RobertCNelson/pandaboard-docs/PandaboardA1/PandaA1.md

Adding docs for PandaboardA1 that I have.
