RobertCNelson/pandaboard-docs/PandaboardA1/panda-a-bom.xls

 | Manufacturer BOM Report
Item Number: | 750-2152-010-EBOM
Description: | EBOM, OMAP4430 PANDA BOARD, OMAP ES2.1, 8-LYR
Item Revision: | D ECN-13192
Level | Number | Rev | Description | Qty | Ref Des
 | Mfr. Name | Mfr. Part Number
0 | 750-2152-010-EBOM | D ECN-13192 | EBOM, OMAP4430 PANDA BOARD, OMAP ES2.1, 8-LYR
. 1 | 111-1000329 | C ECN-12735 | RES,4.02-KOHM,1%,0.063W,0402 | 1 | R169
 | NIC COMPONENTS | NRC04F4021TRF
 | PANASONIC | ERJ2RKF4021X
 | ROHM | MCR01MZPF4021
 | VISHAY | CRCW04024K02FKED
 | YAGEO | 9T04021A4021FBHF3
. 1 | 111-1000415 | B ECN-12078 | CONN,6 IN 1 SD/MMC CARD CAGE | 1 | J14
 | KINGCONN | SDMM-B0-0011
 | KINGCONN | SDMM-B0-0016
. 1 | 111-1000424 | B ECN-12024 | RES,2.7K-OHM,1%,0.063W,0402 | 1 | R138
 | PANASONIC | ERJ2RKF2701X
 | SUSUMU | RR0510P-272-D
. 1 | 111-1000836 | A ECN-10973 | CAP,CER,X5R,0603,6.3V,20%,10UF | 7 | C131,C148,C152,C154,C187,C204,C211
 | MURATA | GRM188R60J106ME47D
 | PANASONIC | ECJ-1VB0J106M
 | TAIYO YUDEN | JMK107BJ106MA-T
. 1 | 111-1001043 | A ECN-11225 | CAP,CER,COG,0402,50V,5%,1NF | 4 | C12,C13,C170,C182
 | MURATA | GRM1555C1H102JA01D
. 1 | 111-1001162 | A ECN-11362 | LED,635NM,DIFFUSED,0603,RED | 1 | D3
 | LUMEX | SML-LX0603IW-TR
. 1 | 111-1001197 | A ECN-11400 | CAP, CER, C0G, 0402, 50V, 5%, 12PF | 2 | C120,C121
 | MURATA | GRM1555C1H120JZ01D
. 1 | 111-1001336 | A ECN-11770 | IC,TFP410,DVI1.0 COMPLIANT 24 BIT RGB TO DIGITAL SERIAL TRANSMITTER | 1 | U2
 | TI | TFP410PAP
. 1 | 111-1001422 | A ECN-11612 | CAP, CER, X5R, 0402, 10V, 10%, 220NF | 2 | C72,C143
 | MURATA | GRM155R61A224KE19D
. 1 | 111-1001870 | A ECN-12093 | ESD PROTECTION ARRAY, 3-CHANNEL, +/-15KV, LOW CAPACITANCE | 1 | U25
 | TI | TPD3E001DRYR
. 1 | 111-1001969 | A ECN-11991 | IC,TWO BIT BI-DIRECTIONAL TRANSLATOR,TXS0102DCUR,VSSOP-DCU-8 | 1 | U3
 | TI | TXS0102DCUR
. 1 | 111-1002211 | A ECN-12174 | IC,REGULATOR,LDO,FIXED 3.3V,400MA,SOT23 | 1 | U11
 | TI | TPS73633DBVR
. 1 | 111-1002268 | A ECN-12268 | CAP,CER,X5R,0201,6.3V,10%,0.1UF | 58 | C20,C22,C27,C28,C29,C36,C38,C40,C41,C42,C44,C46,C47,C48,C49,C54,C57,C58,C59,C61,C62,C63,C69,C70,C74,C77,C78,C79,C80,C83,C84,C85,C89,C93,C94,C95,C101,C102,C108,C112,C113,C116,C119,C123,C127,C128,C134,C135,C138,C139,C140,C142,C144,C183,C189,C191,C195,C217
 | MURATA | GRM033R60J104KE19D
. 1 | 111-1002513 | B ECN-12929 | IC, 8-CHANNEL HDMI PORT EMI FILTER W/ ESD PROTECTION, 28WCSP | 1 | U6
 | TI | TPD12S015YFFR
. 1 | 111-1002519 | A ECN-12578 | IC,TPD6E001, 6 CHANNEL LOW CAPACITANCE 15KV ESD PROTECTION ARRAY, RSE | 2 | U16,U18
 | TI | TPD6E001RSER
. 1 | 111-1002526 | B ECN-12671 | CRYSTAL, SM, 32.768KHZ, 12.5PF-LOAD, ±20PPM @ -40 TO+85 C, MINIATURE CERAMIC (3X1.5X0.9MM) | 1 | Y2
 | CITIZEN | CM315
 | CITIZEN | CM315 32.768KDZF
. 1 | 111-1002534 | A ECN-12516 | CAP,CER,X5R,0402,10V,10%,1UF | 8 | C11,C43,C45,C88,C90,C92,C99,C100
 | MURATA | GRM155R61A105KE15D
. 1 | 111-1002537 | A ECN-12578 | CAP,CER,X5R,0402,6.3V,20%,2.2UF | 25 | C26,C33,C51,C52,C103,C104,C105,C106,C107,C109,C110,C115,C118,C124,C129,C133,C145,C149,C164,C165,C166,C167,C168,C194,C200
 | DIGIKEY | 490-4519-2-ND
 | TAIYO YUDEN | JMK105BJ225MV-F
. 1 | 111-1002559 | A ECN-12578 | RES,1K-OHM,1%,0.05W,0201 | 3 | R32,R89,R95
 | PANASONIC | ERJ1GEF1001C
 | ROHM | MCR006YZPF1001
. 1 | 111-1002575 | A ECN-12578 | IND, CHIP COIL, 1UH, 20%, 1200MA, SMT (SIZE 2520) | 1 | L6
 | FDK | MIPS2520D1R0
 | TAIYO YUDEN | CKP25201R0M-T
. 1 | 111-1002658 | A ECN-12578 | CAP,CER,X5R,0402,10V,10%,470NF | 12 | C37,C39,C60,C68,C73,C86,C122,C136,C137,C141,C190,C193
 | MURATA | GRM155R61A474KE15D
. 1 | 111-1002664 | B ECN-12684 | RES, 240 OHM, 1%, 0.063W, 0402 | 2 | R77,R87
 | ROHM | MCR01MZPF2400
 | VISHAY | CRCW0402240RFKED
. 1 | 111-1002666 | A ECN-12578 | INDUCTOR, CHIP, 1UH, 0805, 20%, 800MA,DCR=0.19OHMS | 5 | L9,L10,L14,L19,L20
 | MURATA | LQM21PN1R0MC0D
. 1 | 111-1002671 | A ECN-12578 | FERRITE BEAD, 120 OHM @ 100 MHZ, 1300MA, SMT, 0402 | 7 | L8,L11,L13,L21,L22,L24,L25
 | MURATA | BLM15PD121SN1D
. 1 | 111-1002680 | A ECN-12578 | INDUCTOR, CHIP, 68NH, 0402, 5%, 180MA, DCR=0.92OHMS | 1 | L26
 | MURATA | LQG15HS68NJ02D
. 1 | 111-1002717 | A ECN-12644 | CONN,RECEPTACLE,USB MINI-AB,5-PIN,SMT | 1 | J18
 | MOLEX | 56579-0576
. 1 | 111-1002735 | A ECN-12640 | FERRITE BEAD, 220 OHM @ 100 MHZ, 2200MA, SMT, 0603 | 8 | L1,L4,L5,L7,L12,L16,L18,L23
 | MURATA | BLM18KG221SN1D
. 1 | 111-1002740 | B ECN-12699 | FUSE, 2A FASTBLOW 32V, 0402, LITTLEFUSE 435 SERIES | 1 | F1
 | LITTELFUSE | 0435002.KR
 | LITTELFUSE | 0435002.KRHF
. 1 | 111-1002741 | B ECN-12699 | CAP, TANT, 7343, 25V, 20%, 47UF, POL | 1 | C171
 | AVX | TAJD476K025RNJ
 | VISHAY | 293D476X0025D2TE3
. 1 | 111-1002743 | B ECN-12977 | CAP,CER,X5R,0402,6.3V,+20%/-15%,4.7UF | 13 | C32,C34,C130,C147,C150,C153,C155,C158,C159,C176,C177,C181,C186
 | MURATA | GRM155R60J475ME87D
. 1 | 111-1002932 | A ECN-12736 | IC, USB TRANSCEIVER, HS, ULPI, INPUT/OUTPUT CLOCK MODES, QFN SMT | 1 | U8
 | SMSC | USB3320C-EZK
. 1 | 111-1002952 | A ECN-12742 | IC,INTEGRATED LOAD SWITCH,20V,SUPERSOT-6 | 2 | U15,U17
 | FAIRCHILD SEMI | FDC6330L
. 1 | 111-1003077 | A ECN-12864 | RES,3.32K-OHM,1%,0.063W,0402 | 6 | R90,R102,R109,R123,R128,R142
 | VISHAY | CRCW04023321F100
. 1 | 111-1003079 | A ECN-13015 | RES,33-OHM,1%,0.05W,0201 | 42 | R40,R41,R42,R43,R45,R46,R48,R49,R50,R51,R52,R53,R54,R64,R65,R66,R67,R68,R69,R70,R71,R72,R73,R76,R78,R80,R81,R82,R83,R84,R85,R112,R113,R117,R118,R120,R121,R124,R125,R126,R127,R140
 | ROHM | MCR006YZPF33R0
. 1 | 111-1003122 | A ECN-12895 | IC, LPDDR2, POP, OMAP4, (8 GBIT - 2GBIT X 4), 200MHZ, ELPIDA | 1 | UX10
 | ELPIDA | EDB8064B1PB-8D-F
. 1 | 111-1003139 | A ECN-12903 | CAP, CER, 22UF, X5R, 0805, +/-20%, 4V, 0.85MM THICK | 1 | C82
 | MURATA | GRM219R60G226ME66D
. 1 | 111-1003162 | A ECN-12925 | CONN, DB9 FEMALE,R/A, SOLDER SMD | 1 | P4
 | NORCOMP | 190-009-263R001
. 1 | 111-1003169 | A ECN-12925 | RES, 12.4K-OHM, 1%, 1/16W, 0402 | 2 | R23,R106
 | KOA SPEER | RK73G1ETTP1242F
 | KOA SPEER | RK73H1ETTP1242F
 | PANASONIC | ERJ2RKF1242X
 | ROHM | MCR01MZPF1242
 | YAGEO | RC0402FR-0712K4
. 1 | 111-1003172 | A ECN-12925 | IC, ETHERNET CONTROLLER/USB 4 PORT HUB, 10/100 ETHERNET | 1 | U9
 | SMSC | LAN9514-JZX
. 1 | 111-1003175 | A ECN-12948 | CRYSTAL, 25 MHZ, 8 PF, SMD, 8.0X4.5X1.8MM | 1 | Y1
 | DIGIKEY | 644-1028-1-ND
 | NDK | NX8045GB-25.000000MHZ
. 1 | 111-1003192 | A ECN-12925 | IC, LDO REGULATOR, ADJ, 1.5A, FAST, HIGH PSRR, 340MV DROPOUT, SOT223-6 | 1 | U23
 | TI | TL1963ADCQR
. 1 | 111-1003197 | A ECN-12925 | IC, PWR SWITCH+ADJ LDO,14-HTSSOP | 1 | U22
 | TI | TPS2141IPWP
. 1 | 111-1003199 | A ECN-12946 | IC, TPS2054B CURRENT LTD POWER DISTRIBUTION SWITCH | 1 | U7
 | TI | TPS2054BD
. 1 | 111-1003202 | A ECN-12948 | RES, 620K-OHM, 1%, 0.063W, 0402 | 1 | R172
 | PANASONIC | ERJ2RKF6203X
 | ROHM | MCR0004YZPF6203
 | VISHAY | CRCW0402620KFKEA
. 1 | 111-1003203 | A ECN-12948 | CONN, POWER JACK, 2.1MM, TH | 1 | P3
 | CUI INC | PJ-002A
 | DIGIKEY | CP-002A-ND
. 1 | 111-1003204 | A ECN-12948 | IC, 4-BIT BIDIRECTIONAL VOLTAGE TRANSLATOR, TXS0104 | 1 | U21
 | DIGIKEY | 296-20699-1-ND
 | DIGIKEY | 296-20699-2-ND
 | MOUSER ELECTRONICS | 595-TXS0104EZXUR
 | TI | TXS0104EZXUR
. 1 | 111-1003206 | A ECN-12948 | CAP, 100UF, 10V, SMT, 10%, 6032 | 4 | C21,C25,C75,C76
 | KEMET | B45196H2107K309
 | VISHAY SPRAGUE | 293D107X9010C2TE3
. 1 | 111-1003207 | A ECN-12948 | IC, SUPERVISOR, VOLT DETECTOR ADJ/1.5V, SC70-5 | 1 | U20
 | TI | TPS3803G15DCKR
. 1 | 111-1003208 | A ECN-12948 | CONN, RCPT, HDMI, R/A,SMD, TYPE A | 2 | P1,P2
 | DIGIKEY | 609-1010-1-ND
 | DIGIKEY | 609-1010-2-ND
 | FCI CONNECTORS | 10029449-001RLF
. 1 | 111-1003238 | A ECN-12967 | ANTENNA, 2.4GHZ BAND, CERAMIC CHIP | 1 | ANT1
 | TDK | ANT040015CCS2442MA1
. 1 | 111-1003239 | A ECN-12967 | CAP,CER. 0.3PF, 0402 | 1 | C9
 | JOHANSON TECHNOLOGY | 500R07S0R3BV4T
. 1 | 111-1003240 | A ECN-12967 | INDUCTOR 3.0NH CERAMIC 0402 | 1 | L3
 | JOHANSON TECHNOLOGY | L-07C3N0SV6T
. 1 | 111-1003245 | B ECN-13002 | CONNECTOR, USBX2 TYPE A AND 10/100BASE-TX ETHERNET STACKED WITH MAGNETICS AND LEDS | 1 | J9
 | BEL FUSE INC | 08C2-1X1T-03
 | BEL FUSE INC | 08C2-1X1T-36
 | TYCO | 6620004-1
. 1 | 111-1003247 | A ECN-12975 | CONN,DUAL 3.5MM AUDIO,STACKED | 1 | J16
 | KYCON | STX-4235-3/3-N
. 1 | 111-1003351 | A ECN-13015 | IND, 1.0UH, 3.0A, 1210, +/-20% | 1 | L17
 | MURATA | LQM32PN1R0MG0
. 1 | 111-1003359 | A ECN-13015 | INDUCTOR, CHIP, 0.68UH, 2 X 2 X 1MM, SHIELDED | 1 | L15
 | COILCRAFT | EPL2010-681MLC
. 1 | 111-1003381 | A ECN-13019 | CONN, HEADER,2X7, 2.54MM PITCH, THROUGH-HOLE | 1 | J8
 | FCI CONNECTORS | 67997-414HLF
. 1 | 111-1003382 | B ECN-13096 | IC, PHOENIX POWER, ES2.0, 7X7MM, 256 BALLS, 0.4MM PITCH, TWL6030 | 1 | U12
 | TI | PTWL6030BCMR
. 1 | 111-1003383 | A1 ECN-13082 | IC, PHOENIX AUDIO, ES1.1, 6X6MM, PBGA-120, 0.5MM PITCH, TWL6040 | 1 | U19
 | TI | TWL6040A1ZQZ
. 1 | 111-1003389 | B ECN-13028 | IC, RS-232 TRANSCEIVER, 3V-5.5V, 250KB/S, 16-SOP | 1 | U24
 | TI | MAX3232CDR
 | TI | MAX3232IDR
 | TI | SN65C3232EDR
 | TI | SN75C3232EDR
 | TI | TRS3232CDR
 | TI | TRS3232IDR
. 1 | 111-1003391 | B ECN-13162 | MODULE, RF, WL1271, 802.11B/G+BLUETOOTH | 1 | U4
 | LS RESEARCH | 450-0009
. 1 | 111-1003408 | A ECN-12939 | CAP, CER, X5R, 0402, 2.5V,+/-20%, 10UF | 5 | C146,C151,C156,C160,C161
 | MURATA | GRM155R60E106ME16D
. 1 | 111-1003414 | A ECN-12670 | INDUCTOR, CHIP, 82NH, 0603, 5%, 300MA, DCR=0.85OHMS | 1 | L27
 | MURATA | LQG18HN82NJ00D
. 1 | 111-1003454 | C ECN-13164 | OSC, 38.400 MHZ, 1.8V, CMOS, SMD, 5.0 X 3.2MM | 1 | Y3
 | TXC | 7C38470004
 | VECTRON | VC-801-JAW-KAAN-38M4000000
 | VECTRON | VCC4-H3B-38M4000000
. 1 | 111-1003474 | A ECN-12753 | PULSEGUARD, ESD SUPRESSOR, 0603, 24VDC, 45A | 4 | D4,D5,D6,D7
 | DIGIKEY | F2594TR-ND
 | LITTELFUSE | PGB1010603MR
. 1 | 111-1003493 | A1 ECN-13166 | IC, OMAP4430 PROCESSOR, ES2.1, GP, 12X12MM, FCPOP1 | 1 | U10
 | TI | X4430CCBL
 | TI | X4430CCBS
. 1 | 111-1003550 | A ECN-13172 | IC, 4-BIT BIDIRECTIONAL VOLTAGE TRANSLATOR, TXB0104 | 1 | U13
 | TI | TXB0104ZXUR
. 1 | 111-1003572 | A ECN-13192 | IC,SCHMITT-TRIGGER BUFFER, LOW PWR, 0.8V TO 3.6V,-40°C TO +85°C,SC-70 | 1 | U14
 | TI | SN74AUP1G17DCKR
. 1 | 207-0054-000 | A PNR-10008 | CAP,CER,X7R,0402,16V,10%,0.01UF | 3 | C126,C188,C192
 | AVX | 0402YC103KAT2A
 | KEMET | C0402C103K4RAC
 | PANASONIC | ECJ0EB1C103K
. 1 | 207-0068-000 | A PNR-10008 | CAP,CER,X5R,0402,10V,10%,100NF | 44 | C7,C8,C10,C14,C15,C17,C18,C19,C24,C30,C31,C35,C53,C55,C56,C64,C65,C66,C67,C71,C81,C87,C111,C125,C132,C157,C162,C163,C172,C173,C174,C175,C179,C180,C185,C197,C201,C202,C206,C207,C212,C213,C214,C215
 | AVX | 0402ZD104KAT2A
 | KEMET | C0402C104K8PAC
 | MURATA | GRM155R61A104KA01
 | PANASONIC | ECJ0EB1A104K
. 1 | 207-0105-000 | A PNR-10105 | CAP,CER,X5R,0805,10V,10%,4.7UF | 1 | C208
 | MURATA | GRM219R61A475KE19J
 | PANASONIC | ECJ2FB1A475K
. 1 | 207-0165-000 | B ECN-12775 | CAP,CER,X5R,0603,6.3V,10%,4.7UF | 5 | C23,C50,C196,C198,C199
 | AVX | 06036D475KAT2A
 | MURATA | GRM188R60J475KE19D
. 1 | 207-0226-000 | A PNR-10105 | CAP,CER,NPO,0402, 50V, 5%, 18PF | 4 | C97,C98,C203,C205
 | AVX | 04025A180JAT2A
 | KEMET | C0402C180J5GAC
. 1 | 257-0020-000 | A PNR-10074 | LED,565NM,WATER-CLEAR,3216,GRN | 2 | D1,D2
 | LITEON ELECTRONICS | LTST-C150GKT
. 1 | 272-0029-000 | B ECN-10775 | RES,10K-OHM,1%,0.063W,0402 | 18 | R28,R30,R31,R36,R39,R55,R56,R57,R58,R60,R79,R86,R99,R100,R114,R141,R147,R170
 | PANASONIC | ERJ2RKF1002X
 | ROHM | MCR01MZPF1002
. 1 | 272-0065-000 | B ECN-12846 | RES,0.0-OHM,RES-MAX-60M-OHM,CUR-MAX1A,0402,JUMPER | 24 | R6,R7,R8,R9,R10,R11,R12,R13,R14,R15,R19,R20,R21,R22,R25,R26,R27,R59,R62,R63,R92,R150,R151,R160
 | KOA SPEER ELECTRONICS, INC. | RK73Z1ETTP
 | PANASONIC | ERJ2GE0R00X
. 1 | 272-0093-000 | A PNR-10081 | RES,10-OHM,1%,0.063W,0402 | 1 | R133
 | KOA | RK73H1ETTD10R0F
 | PANASONIC | ERJ2RKF10R0X
. 1 | 272-0177-000 | B ECN-10775 | RES,100K-OHM,1%,0.063W,0402 | 5 | R149,R153,R158,R162,R168
 | PANASONIC | ERJ2RKF1003X
 | ROHM | MCR01MZPF1003
. 1 | 272-0198-000 | B ECN-10775 | RES,100-OHM,1%,0.063W,0402 | 2 | R108,R132
 | PANASONIC | ERJ2RKF1000X
 | ROHM | MCR01MZPF1000
. 1 | 272-0200-000 | A PNR-10084 | RES,1K-OHM,1%,0.063W,0402 | 1 | R152
 | PANASONIC | ERJ2RKF1001X
 | ROHM | MCR01MZSF102
. 1 | 272-0206-000 | A PNR-10085 | RES,1M-OHM,1%,0.063W,0402 | 2 | R110,R139
 | KOA | RK73H1ELTD1004F
 | PANASONIC | ERJ2RKF1004X
 | ROHM | MCR01MZSF105
 | YAGEO | 9C04021A1004FLHF3
. 1 | 272-0209-000 | B ECN-12685 | RES,4.7K-OHM,1%,0.063W,0402 | 3 | R1,R24,R29
 | KOA | RK73H1ELTD4701F
 | KOA | RK73H1ETTP4701F
. 1 | 272-0251-000 | A PNR-10093 | RES,510-OHM,1%,0.063W,0603 | 1 | R17
 | PANASONIC | ERJ3EKF5100V
. 1 | 272-0270-000 | B ECN-10874 | RES,150K-OHM,1%,0.063W,0402 | 2 | R154,R167
 | KOA SPEER | RK73H1ETTP1503F
 | ROHM | MCR01MZSF1503
. 1 | 272-0349-000 | B ECN-12894 | RES,390-OHM,5%,0.250W,1206 | 1 | R165
 | KOA | RK73B2BLTD391J
 | PANASONIC | ERJ-8GEYJ391V
 | ROHM | MCR18EZPJ391
 | STACKPOLE ELECTRONICS | RMCF1206JT390R
 | VISHAY | CRCW1206390RJNEA
 | YAGEO | RC1206JR-07390RL
. 1 | 272-0381-000 | A PNR-10086 | RES,200K-OHM,1%,0.063W,0402 | 1 | R173
 | PANASONIC | ERJ2RKF2003X
. 1 | 272-0421-000 | A PNR-10089 | RES,330-OHM,5%,0.063W,0402 | 2 | R91,R96
 | PANASONIC | ERJ2GEJ331X
 | ROHM | MCR01MZSJ331
. 1 | 272-0426-000 | B ECN-12932 | RES,33K-OHM,1%,0.063W,0402 | 1 | R164
 | ROHM | MCR01MZSF333
 | YAGEO | 9C04021A3302FLHF3
 | YAGEO | RC0402FR-0733KL
. 1 | 272-0444-000 | A.1 ECN-10669 | RES,0.0-OHM,5%,0.125W,0805 | 1 | R4
 | VISHAY | CRCW08050000Z0EA
 | YAGEO | RC0805JR-130R0
. 1 | 272-0457-000 | C ECN-11298 | RES,49.9-OHM,1%,0.063W,0402 | 6 | R107,R111,R116,R129,R155,R156
 | KOA SPEER | RK73H1ETTP49R9F
 | YAGEO | 9C04021A49R9FLHF3
 | YAGEO | RC0402FR-0749R9L
. 1 | 272-0473-000 | B ECN-12692 | RES,8.06K-OHM,1%,0.100W,0603 | 1 | R47
 | KOA | RK73H1JLTD8061F
 | KOA | RK73H1JTTD8061F
. 1 | 272-0494-000 | A PNR-10079 | RES,0.0-OHM,JUMPER,0.05W,0201 | 2 | R44,R206
 | PANASONIC | ERJ1GE0R00C
. 1 | 272-0766-000 | A ECN-11034 | RES, 15 OHM, 5%, 0.063W, 0402 | 2 | R161,R163
 | ROHM | MCR01MZPJ150
. 1 | 272-0774-000 | B ECN-11242 | RES, 4.7K OHM, 1%, 0.063W, 0402 | 1 | R115
 | KOA SPEER ELECTRONICS, INC. | RK73H1ETTP4701F
 | ROHM | MCR01MZPF4701
 | VISHAY | CRCW04024701F
. 1 | 272-0775-000 | A ECN-11032 | RES, 12K OHM, 1%, 0.063W, 0402 | 1 | R104
 | ROHM | MCR01MZPF1202
. 1 | 276-0037-000 | A.1 ECN-11932 | SW,TACTILE,4.3MM HT X 9.0MM PITCH,SMT | 2 | S1,S2
 | OMRON | B3S-1000P
. 1 | 289-0056-000 | B ECN-13000 | TRANSISTOR,NPN,SWITCHING,50V,100MA,6-PIN,US6 | 1 | T1
 | INFINEON | BCR135S
 | PANASONIC | DMC56404
 | PANASONIC | XP04214
 | TOSHIBA | RN1907
. 1 | 289-0091-000 | B ECN-12738 | MOSFET,N-CHANNEL,20V,2.5A,SOT23 | 2 | Q1,Q2
 | NXP | PMV56XN,215
. 1 | NOT_USED | A PNR-10113 | NOT INSTALLED COMPONENT | 103 | C1,C2,C3,C4,C5,C6,C16,C91,C96,C114,C117,C169,C178,C184,C209,C210,C216,R2,R3,R5,R16,R18,R33,R34,R35,R37,R38,R61,R74,R75,R88,R93,R94,R97,R98,R101,R103,R105,R119,R122,R130,R131,R134,R135,R136,R137,R143,R144,R145,R146,R148,R157,R159,R166,R171,R174,R175,R176,R177,R178,R179,R180,R181,R182,R183,R184,R185,R186,R187,R188,R189,R190,R191,R192,R193,R194,R195,R196,R197,R198,R199,R200,R201,R202,R203,R204,R205,L2,U1,U5,J1,J2,J3,J4,J5,J6,J7,J10,J11,J12,J13,J15,J17
Created By: | McKinley, Curt (cmckinley)
Create Time: | 11/29/2010 06:06:54 PM CST
