RobertCNelson/pandaboard-docs/PandaboardES-B1/panda-es-b-bom.xls

Item Number: | 750-2170-002-EBOM
Description: | EBOM, OMAP4460 PANDABOARD, OMAP ES1.1, GP, 1.2G, PWR ES2.1, AUD ES2.0, 8-LYR, TIWI-BLE MODULE
Item Revision: | B ECN-13455
Level | Number | Rev | Description | Qty | Ref Des
 | Mfr. Name | Mfr. Part Number
0 | 750-2170-002-EBOM | B ECN-13455 | EBOM, OMAP4460 PANDABOARD, OMAP ES1.1, GP, 1.2G, PWR ES2.1, AUD ES2.0, 8-LYR, TIWI-BLE MODULE
. 1 | 111-1000415 | B ECN-12078 | CONN,6 IN 1 SD/MMC CARD CAGE | 1 | J14
 | KINGCONN | SDMM-B0-0011
 | KINGCONN | SDMM-B0-0016
. 1 | 111-1000836 | A ECN-10973 | CAP,CER,X5R,0603,6.3V,20%,10UF | 6 | C115,C131,C134,C136,C169,C193
 | MURATA | GRM188R60J106ME47D
 | PANASONIC | ECJ-1VB0J106M
 | TAIYO YUDEN | JMK107BJ106MA-T
. 1 | 111-1001043 | A ECN-11225 | CAP,CER,COG,0402,50V,5%,1NF | 2 | C152,C164
 | MURATA | GRM1555C1H102JA01D
. 1 | 111-1001044 | C ECN-12877 | CAP,CER,X7R,0402,16V,10%,15NF | 1 | C181
 | AVX | 0402YC153KAT2A
 | KEMET | C0402C153K4RACTU
 | MURATA | GRM155R71C153KA01D
 | TAIYO YUDEN | EMK105B153KW
 | TDK | C1005X7R1C153K
 | YAGEO | 2.23879E+11
. 1 | 111-1001162 | A ECN-11362 | LED,635NM,DIFFUSED,0603,RED | 1 | D3
 | LUMEX | SML-LX0603IW-TR
. 1 | 111-1001197 | A ECN-11400 | CAP, CER, C0G, 0402, 50V, 5%, 12PF | 2 | C102,C103
 | MURATA | GRM1555C1H120JZ01D
. 1 | 111-1001336 | A ECN-11770 | IC,TFP410,DVI1.0 COMPLIANT 24 BIT RGB TO DIGITAL SERIAL TRANSMITTER | 1 | U1
 | TI | TFP410PAP
. 1 | 111-1001422 | A ECN-11612 | CAP, CER, X5R, 0402, 10V, 10%, 220NF | 2 | C64,C126
 | MURATA | GRM155R61A224KE19D
. 1 | 111-1001969 | A ECN-11991 | IC,TWO BIT BI-DIRECTIONAL TRANSLATOR,TXS0102DCUR,VSSOP-DCU-8 | 1 | U2
 | TI | TXS0102DCUR
. 1 | 111-1002211 | A ECN-12174 | IC,REGULATOR,LDO,FIXED 3.3V,400MA,SOT23 | 1 | U9
 | TI | TPS73633DBVR
. 1 | 111-1002268 | A ECN-12268 | CAP,CER,X5R,0201,6.3V,10%,0.1UF | 65 | C18,C19,C25,C26,C27,C34,C36,C38,C39,C40,C42,C44,C45,C46,C47,C54,C55,C56,C57,C65,C68,C69,C72,C75,C78,C79,C85,C86,C92,C98,C101,C105,C110,C111,C118,C119,C121,C122,C123,C125,C127,C165,C171,C173,C177,C200,C201,C202,C204,C205,C206,C207,C211,C212,C214,C215,C217,C220,C221,C223,C225,C226,C227,C228,C229
 | MURATA | GRM033R60J104KE19D
. 1 | 111-1002519 | A ECN-12578 | IC,TPD6E001, 6 CHANNEL LOW CAPACITANCE 15KV ESD PROTECTION ARRAY, RSE | 2 | U15,U17
 | TI | TPD6E001RSER
. 1 | 111-1002526 | C ECN-12737 | CRYSTAL, SM, 32.768KHZ, 12.5PF-LOAD, ±20PPM @ -40 TO+85 C, MINIATURE CERAMIC (3X1.5X0.9MM) | 1 | Y2
 | MICRO CRYSTAL | CC7V-T1A-32.768KHZ-12.5PF-20PPM-TA-QC
 | MICRO CRYSTAL | CM7V-T1A-32.768KHZ-12.5PF-20PPM-TA-QC
. 1 | 111-1002529 | A ECN-12578 | CAP,CER,X5R,0402,16V,10%,100NF | 1 | C187
 | MURATA | GRM155R61C104KA88B
. 1 | 111-1002534 | A ECN-12516 | CAP,CER,X5R,0402,10V,10%,1UF | 3 | C11,C74,C198
 | MURATA | GRM155R61A105KE15D
. 1 | 111-1002535 | A ECN-12578 | CAP,CER,X7R,0805,16V,10%,4.7UF | 2 | C233,C234
 | MURATA | GRM21BR71C475KA73K
. 1 | 111-1002537 | A ECN-12578 | CAP,CER,X5R,0402,6.3V,20%,2.2UF | 27 | C22,C31,C49,C50,C87,C88,C89,C90,C91,C93,C94,C97,C100,C107,C113,C117,C128,C132,C143,C146,C147,C148,C149,C150,C175,C184,C231
 | TAIYO YUDEN | JMK105BJ225MV-F
. 1 | 111-1002559 | A ECN-12578 | RES,1K-OHM,1%,0.05W,0201 | 6 | R26,R91,R94,R114,R117,R146
 | PANASONIC | ERJ1GEF1001C
 | ROHM | MCR006YZPF1001
. 1 | 111-1002575 | A ECN-12578 | IND, CHIP COIL, 1UH, 20%, 1200MA, SMT (SIZE 2520) | 1 | L5
 | FDK | MIPS2520D1R0
 | TAIYO YUDEN | CKP25201R0M-T
. 1 | 111-1002606 | A ECN-12578 | IC, 4-CHANNEL ESD PROTECTION FOR HSUSB/USBOTG INTERFACE | 1 | U24
 | TI | TPD4S012DRYR
. 1 | 111-1002658 | A ECN-12578 | CAP,CER,X5R,0402,10V,10%,470NF | 13 | C35,C37,C70,C104,C106,C112,C120,C124,C166,C172,C203,C222,C230
 | MURATA | GRM155R61A474KE15D
. 1 | 111-1002666 | A ECN-12578 | INDUCTOR, CHIP, 1UH, 0805, 20%, 800MA,DCR=0.19OHMS | 2 | L8,L9
 | MURATA | LQM21PN1R0MC0D
. 1 | 111-1002671 | A ECN-12578 | FERRITE BEAD, 120 OHM @ 100 MHZ, 1300MA, SMT, 0402 | 5 | L7,L10,L17,L19,L20
 | MURATA | BLM15PD121SN1D
. 1 | 111-1002717 | A ECN-12644 | CONN,RECEPTACLE,USB MINI-AB,5-PIN,SMT | 1 | J18
 | MOLEX | 56579-0576
. 1 | 111-1002735 | A ECN-12640 | FERRITE BEAD, 220 OHM @ 100 MHZ, 2200MA, SMT, 0603 | 9 | L1,L3,L4,L6,L11,L13,L15,L18,L22
 | MURATA | BLM18KG221SN1D
. 1 | 111-1002741 | B ECN-12699 | CAP, TANT, 7343, 25V, 20%, 47UF, POL | 1 | C153
 | AVX | TAJD476K025RNJ
 | VISHAY | 293D476X0025D2TE3
. 1 | 111-1002743 | B ECN-12977 | CAP,CER,X5R,0402,6.3V,+20%/-15%,4.7UF | 16 | C30,C32,C114,C130,C133,C135,C137,C139,C141,C158,C159,C163,C168,C199,C210,C236
 | MURATA | GRM155R60J475ME87D
. 1 | 111-1002932 | A ECN-12736 | IC, USB TRANSCEIVER, HS, ULPI, INPUT/OUTPUT CLOCK MODES, QFN SMT | 1 | U7
 | SMSC | USB3320C-EZK
. 1 | 111-1002952 | A ECN-12742 | IC,INTEGRATED LOAD SWITCH,20V,SUPERSOT-6 | 2 | U14,U16
 | FAIRCHILD SEMI | FDC6330L
. 1 | 111-1003077 | A ECN-12864 | RES,3.32K-OHM,1%,0.063W,0402 | 7 | R92,R101,R108,R118,R123,R128,R143
 | VISHAY | CRCW04023321F100
. 1 | 111-1003079 | A ECN-13015 | RES,33-OHM,1%,0.05W,0201 | 42 | R38,R39,R40,R41,R43,R44,R45,R46,R49,R50,R52,R53,R62,R63,R64,R65,R66,R67,R68,R72,R73,R74,R75,R78,R80,R82,R83,R84,R85,R86,R87,R115,R116,R119,R120,R124,R125,R126,R127,R129,R131,R141
 | ROHM | MCR006YZPF33R0
. 1 | 111-1003122 | A ECN-12895 | IC, LPDDR2, POP, OMAP4, (8 GBIT - 2GBIT X 4), 200MHZ, ELPIDA | 1 | UX10
 | ELPIDA | EDB8064B1PB-8D-F
. 1 | 111-1003162 | A ECN-12925 | CONN, DB9 FEMALE,R/A, SOLDER SMD | 1 | P4
 | NORCOMP | 190-009-263R001
. 1 | 111-1003169 | A ECN-12925 | RES, 12.4K-OHM, 1%, 1/16W, 0402 | 2 | R17,R105
 | KOA SPEER | RK73G1ETTP1242F
 | KOA SPEER | RK73H1ETTP1242F
 | PANASONIC | ERJ2RKF1242X
 | ROHM | MCR01MZPF1242
 | YAGEO | RC0402FR-0712K4
. 1 | 111-1003172 | A ECN-12925 | IC, ETHERNET CONTROLLER/USB 4 PORT HUB, 10/100 ETHERNET | 1 | U8
 | SMSC | LAN9514-JZX
. 1 | 111-1003175 | A ECN-12948 | CRYSTAL, 25 MHZ, 8 PF, SMD, 8.0X4.5X1.8MM | 1 | Y1
 | NDK | NX8045GB-25.000000MHZ
. 1 | 111-1003197 | A ECN-12925 | IC, PWR SWITCH+ADJ LDO,14-HTSSOP | 1 | U21
 | TI | TPS2141IPWP
. 1 | 111-1003199 | A ECN-12946 | IC, TPS2054B CURRENT LTD POWER DISTRIBUTION SWITCH | 1 | U6
 | TI | TPS2054BD
. 1 | 111-1003202 | A ECN-12948 | RES, 620K-OHM, 1%, 0.063W, 0402 | 1 | R174
 | PANASONIC | ERJ2RKF6203X
 | ROHM | MCR0004YZPF6203
 | VISHAY | CRCW0402620KFKEA
. 1 | 111-1003203 | A ECN-12948 | CONN, POWER JACK, 2.1MM, TH | 1 | P3
 | CUI INC | PJ-002A
. 1 | 111-1003204 | A ECN-12948 | IC, 4-BIT BIDIRECTIONAL VOLTAGE TRANSLATOR, TXS0104 | 1 | U20
 | TI | TXS0104EZXUR
. 1 | 111-1003206 | A ECN-12948 | CAP, 100UF, 10V, SMT, 10%, 6032 | 4 | C20,C24,C66,C67
 | KEMET | B45196H2107K309
 | VISHAY SPRAGUE | 293D107X9010C2TE3
. 1 | 111-1003207 | A ECN-12948 | IC, SUPERVISOR, VOLT DETECTOR ADJ/1.5V, SC70-5 | 1 | U19
 | TI | TPS3803G15DCKR
. 1 | 111-1003208 | A ECN-12948 | CONN, RCPT, HDMI, R/A,SMD, TYPE A | 2 | P1,P2
 | FCI CONNECTORS | 10029449-001RLF
. 1 | 111-1003238 | A ECN-12967 | ANTENNA, 2.4GHZ BAND, CERAMIC CHIP | 1 | ANT1
 | TDK | ANT040015CCS2442MA1
. 1 | 111-1003245 | B ECN-13002 | CONNECTOR, USBX2 TYPE A AND 10/100BASE-TX ETHERNET STACKED WITH MAGNETICS AND LEDS | 1 | J9
 | BEL FUSE INC | 08C2-1X1T-03
 | BEL FUSE INC | 08C2-1X1T-36
 | TYCO | 6620004-1
. 1 | 111-1003247 | A ECN-12975 | CONN,DUAL 3.5MM AUDIO,STACKED | 1 | J16
 | KYCON | STX-4235-3/3-N
. 1 | 111-1003351 | A2 ECN-13331 | IND, 1.0UH, 1.8A, 1210, +/-20%, DCR=0.048OHM | 1 | L14
 | MURATA | LQM32PN1R0MG0
. 1 | 111-1003359 | A ECN-13015 | INDUCTOR, CHIP, 0.68UH, 2 X 2 X 1MM, SHIELDED | 1 | L12
 | COILCRAFT | EPL2010-681MLC
. 1 | 111-1003364 | A ECN-13042 | CAP, CER, 47UF, 20%, X5R, 6.3V,0805, 1.25MM TALL | 2 | C176,C237
 | TAIYO YUDEN | JMK212BJ476MG-T
. 1 | 111-1003381 | A ECN-13019 | CONN, HEADER,2X7, 2.54MM PITCH, THROUGH-HOLE | 1 | J8
 | FCI CONNECTORS | 67997-414HLF
. 1 | 111-1003389 | B ECN-13028 | IC, RS-232 TRANSCEIVER, 3V-5.5V, 250KB/S, 16-SOP | 1 | U23
 | TI | MAX3232CDR
 | TI | MAX3232IDR
 | TI | SN65C3232EDR
 | TI | SN75C3232EDR
 | TI | TRS3232CDR
 | TI | TRS3232IDR
. 1 | 111-1003454 | C ECN-13164 | OSC, 38.400 MHZ, 1.8V, CMOS, SMD, 5.0 X 3.2MM | 1 | Y3
 | TXC | 7C38470004
 | VECTRON | VC-801-JAW-KAAN-38M4000000
 | VECTRON | VCC4-H3B-38M4000000
. 1 | 111-1003474 | A ECN-12753 | PULSEGUARD, ESD SUPRESSOR, 0603, 24VDC, 45A | 4 | D4,D5,D6,D7
 | LITTELFUSE | PGB1010603MR
. 1 | 111-1003550 | A ECN-13172 | IC, 4-BIT BIDIRECTIONAL VOLTAGE TRANSLATOR, TXB0104 | 1 | U12
 | TI | TXB0104ZXUR
. 1 | 111-1003570 | B ECN-13256 | IC, TPS62361, PROCESSOR CORE SUPPLY, I2C, 3A. STEP DOWN DC-DC | 1 | U25
 | TI | TPS62361YZHR
. 1 | 111-1003687 | A ECN-13243 | CAP, CER, 10UF, X5R, 0402, 20%, 6.3V | 4 | C129,C138,C142,C213
 | MURATA | GRM155R60J106ME44
. 1 | 111-1003696 | A ECN-13243 | CAP, CER, X5R, 0201, 6.3V, +/-20%, 1UF | 11 | C41,C43,C77,C83,C84,C208,C209,C216,C218,C219,C224
 | MURATA | GRM033R60J105MEA2D
. 1 | 111-1003700 | A ECN-13241 | IC, PHOENIX AUDIO, ES2.0, 6X6MM, PBGA-120, 0.5MM PITCH, TWL6040 | 1 | U18
 | TI | TWL6040BZQZ
. 1 | 111-1003740 | A ECN-12836 | IND, POWER, 1.0UH, 30%, 1400MA, 0806 | 1 | L16
 | MURATA | LQM2MPN1R0NG0L
. 1 | 111-1003772 | A ECN-12752 | RES, 240 OHM, 1%, 0.05W, 0201 | 2 | R79,R89
 | PANASONIC | ERJ-1GEF2400C
 | VISHAY | CRCW0201240RFNED
. 1 | 111-1003783 | A ECN-12752 | SW, SLIDE, 1PSN, SMT | 1 | SW1
 | COPAL ELECTRONICS | CHS-01TA
. 1 | 111-1003795 | A ECN-13272 | IC, PHOENIX POWER, ES2.0, 7X7MM, 256 BALLS, 0.4MM PITCH, TWL6030, 4460 TRIMMED(1A4) | 1 | U11
 | TI | PTWL6030B1A4CMR
. 1 | 111-1003800 | A ECN-11135 | IC, 4.5-17V INPUT, 3A SYNC STEP DOWN SWIFT™ CONVERTER | 1 | U22
 | TI | TPS54320RHL
. 1 | 111-1003801 | A ECN-11135 | IND, 6.8UH, 0.032-DCR, 4.0A, SMT | 1 | L21
 | TDK | VLP8040T-6R8M
. 1 | 111-1003802 | A ECN-11135 | RES,1.78K-OHM,1%,0.063W,0402 | 1 | R170
 | STACKPOLE ELECTRONICS | RMCF0402FT1K78
 | VISHAY | CRCW04021K78FKED
. 1 | 111-1003803 | A ECN-11135 | CAP, CER, 91PF, C0G, +/-5%, 50V, 0402 | 1 | C232
 | KEMET | C0402C910J5GACTU
 | TDK | C1005C0G1H910J
. 1 | 111-1003807 | A ECN-10882 | IND, 1.0UH, +/-20%, 0.051 OHM DCR, 2.6A, SMT, 1210 | 1 | L23
 | CYNTEC | PST32251B-1R0MS-11
. 1 | 111-1003812 | A ECN-13287 | IC, 8-CHANNEL HDMI PORT EMI FILTER W/ ESD PROTECTION, 28WCSP | 1 | U5
 | TI | TPD12S015AYFFR
. 1 | 111-1003817 | A ECN-13272 | MODULE, RF, WL1271, 802.11B/G+BLUETOOTH, BLE | 1 | U3
 | LS RESEARCH | TIWI-BLE
. 1 | 111-1004044 | A ECN-13363 | IC, OMAP4460 PROCESSOR, ES1.1, GP, 1.2G, 12X12MM, FCPOP1 | 1 | U10
 | TI | X4460BCBL
 | TI | X4460BUCBL
. 1 | 111-1004093 | A ECN-13398 | FUSE, 1.5A FASTBLOW 32V, 0402, LITTLEFUSE 435 SERIES | 1 | F1
 | LITTELFUSE | 043501.5KR
. 1 | 111-1004104 | A ECN-13411 | DIODE,RECTIFIER,SCHOTTKY, 30V, 1A, 0.31VF, POWERDI 123, SMT | 1 | D8
 | DIODES INC | DFLS130L-7
. 1 | 111-1004108 | A ECN-13411 | RES, 0.02-OHMS, 1%, 0.20W, 75PPM, 0603, CURRENT SENSE | 1 | R186
 | VISHAY | WSL0603R0200FEA18
. 1 | 207-0007-000 | B ECN-12735 | CAP,CER,X7R,0402,50V,10%,330PF | 1 | C183
 | BC COMPONENTS | 0402B331K500BT
 | MURATA | GRM155R71H331KA01D
 | PANASONIC | ECJ0EB1H331K
 | VISHAY | VJ0402Y331KXACW1BC
. 1 | 207-0054-000 | A PNR-10008 | CAP,CER,X7R,0402,16V,10%,0.01UF | 4 | C109,C170,C174,C185
 | AVX | 0402YC103KAT2A
 | KEMET | C0402C103K4RAC
 | PANASONIC | ECJ0EB1C103K
. 1 | 207-0068-000 | A PNR-10008 | CAP,CER,X5R,0402,10V,10%,100NF | 43 | C7,C8,C10,C12,C13,C15,C16,C17,C23,C28,C29,C33,C51,C52,C53,C58,C60,C61,C62,C63,C71,C73,C95,C108,C116,C140,C144,C145,C154,C155,C156,C157,C161,C162,C167,C179,C186,C188,C189,C194,C195,C196,C197
 | AVX | 0402ZD104KAT2A
 | KEMET | C0402C104K8PAC
 | MURATA | GRM155R61A104KA01
 | PANASONIC | ECJ0EB1A104K
. 1 | 207-0105-000 | A PNR-10105 | CAP,CER,X5R,0805,10V,10%,4.7UF | 1 | C190
 | MURATA | GRM219R61A475KE19J
 | PANASONIC | ECJ2FB1A475K
. 1 | 207-0165-000 | B ECN-12775 | CAP,CER,X5R,0603,6.3V,10%,4.7UF | 5 | C21,C48,C178,C180,C182
 | AVX | 06036D475KAT2A
 | MURATA | GRM188R60J475KE19D
. 1 | 207-0226-000 | A PNR-10105 | CAP,CER,NPO,0402, 50V, 5%, 18PF | 2 | C81,C82
 | AVX | 04025A180JAT2A
 | KEMET | C0402C180J5GAC
. 1 | 224-0280-000 | B ECN-11718 | CONN, TEST POINT, SINGLE HOOP, COMPACT, SMT | 1 | GND1
 | KEYSTONE ELECTRONICS | 5016
. 1 | 246-0092-000 | B ECN-11714 | IND, 5.6NH, +/-0.2NH, 340MA, 0.19 OHM, 0402, SMT | 1 | L2
 | PANASONIC | ELJRF5N6ZFB
. 1 | 252-0271-000 | B ECN-11718 | IC,SINGLE BUFFER/DRIVER WITH OPEN-DRAIN OUTPUT,SC-70-5 | 1 | U13
 | TI | SN74LVC1G07DCKR
. 1 | 257-0020-000 | A PNR-10074 | LED,565NM,WATER-CLEAR,3216,GRN | 2 | D1,D2
 | LITEON ELECTRONICS | LTST-C150GKT
. 1 | 272-0029-000 | B ECN-10775 | RES,10K-OHM,1%,0.063W,0402 | 17 | R22,R24,R25,R31,R34,R54,R55,R56,R57,R59,R81,R88,R95,R97,R142,R149,R183
 | PANASONIC | ERJ2RKF1002X
 | ROHM | MCR01MZPF1002
. 1 | 272-0065-000 | B ECN-12846 | RES,0.0-OHM,RES-MAX-60M-OHM,CUR-MAX1A,0402,JUMPER | 27 | R4,R5,R6,R7,R8,R9,R10,R11,R14,R19,R20,R21,R58,R61,R70,R121,R122,R152,R153,R156,R157,R159,R181,R182,R185.R187,C235
 | KOA SPEER ELECTRONICS, INC. | RK73Z1ETTP
 | PANASONIC | ERJ2GE0R00X
. 1 | 272-0093-000 | A PNR-10081 | RES,10-OHM,1%,0.063W,0402 | 1 | R135
 | KOA | RK73H1ETTD10R0F
 | PANASONIC | ERJ2RKF10R0X
. 1 | 272-0177-000 | B ECN-10775 | RES,100K-OHM,1%,0.063W,0402 | 6 | R151,R154,R158,R162,R169,R173
 | PANASONIC | ERJ2RKF1003X
 | ROHM | MCR01MZPF1003
. 1 | 272-0198-000 | B ECN-10775 | RES,100-OHM,1%,0.063W,0402 | 2 | R107,R134
 | PANASONIC | ERJ2RKF1000X
 | ROHM | MCR01MZPF1000
. 1 | 272-0206-000 | A PNR-10085 | RES,1M-OHM,1%,0.063W,0402 | 2 | R109,R140
 | KOA | RK73H1ELTD1004F
 | PANASONIC | ERJ2RKF1004X
 | ROHM | MCR01MZSF105
 | YAGEO | 9C04021A1004FLHF3
. 1 | 272-0209-000 | B ECN-12685 | RES,4.7K-OHM,1%,0.063W,0402 | 3 | R1,R18,R23
 | KOA | RK73H1ELTD4701F
 | KOA | RK73H1ETTP4701F
. 1 | 272-0251-000 | A PNR-10093 | RES,510-OHM,1%,0.063W,0603 | 1 | R13
 | PANASONIC | ERJ3EKF5100V
. 1 | 272-0270-000 | B ECN-10874 | RES,150K-OHM,1%,0.063W,0402 | 2 | R155,R168
 | KOA SPEER | RK73H1ETTP1503F
 | ROHM | MCR01MZSF1503
. 1 | 272-0349-000 | B ECN-12894 | RES,390-OHM,5%,0.250W,1206 | 1 | R166
 | KOA | RK73B2BLTD391J
 | PANASONIC | ERJ-8GEYJ391V
 | ROHM | MCR18EZPJ391
 | STACKPOLE ELECTRONICS | RMCF1206JT390R
 | VISHAY | CRCW1206390RJNEA
 | YAGEO | RC1206JR-07390RL
. 1 | 272-0381-000 | A PNR-10086 | RES,200K-OHM,1%,0.063W,0402 | 1 | R175
 | PANASONIC | ERJ2RKF2003X
. 1 | 272-0421-000 | A PNR-10089 | RES,330-OHM,5%,0.063W,0402 | 2 | R93,R98
 | PANASONIC | ERJ2GEJ331X
 | ROHM | MCR01MZSJ331
. 1 | 272-0426-000 | B ECN-12932 | RES,33K-OHM,1%,0.063W,0402 | 1 | R165
 | ROHM | MCR01MZSF333
 | YAGEO | 9C04021A3302FLHF3
 | YAGEO | RC0402FR-0733KL
. 1 | 272-0457-000 | C ECN-11298 | RES,49.9-OHM,1%,0.063W,0402 | 4 | R106,R110,R113,R130
 | KOA SPEER | RK73H1ETTP49R9F
 | YAGEO | 9C04021A49R9FLHF3
 | YAGEO | RC0402FR-0749R9L
. 1 | 272-0473-000 | B ECN-12692 | RES,8.06K-OHM,1%,0.100W,0603 | 1 | R42
 | KOA | RK73H1JLTD8061F
 | KOA | RK73H1JTTD8061F
. 1 | 272-0494-000 | A PNR-10079 | RES,0.0-OHM,JUMPER,0.05W,0201 | 3 | R47,R51,R177
 | PANASONIC | ERJ1GE0R00C
. 1 | 272-0609-000 | B ECN-12684 | RES,36.5K-OHM,1%,0.063W,0402 | 1 | R184
 | ROHM | MCR01MZSF3652
 | VISHAY | CRCW040236K5FKED
. 1 | 272-0766-000 | A ECN-11034 | RES, 15 OHM, 5%, 0.063W, 0402 | 2 | R161,R163
 | ROHM | MCR01MZPJ150
. 1 | 272-0775-000 | A ECN-11032 | RES, 12K OHM, 1%, 0.063W, 0402 | 1 | R103
 | ROHM | MCR01MZPF1202
. 1 | 276-0037-000 | A.1 ECN-11932 | SW,TACTILE,4.3MM HT X 9.0MM PITCH,SMT | 2 | S1,S2
 | OMRON | B3S-1000P
. 1 | 289-0056-000 | B ECN-13000 | TRANSISTOR,NPN,SWITCHING,50V,100MA,6-PIN,US6 | 1 | T1
 | INFINEON | BCR135S
 | PANASONIC | DMC56404
 | PANASONIC | XP04214
 | TOSHIBA | RN1907
. 1 | 289-0091-000 | B ECN-12738 | MOSFET,N-CHANNEL,20V,2.5A,SOT23 | 2 | Q1,Q2
 | NXP | PMV56XN,215
. 1 | NOT_USED | A PNR-10113 | NOT INSTALLED COMPONENT | 77 | C151,C160,C3,C5,C6,C192,C59,R76,R77,R102,R104,R132,R133,R147,R148,R36,R37,R178,R180,R90,R99,R136,R137,R138,R139,J17,J3,J6,J5,J2,J1,J4,R35,J7,C1,C2,C4,C191,C76,C80,C96,C99,J10,J11,J13,J15,J19,U4,R12,R28,R29,R30,R32,R33,R96,R100,R111,R112,R145,R150,R2,R3,R15,R16,R27,R69,R71,R144,R160,R164,R176,R167,R171,R172,R48,R60,R179
