RobertCNelson/pandaboard-docs/PandaboardA1/panda-a-schematic.pdf

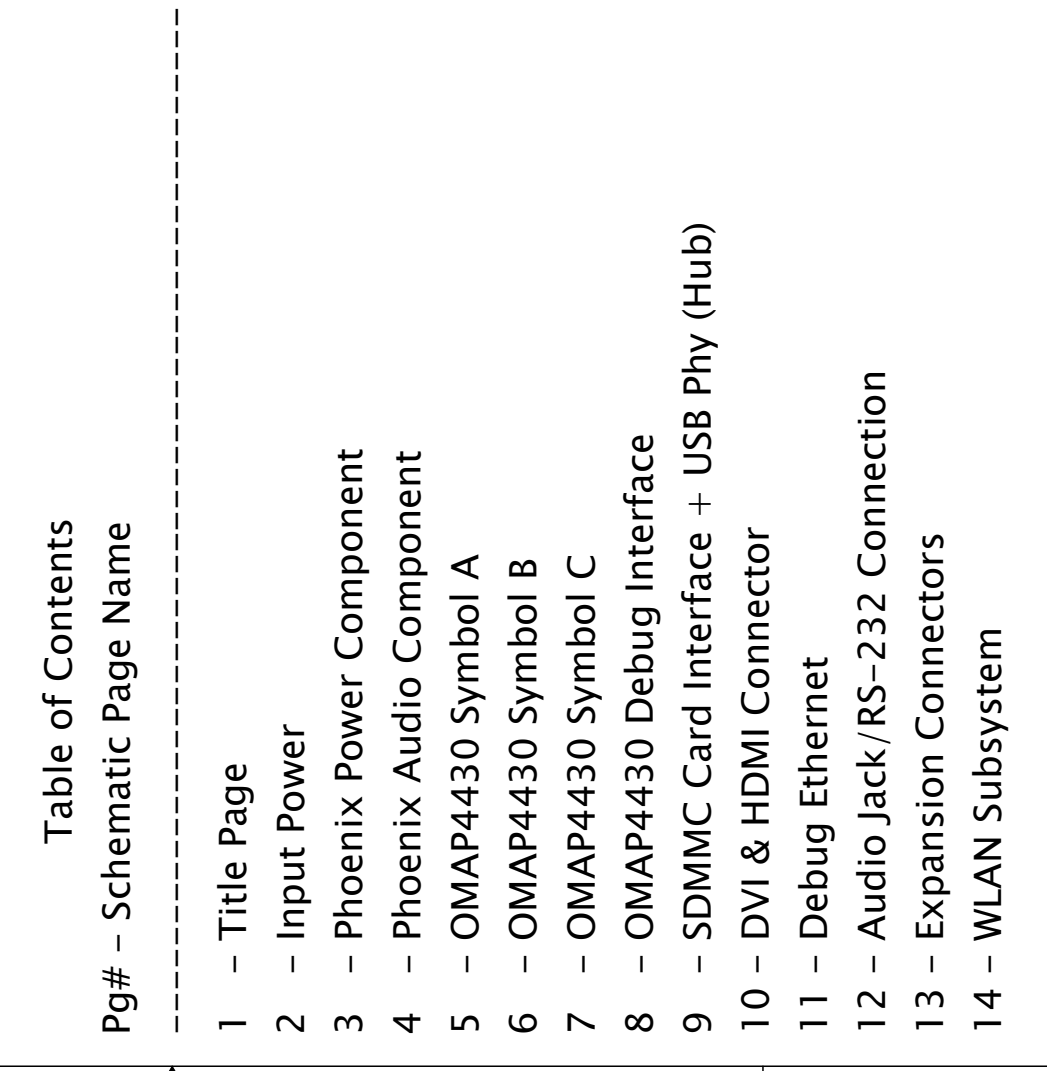
[picture p37: page 1]
1 - Title Page; 2 - Input Power; 5 - OMAP4430 Symbol A; 6 - OMAP4430 Symbol B; 7 - OMAP4430 Symbol C; 8 - OMAP4430 Debug Interface; 11 - Debug Ethernet; 13 - Expansion Connectors; 14 - WLAN Subsystem; Rev; Sheet of; Document Number; Date:; 750-2152-002-SCH; Title Page; Monday, November 29, 2010 1 14

OMAP4430 Panda Board, 8-Layer

B ECN-13172 - Changed U13, DNI R148, install board ID resistor R109, DNI Mic bias resistors, and change T/N for R165 10/11/2010

Created from 750-2152-001, changed input power sensing and enable circuitry, power changes to OMAP A

Rev Date Notes

C 10/28/2010 ECN-13183 - Changed resistor stuffing on JTAG connector

D 11/8/2010 ECN-13192 - Changed U14 IC to Schmitt-trigger device

9 - SDMMC Card Interface + USB Phy (Hub)

12 - Audio Jack/RS-232 Connection

3 - Phoenix Power Component

4 - Phoenix Audio Component

Table of Contents

Pg# - Schematic Page Name

10 - DVI & HDMI Connector

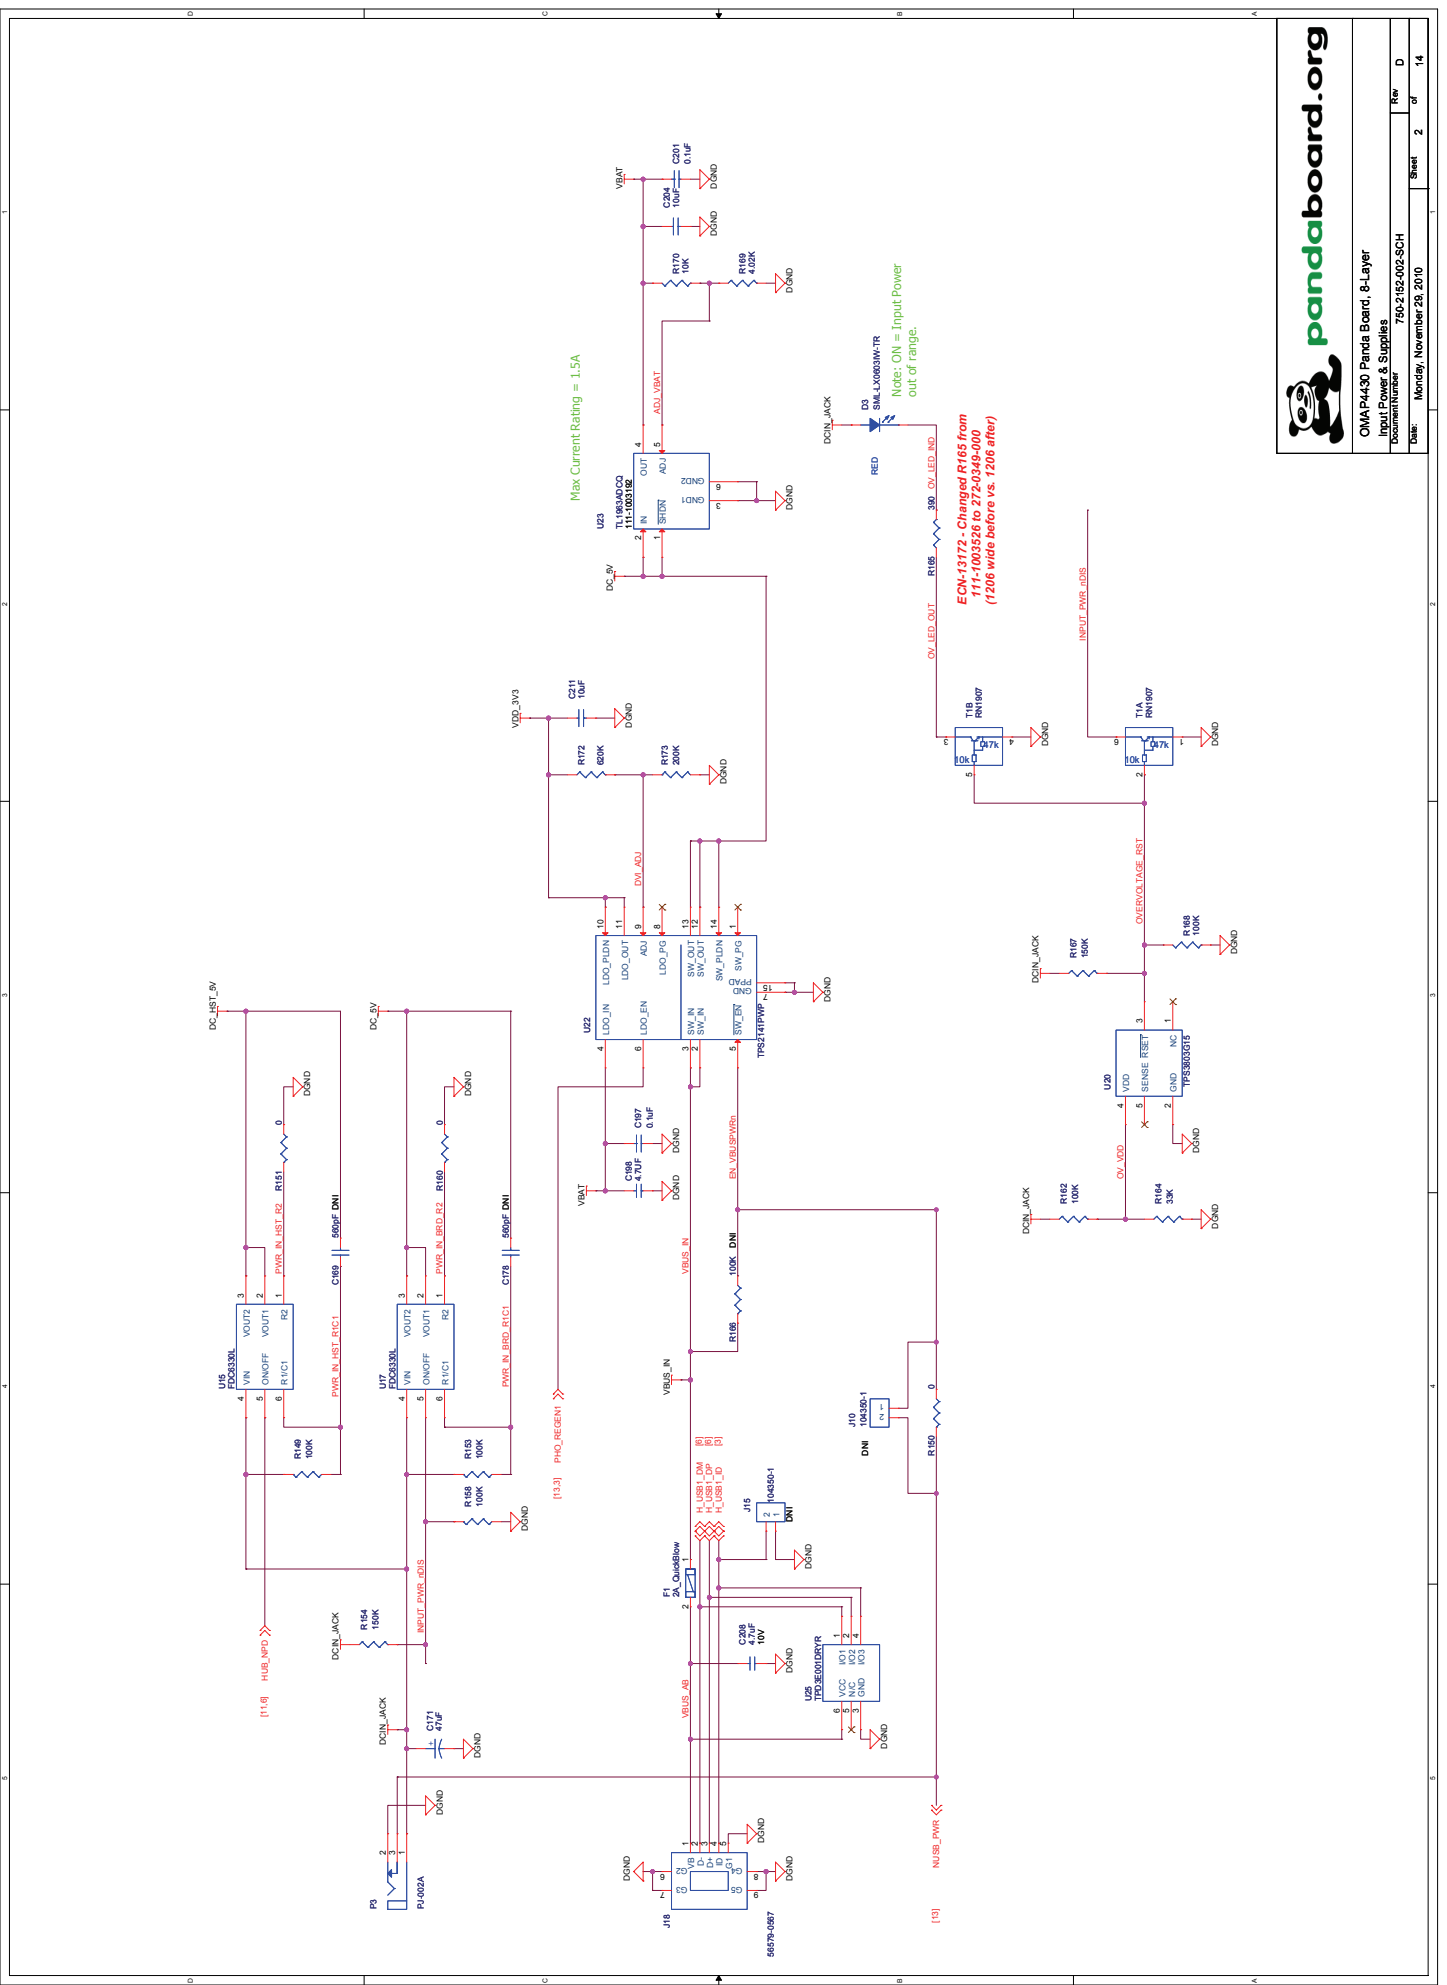
[picture p38: page 2]

Note: ON = Input Power

(1206 wide before vs. 1206 after)

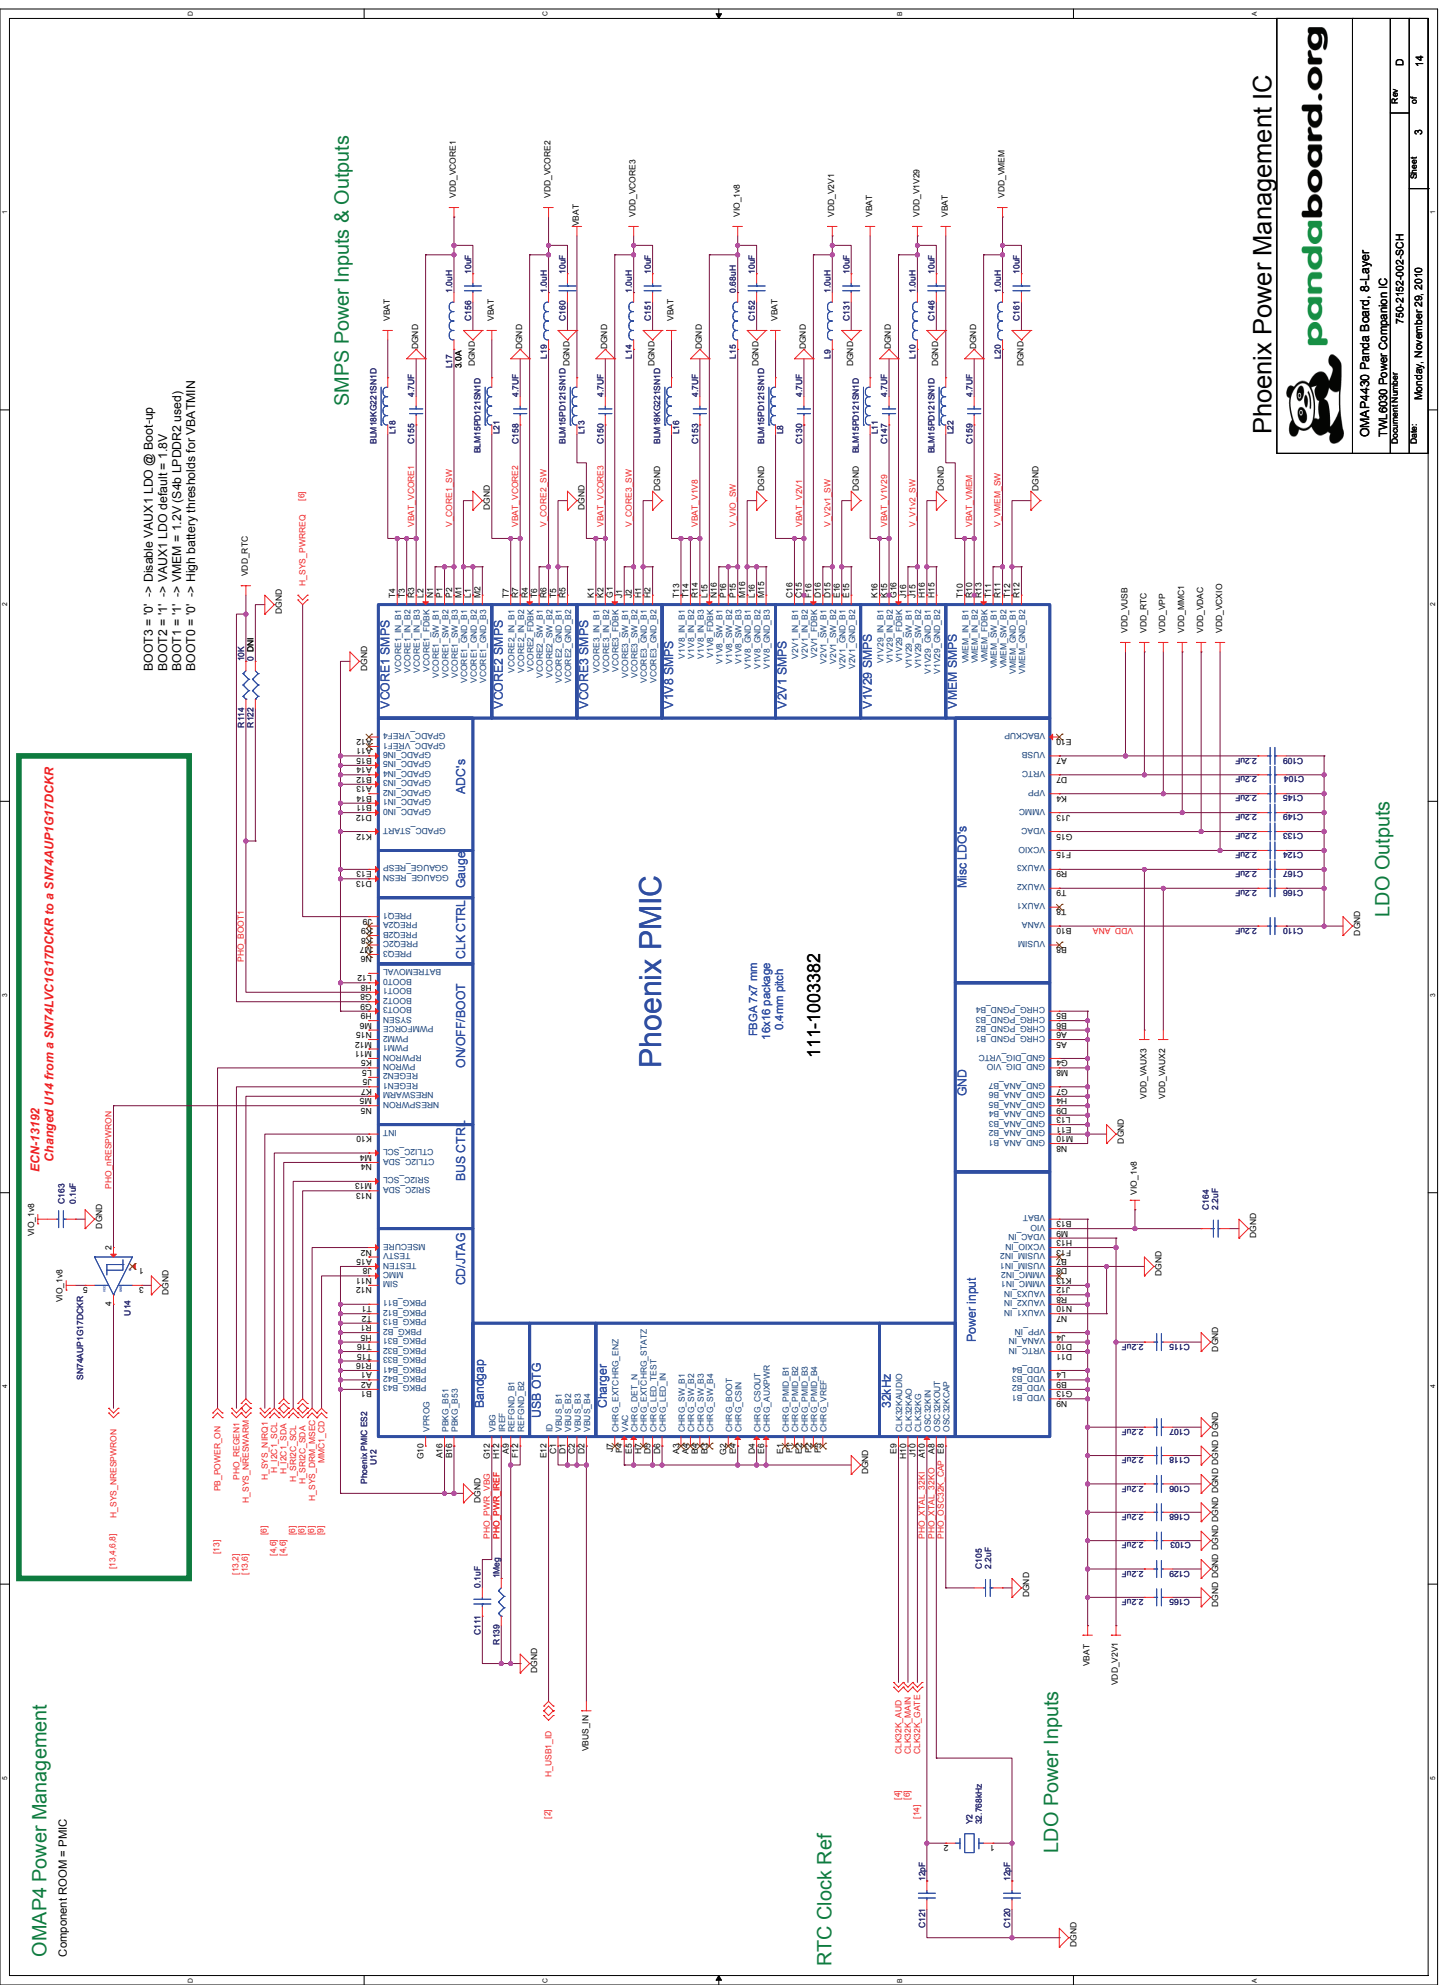
[picture p39: page 3]

A A Phoenix Power Management IC

SMPS Power Inputs & Outputs

BOOT0 = '0' -> High battery thresholds for VBATMIN

BOOT3 = '0' -> Disable VAUX1 LDO @ Boot-up

Gauge ADC's CLK CTRL

BUS CTRL ON/OFF/BOOT CD/JTAG

DGND DGND DGND DGND

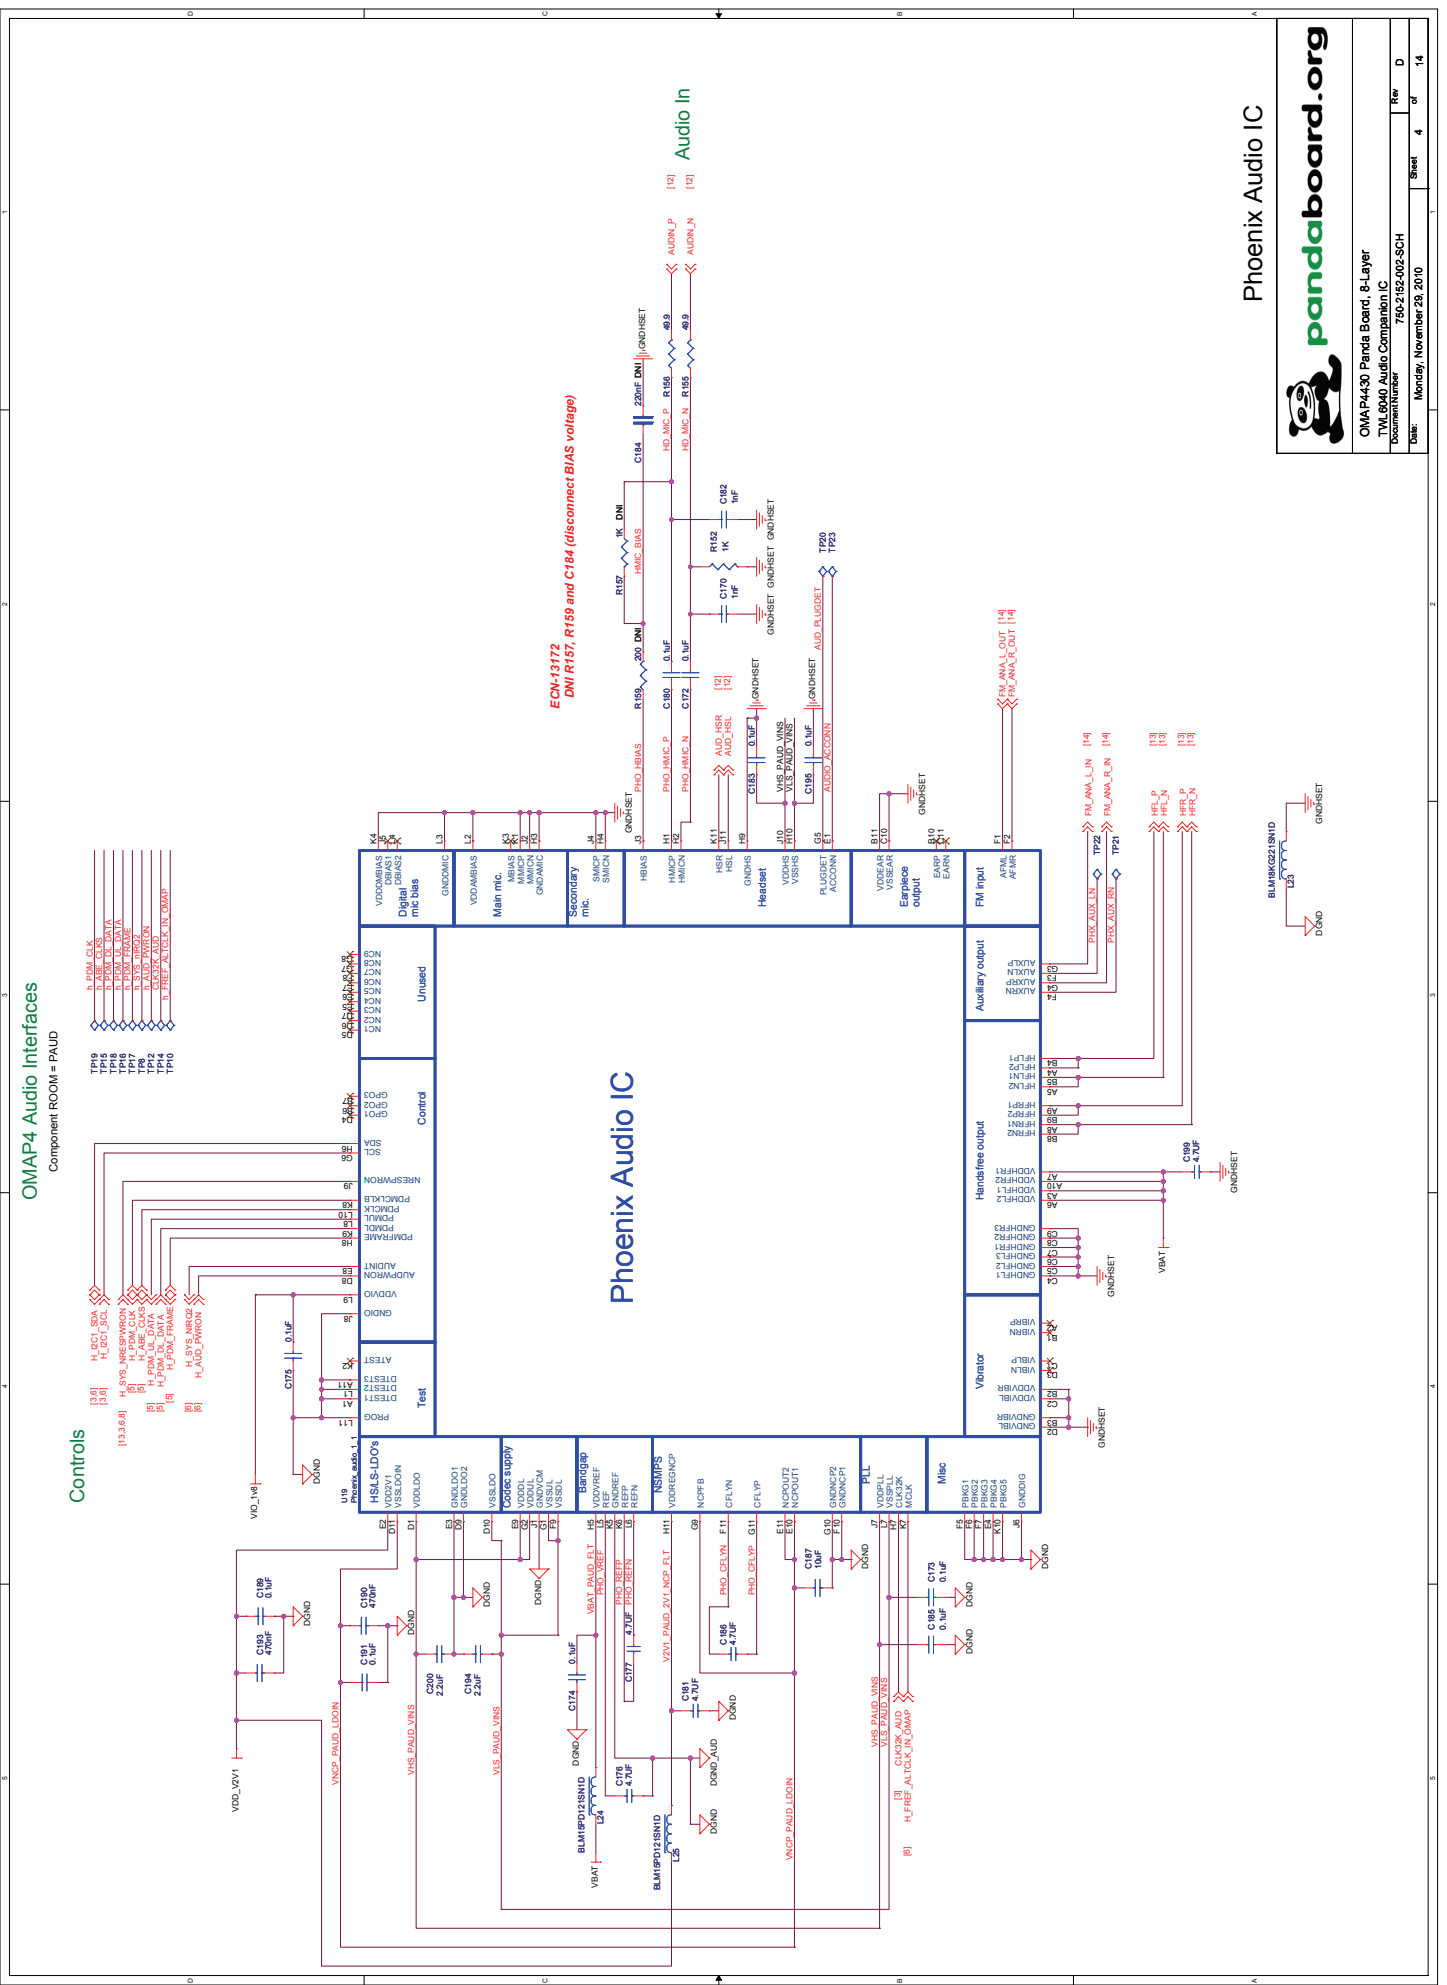
[picture p40: page 4]

DNI R157, R159 and C184 (disconnect BIAS voltage)

Handsfree output Auxiliary output FM input

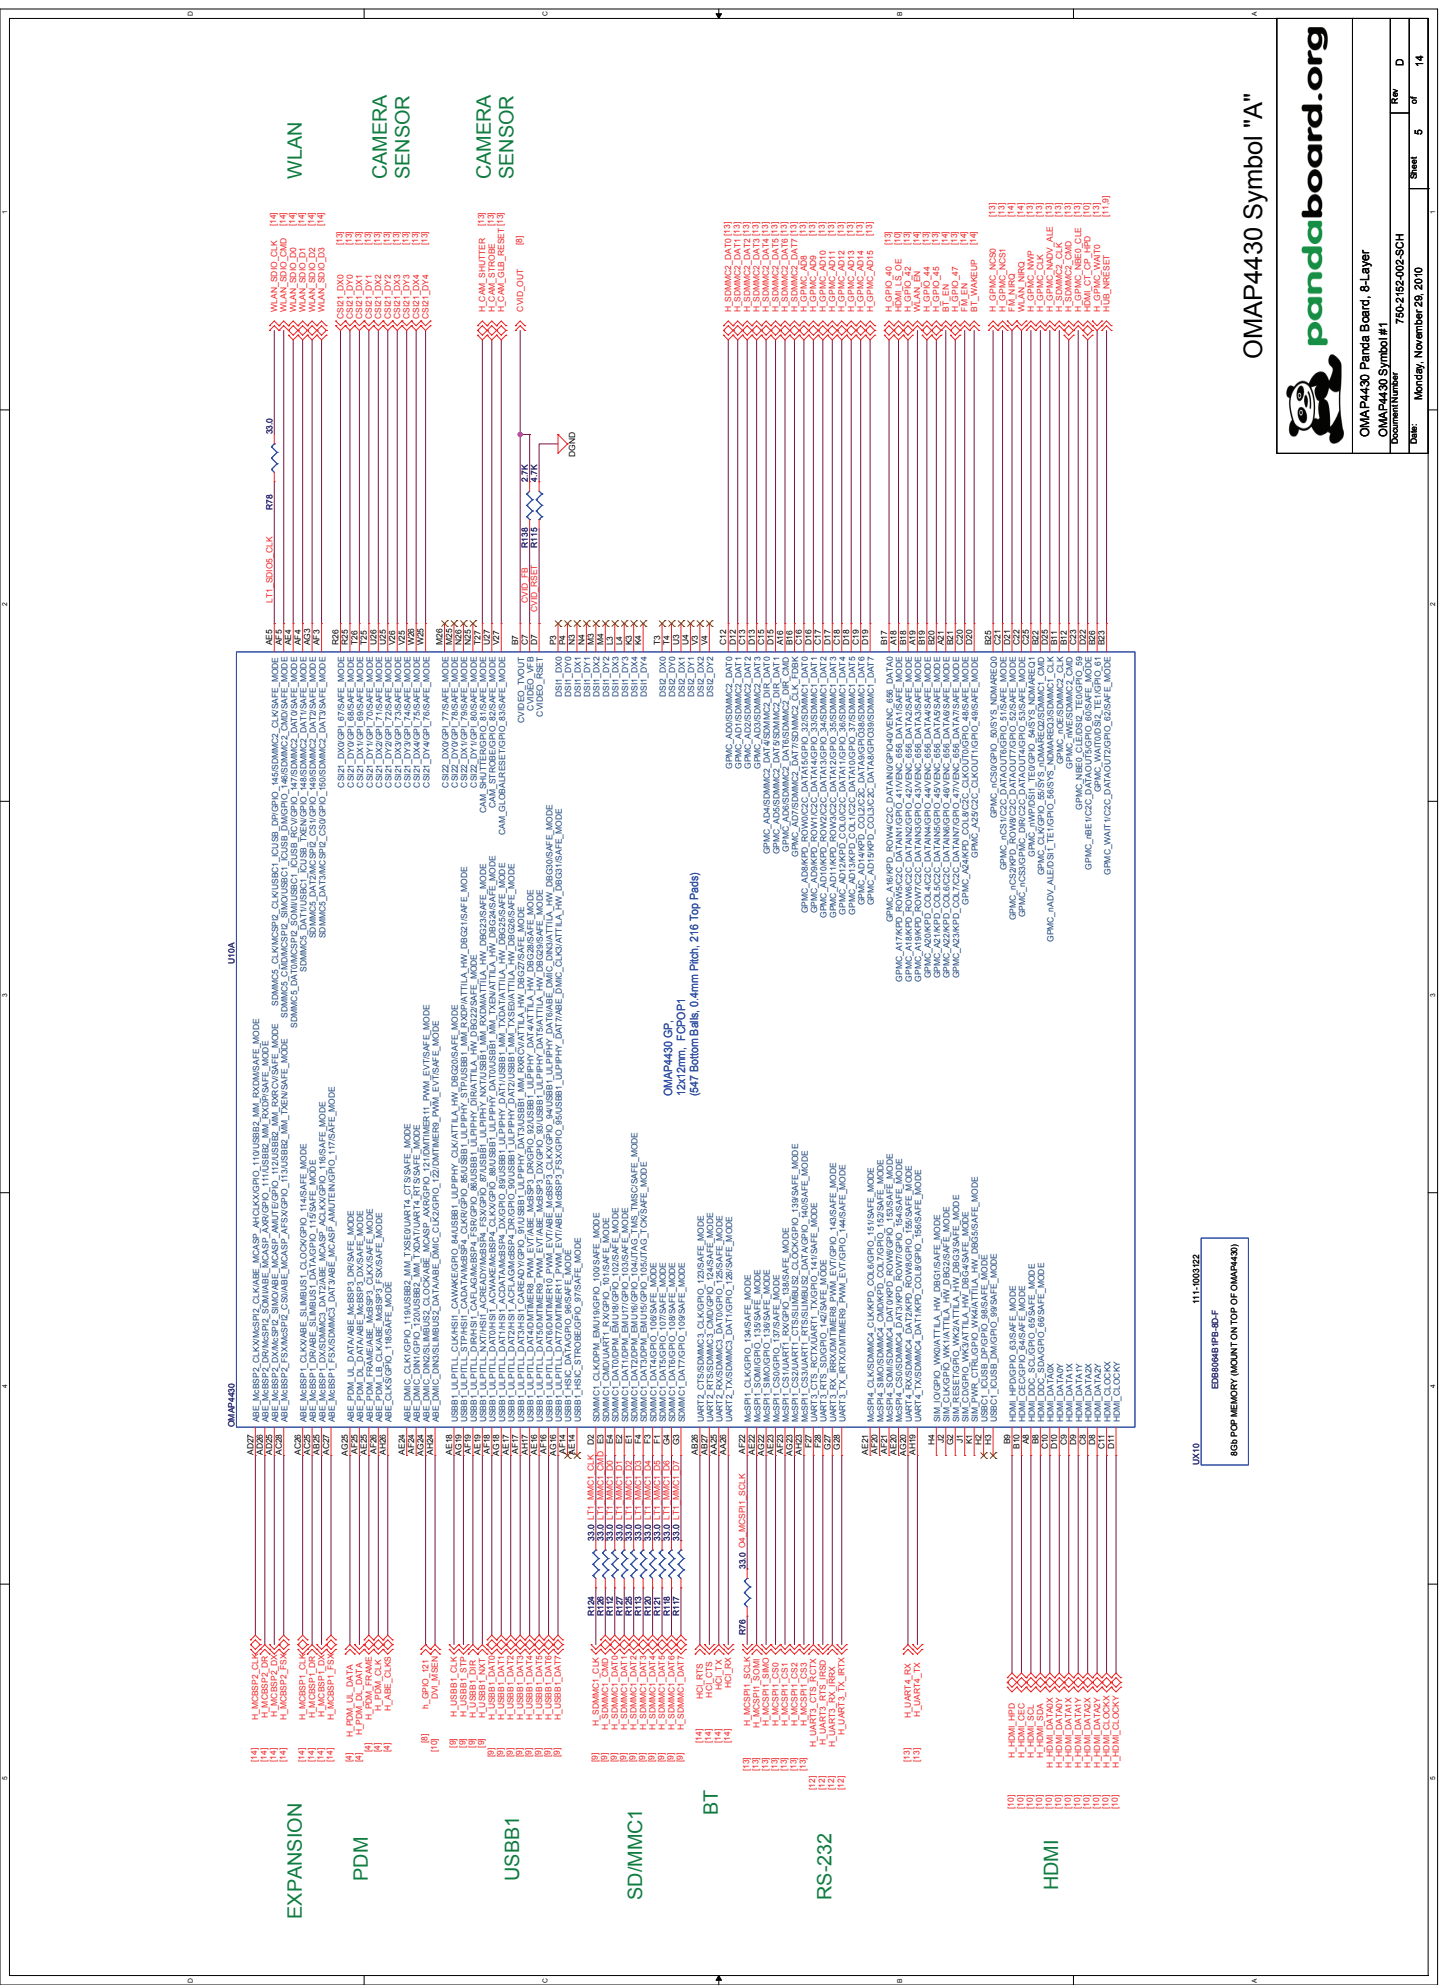
[picture p41: page 5]

(547 Bottom Balls, 0.4mm Pitch, 216 Top Pads)

8Gb POP MEMORY (MOUNT ON TOP OF OMAP4430)

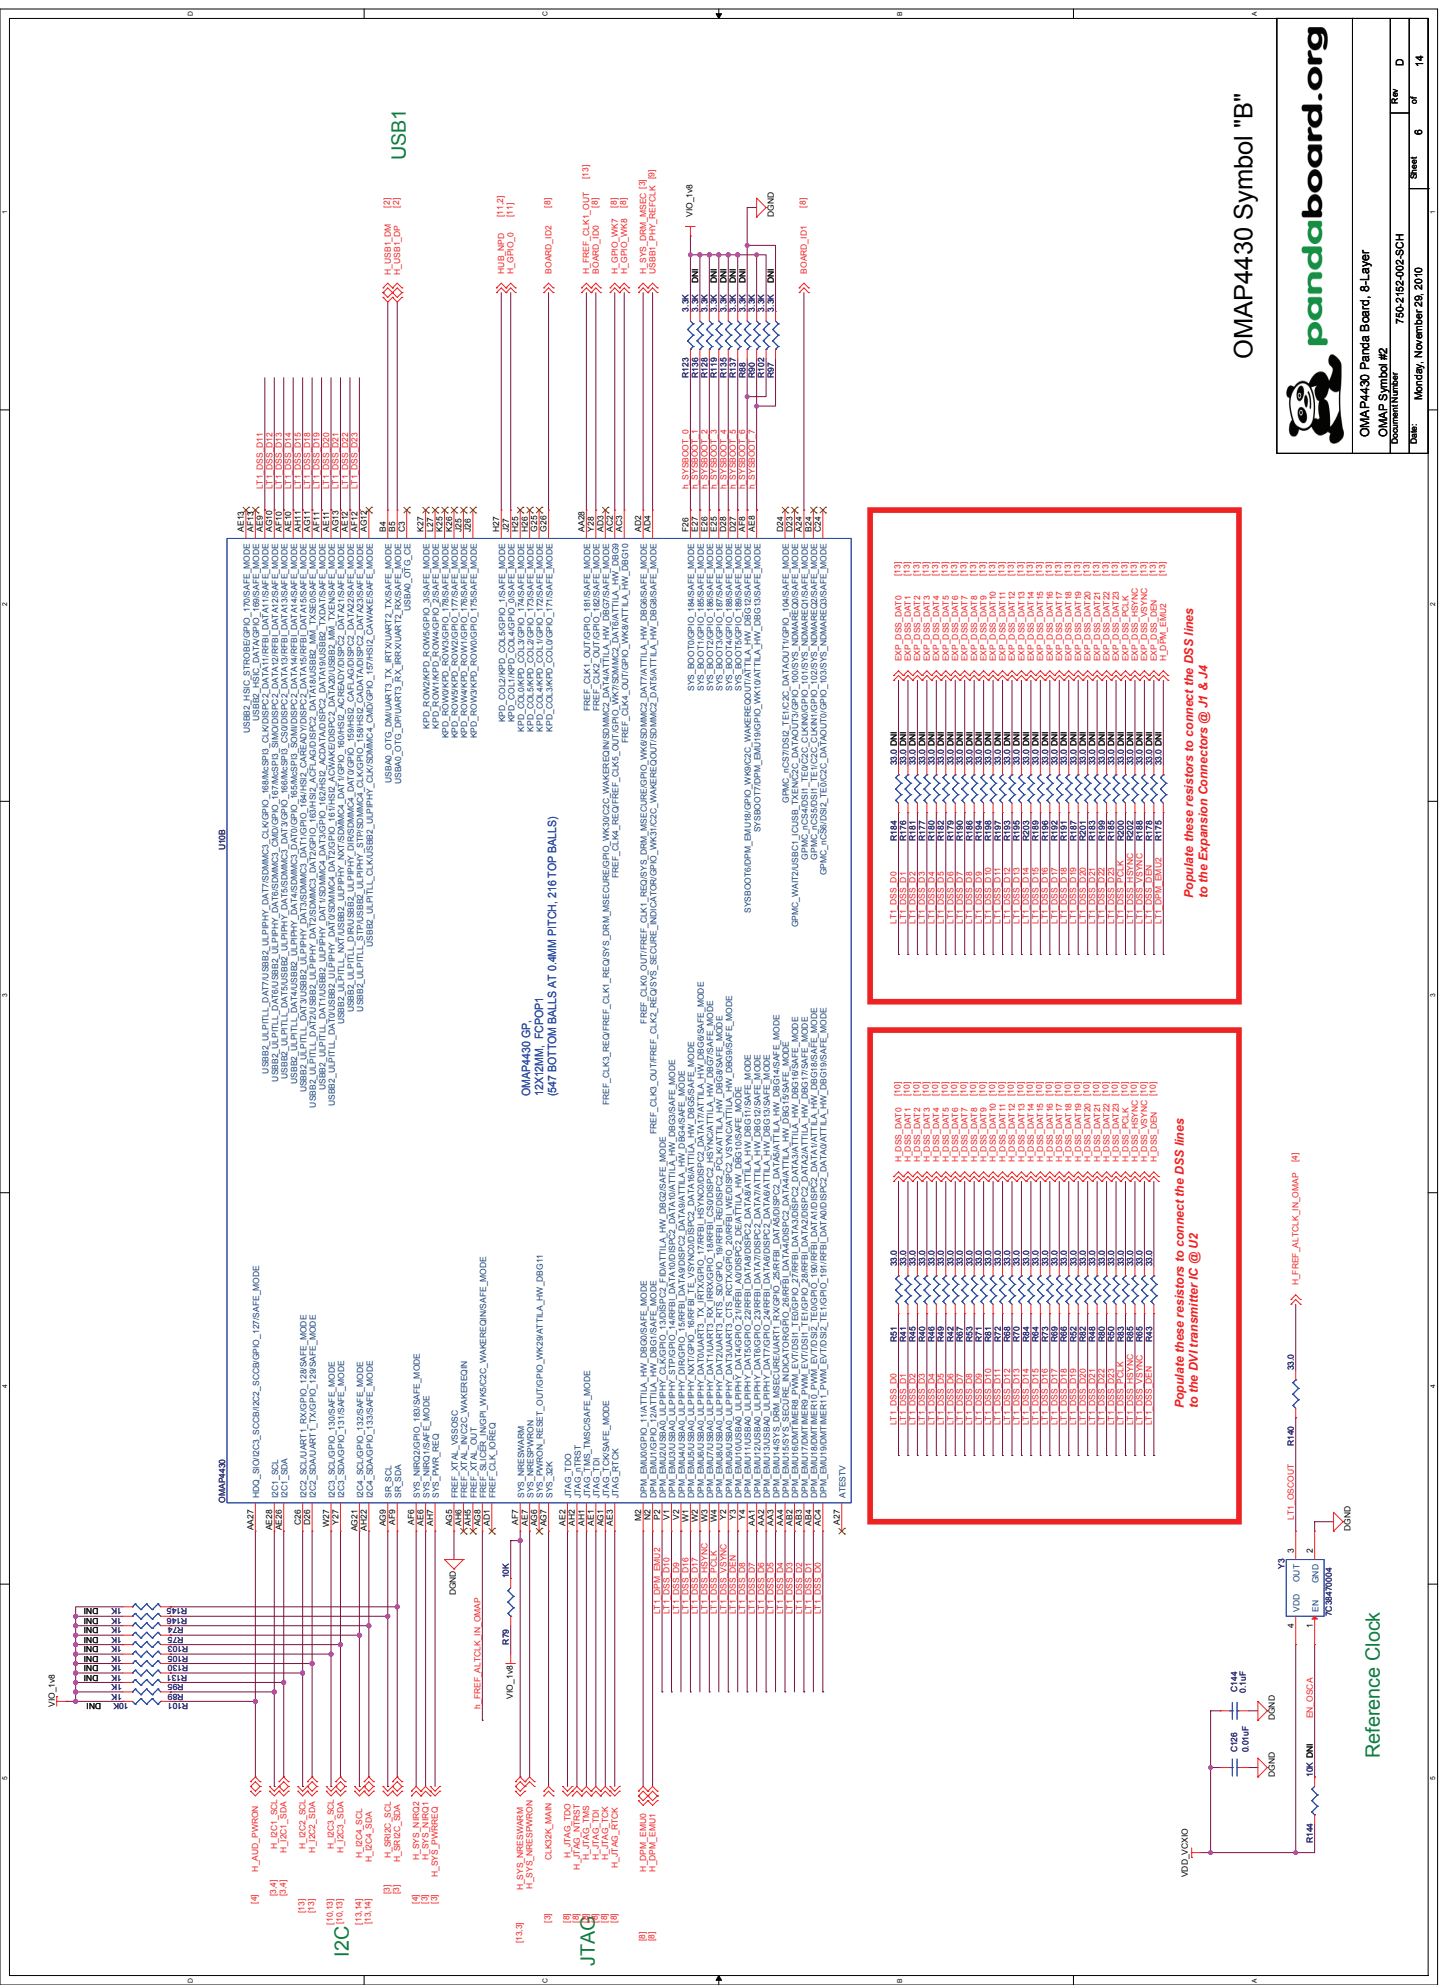
[picture p42: page 6]

to the DVI transmitter IC @ U2 Populate these resistors to connect the DSS lines to the Expansion Connectors @ J1 & J4

(547 BOTTOM BALLS AT 0.4MM PITCH, 216 TOP BALLS)

Populate these resistors to connect the DSS lines

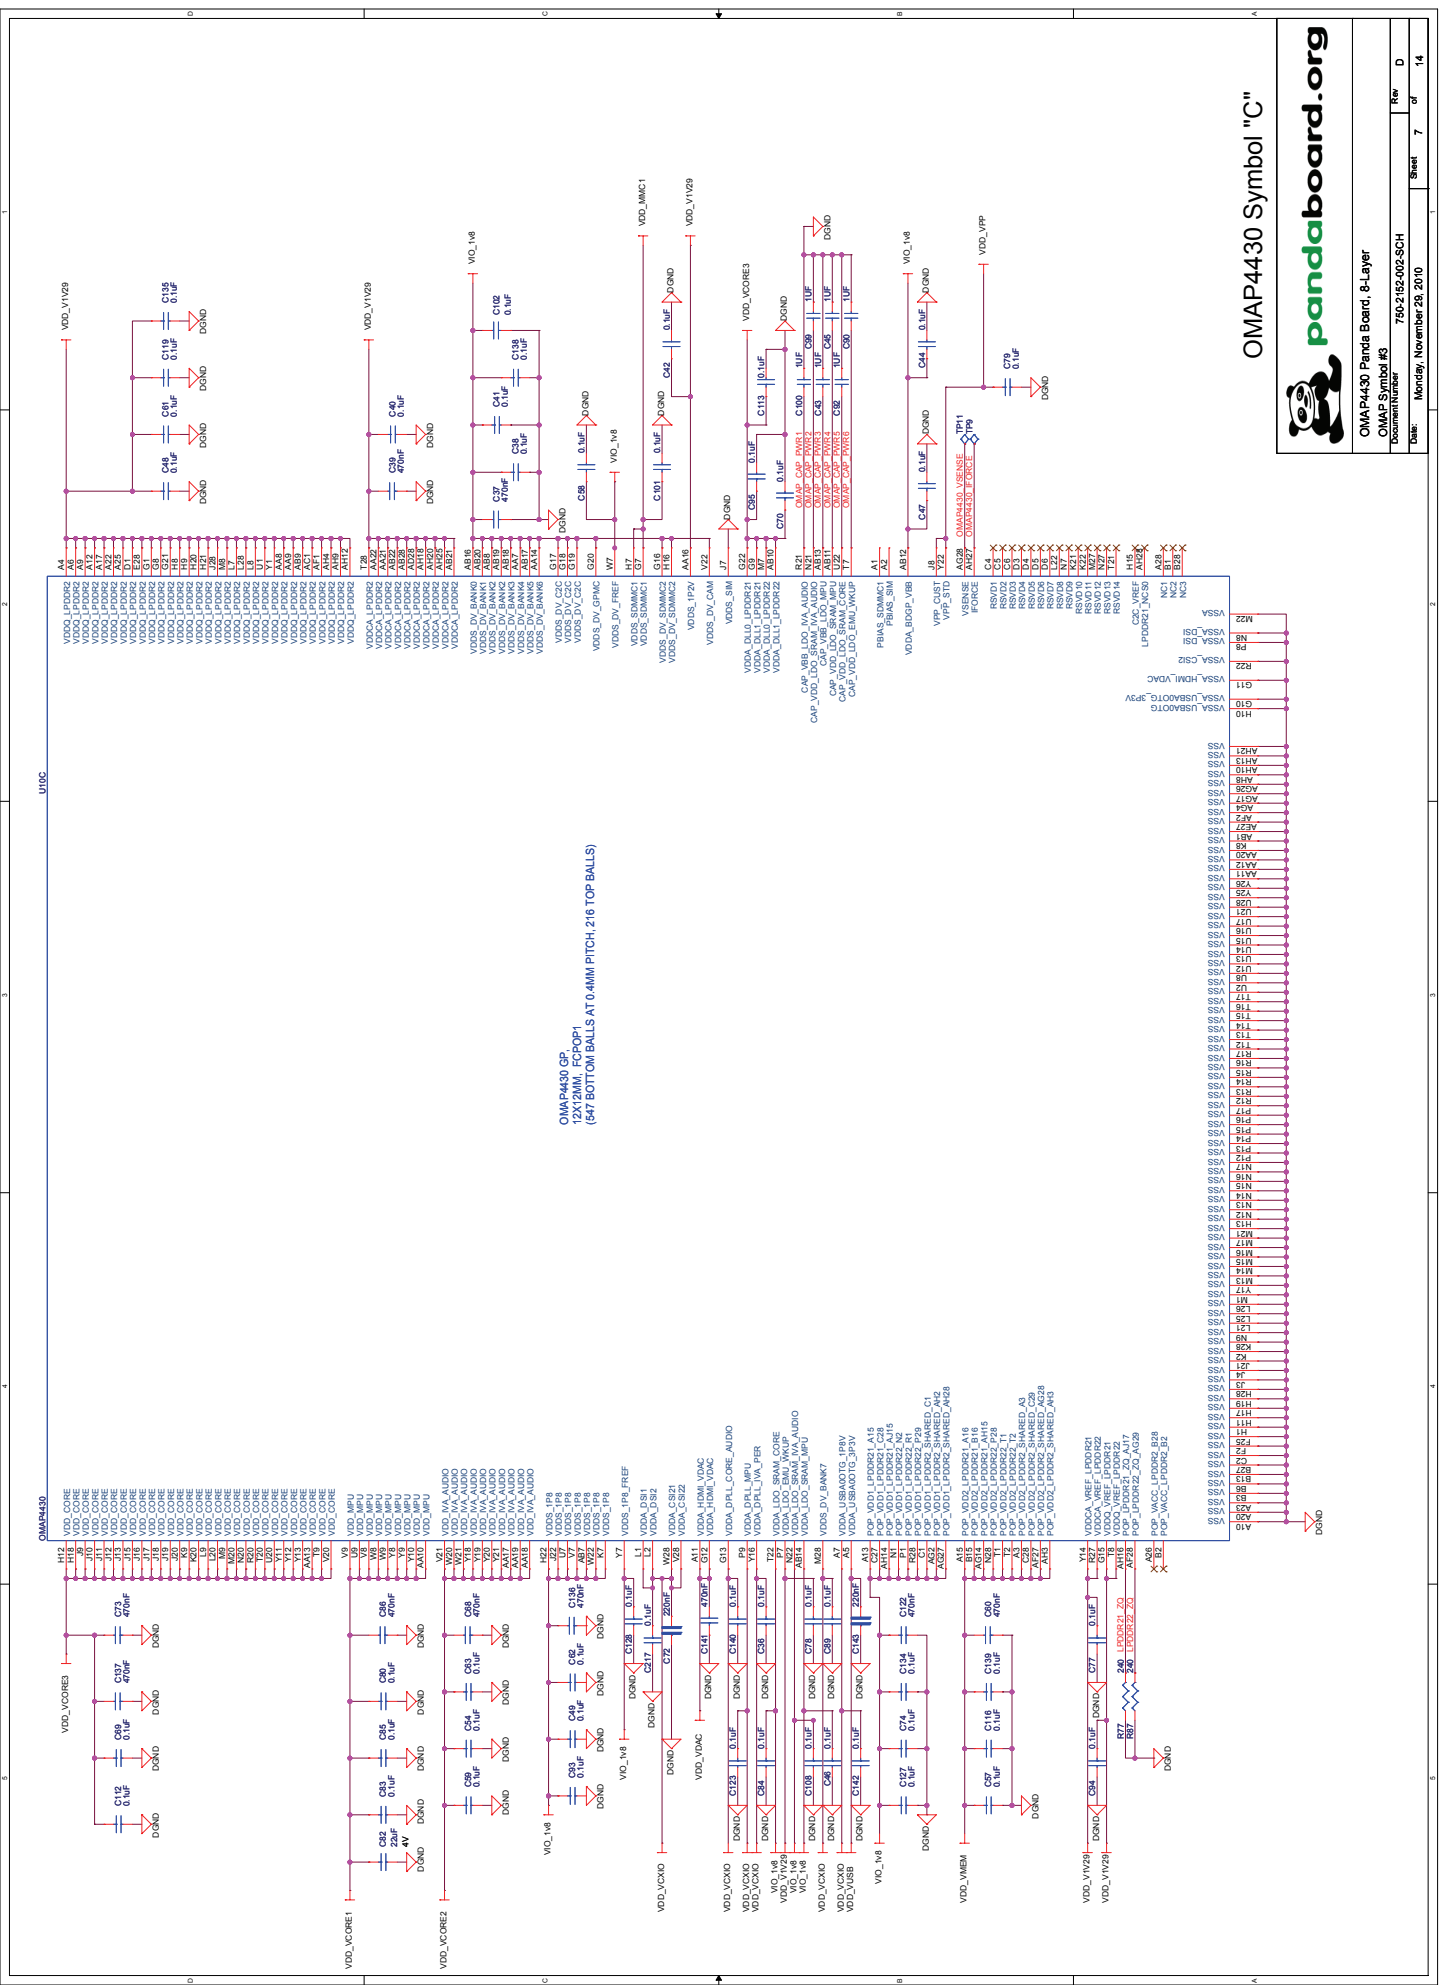
[picture p43: page 7]

DGND DGND

(547 BOTTOM BALLS AT 0.4MM PITCH, 216 TOP BALLS)

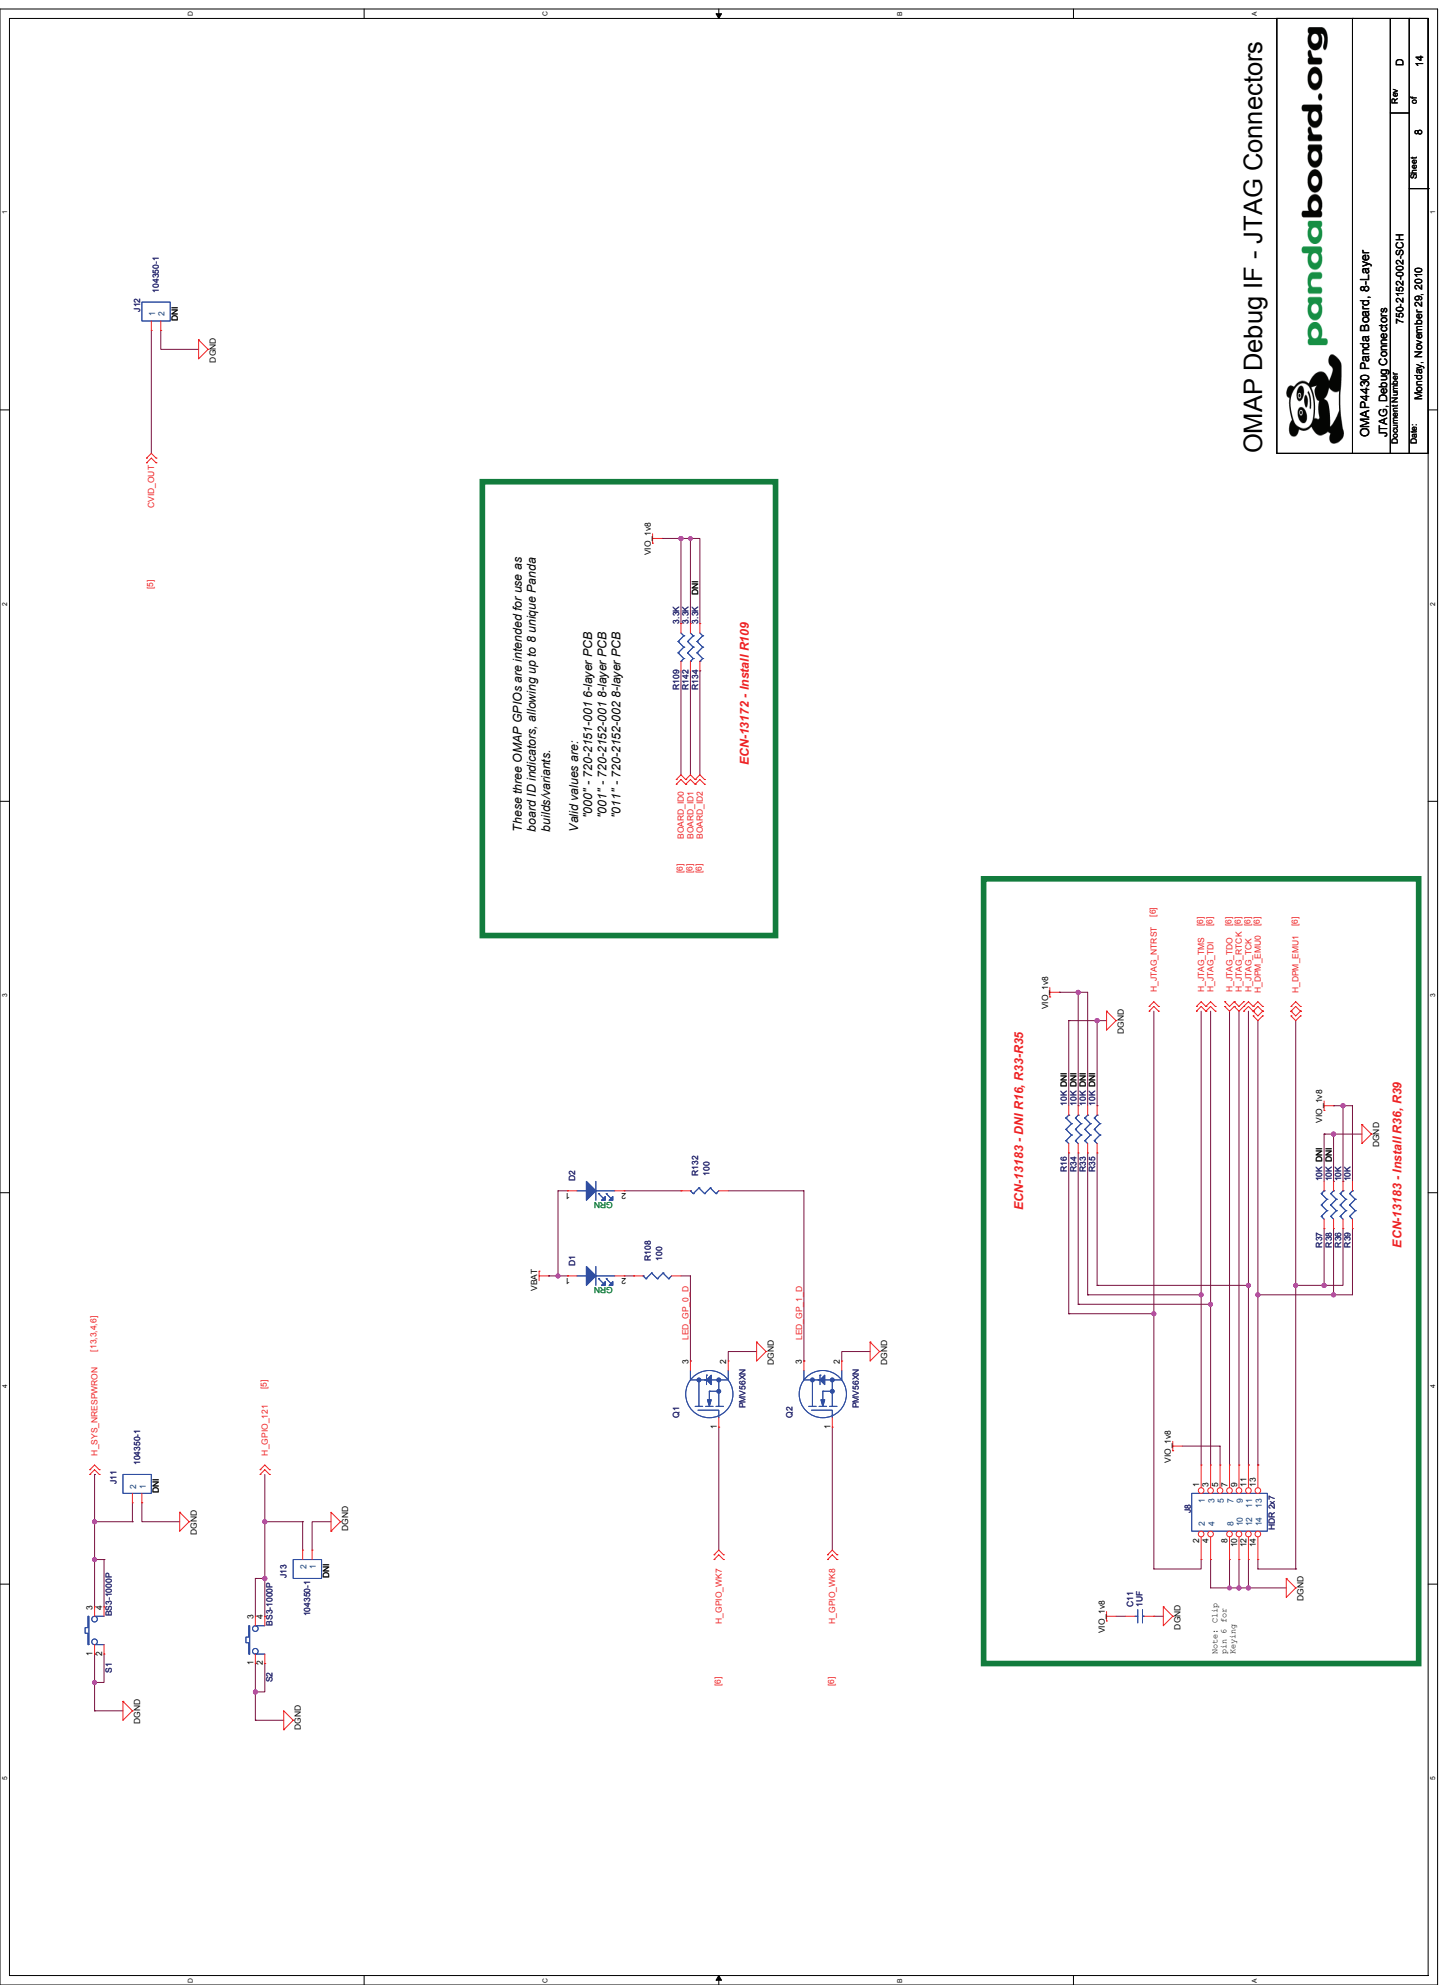
[picture p44: page 8]

A A OMAP Debug IF - JTAG Connectors

These three OMAP GPIOs are intended for use as

board ID indicators, allowing up to 8 unique Panda

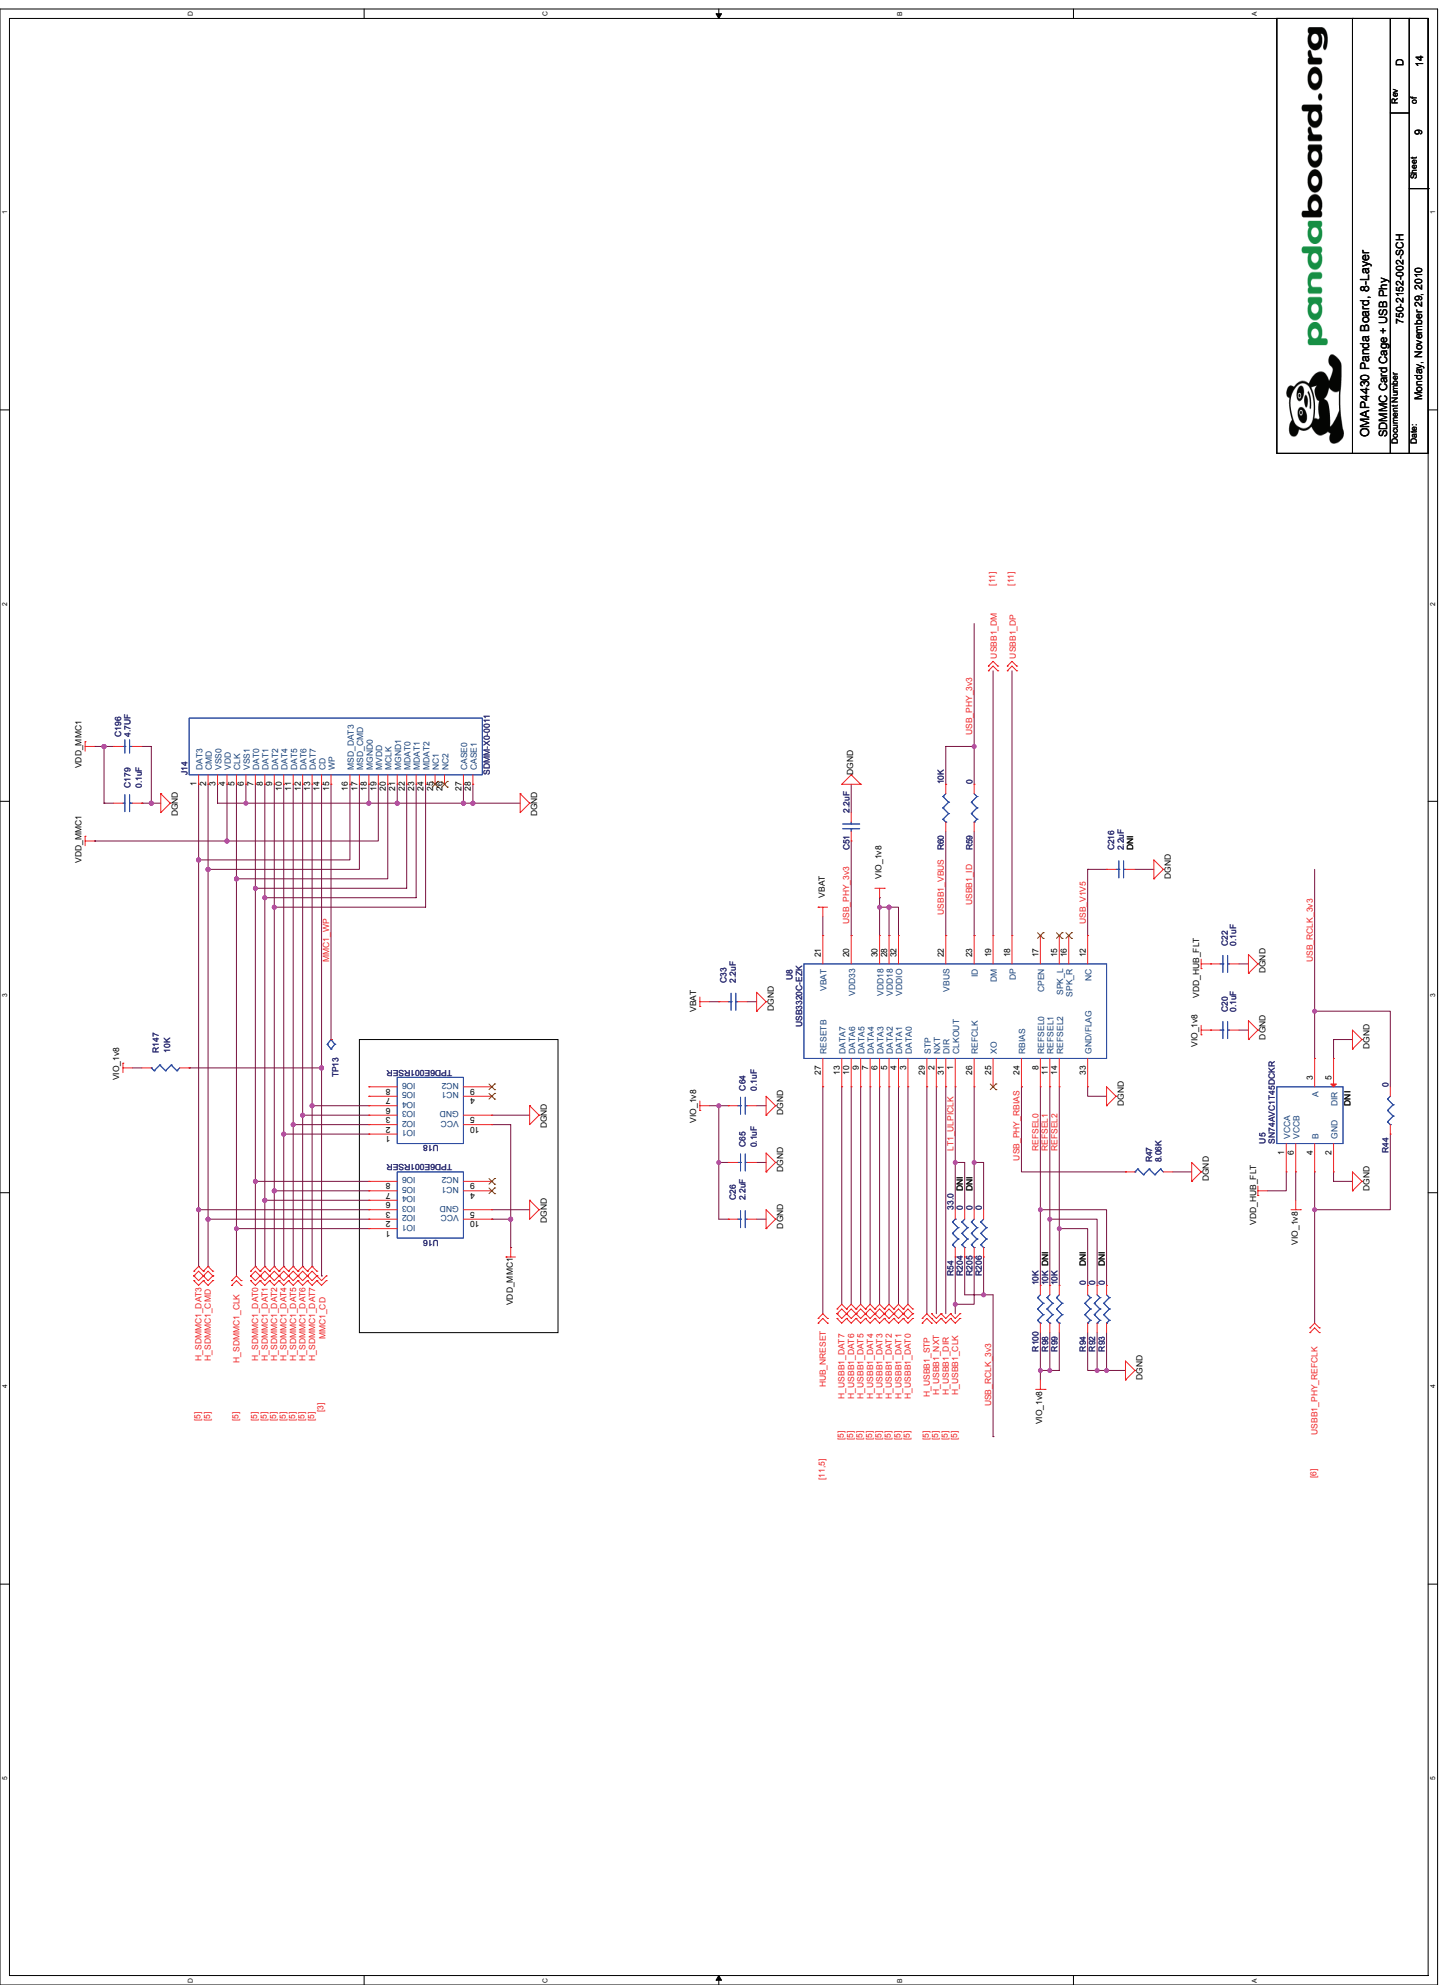
[picture p45: page 9]

SDMMC Card Cage + USB Phy

CLKOUT 1 DIR 31 NXT 2 STP 29

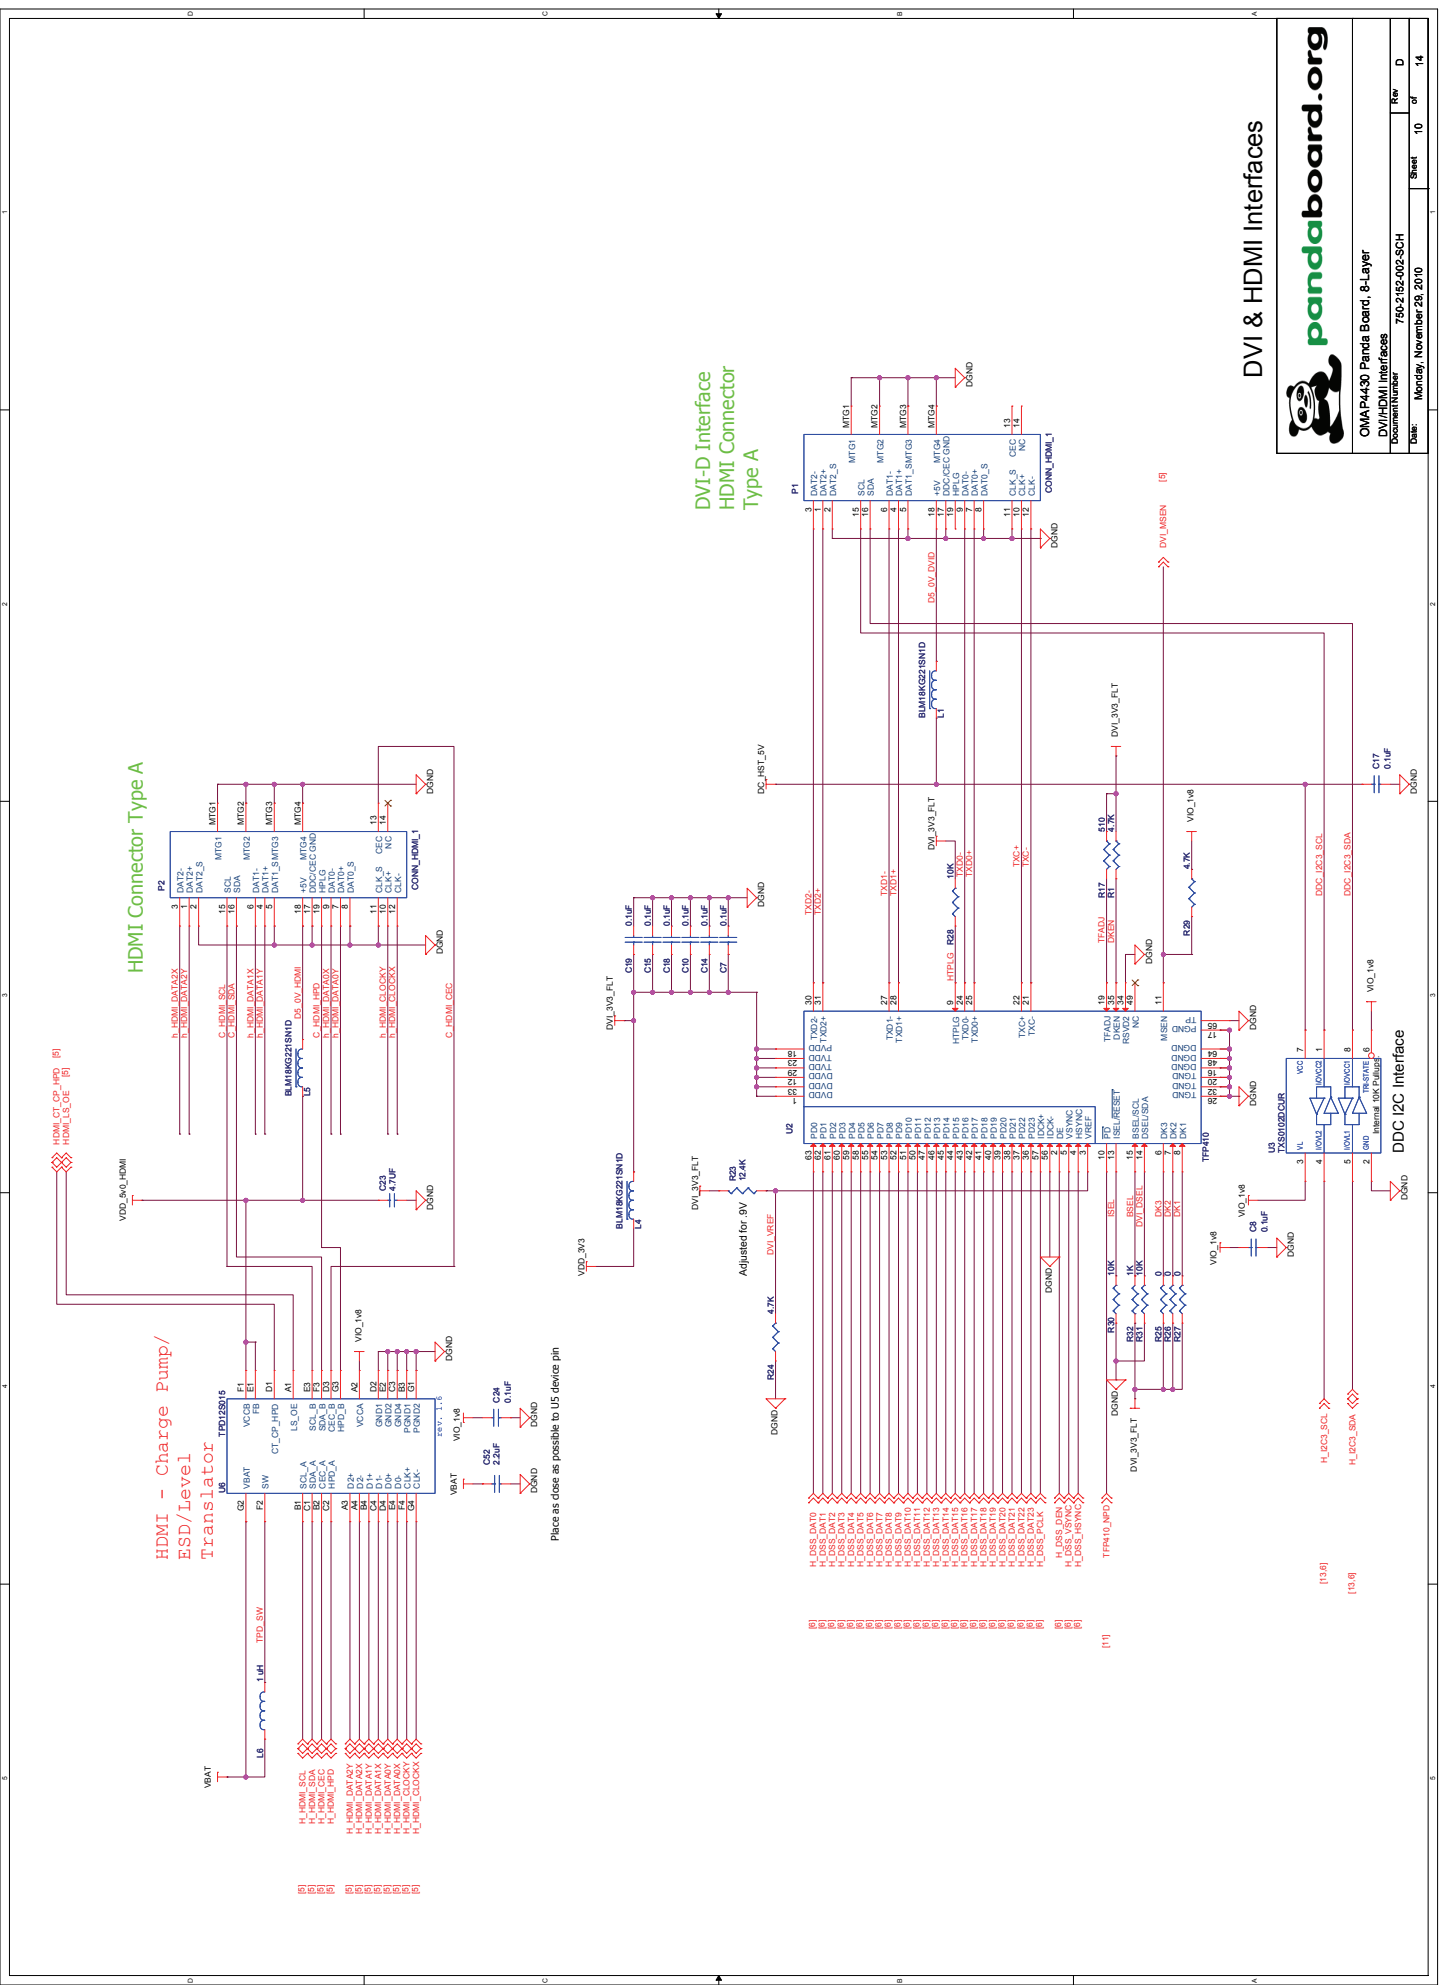
[picture p46: page 10]

DSEL/SDA 14 BSEL/SCL 15

Place as close as possible to U5 device pin

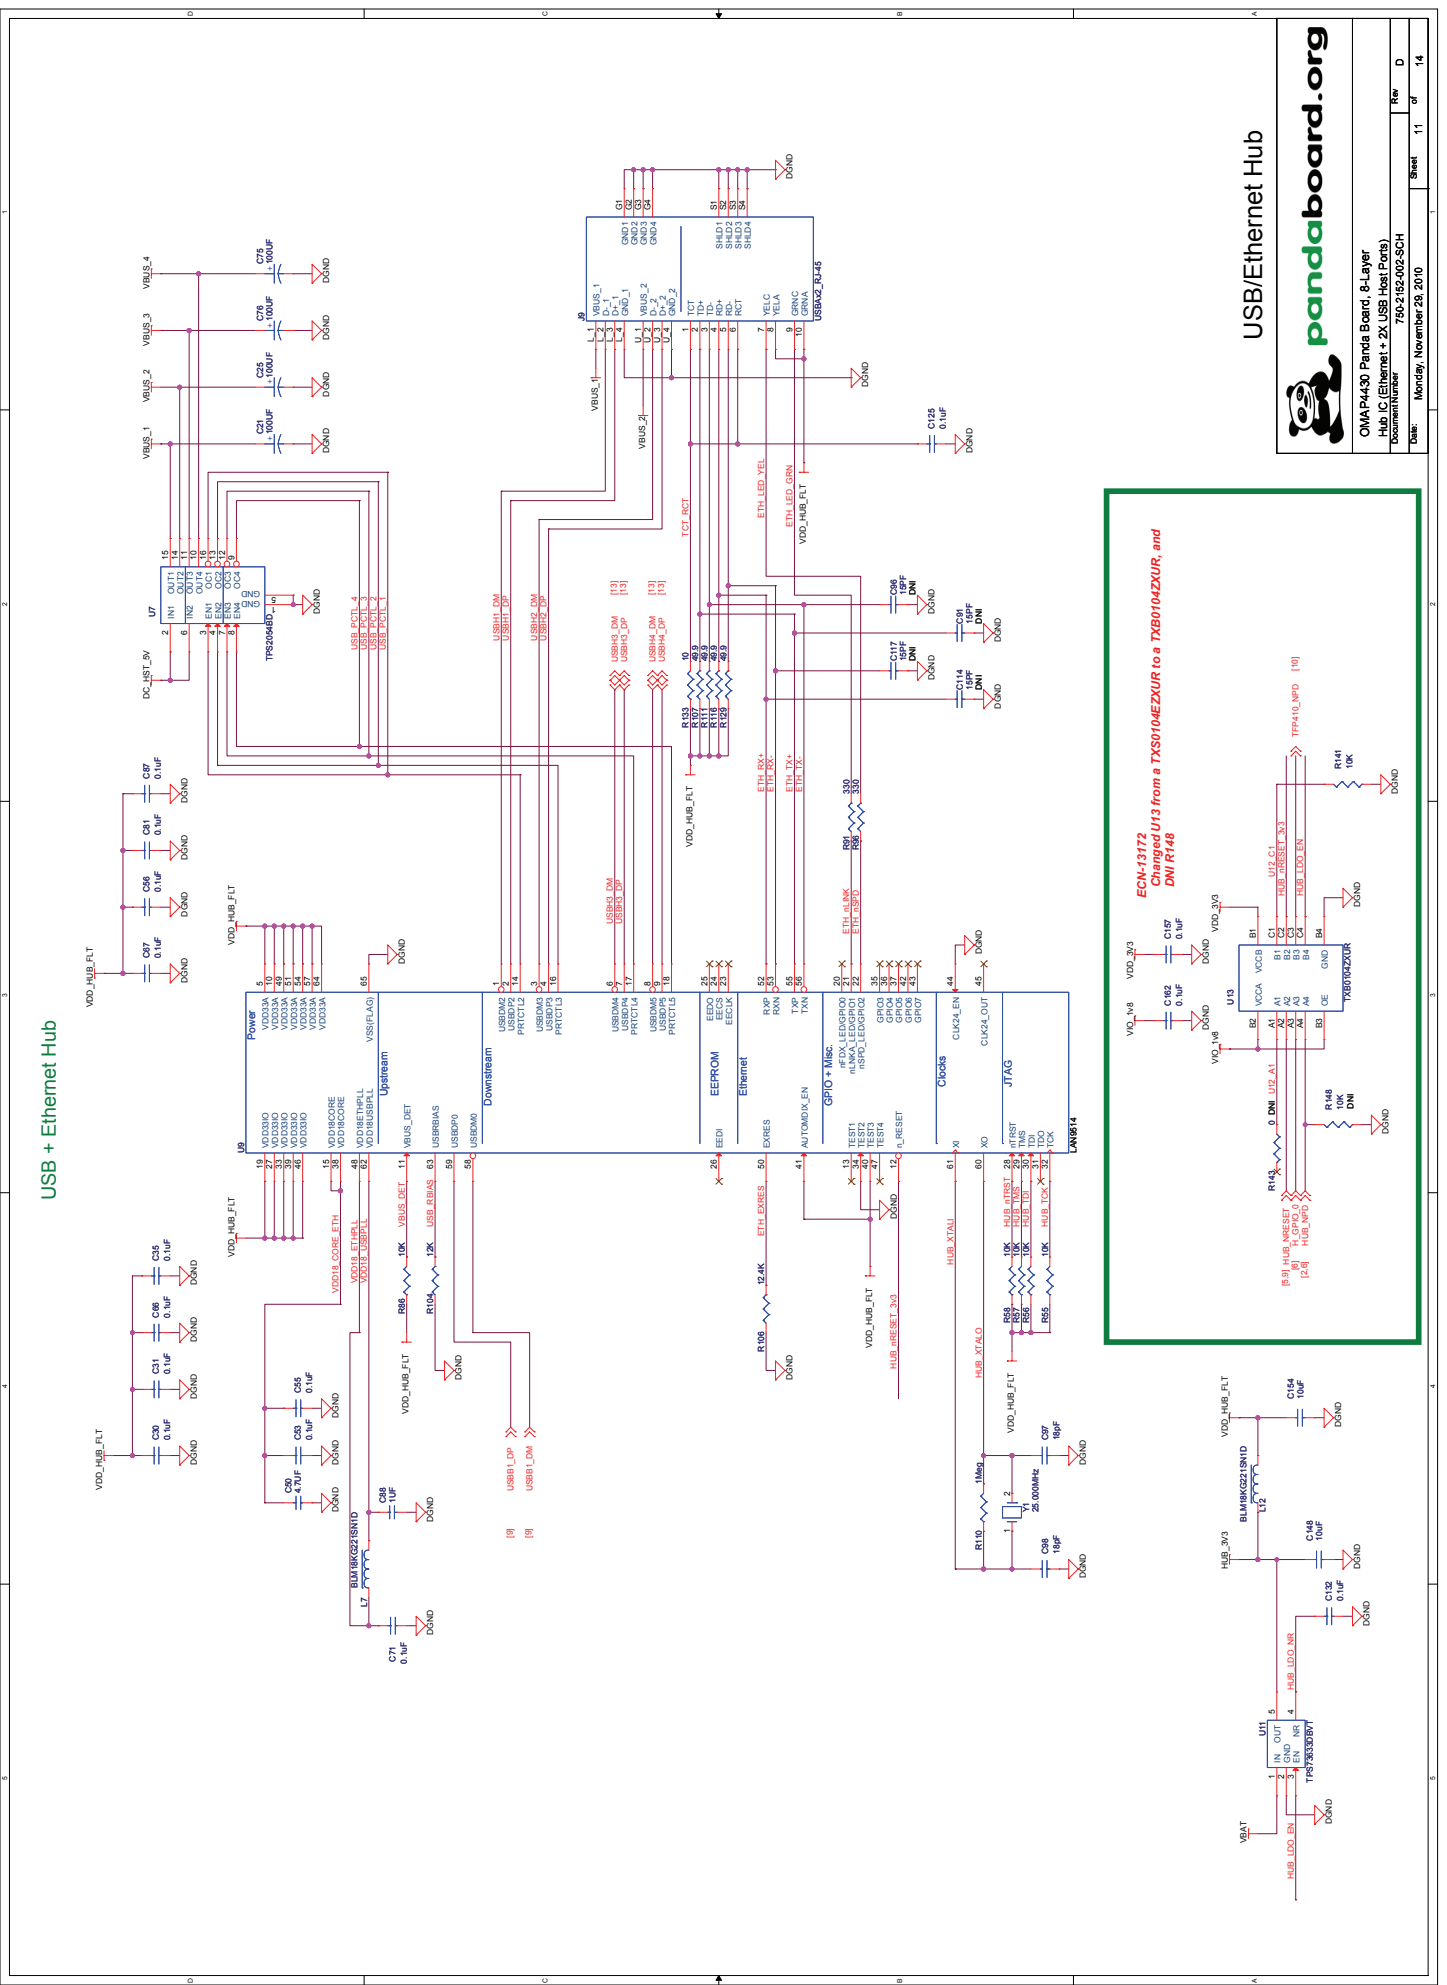
[picture p47: page 11]

Hub IC (Ethernet + 2X USB Host Ports)

DGND DGND

Changed U13 from a TXS0104EZXUR to a TXB0104ZXUR, and

EECLK 23 EECS 24 EEDO 25 EEDI 26

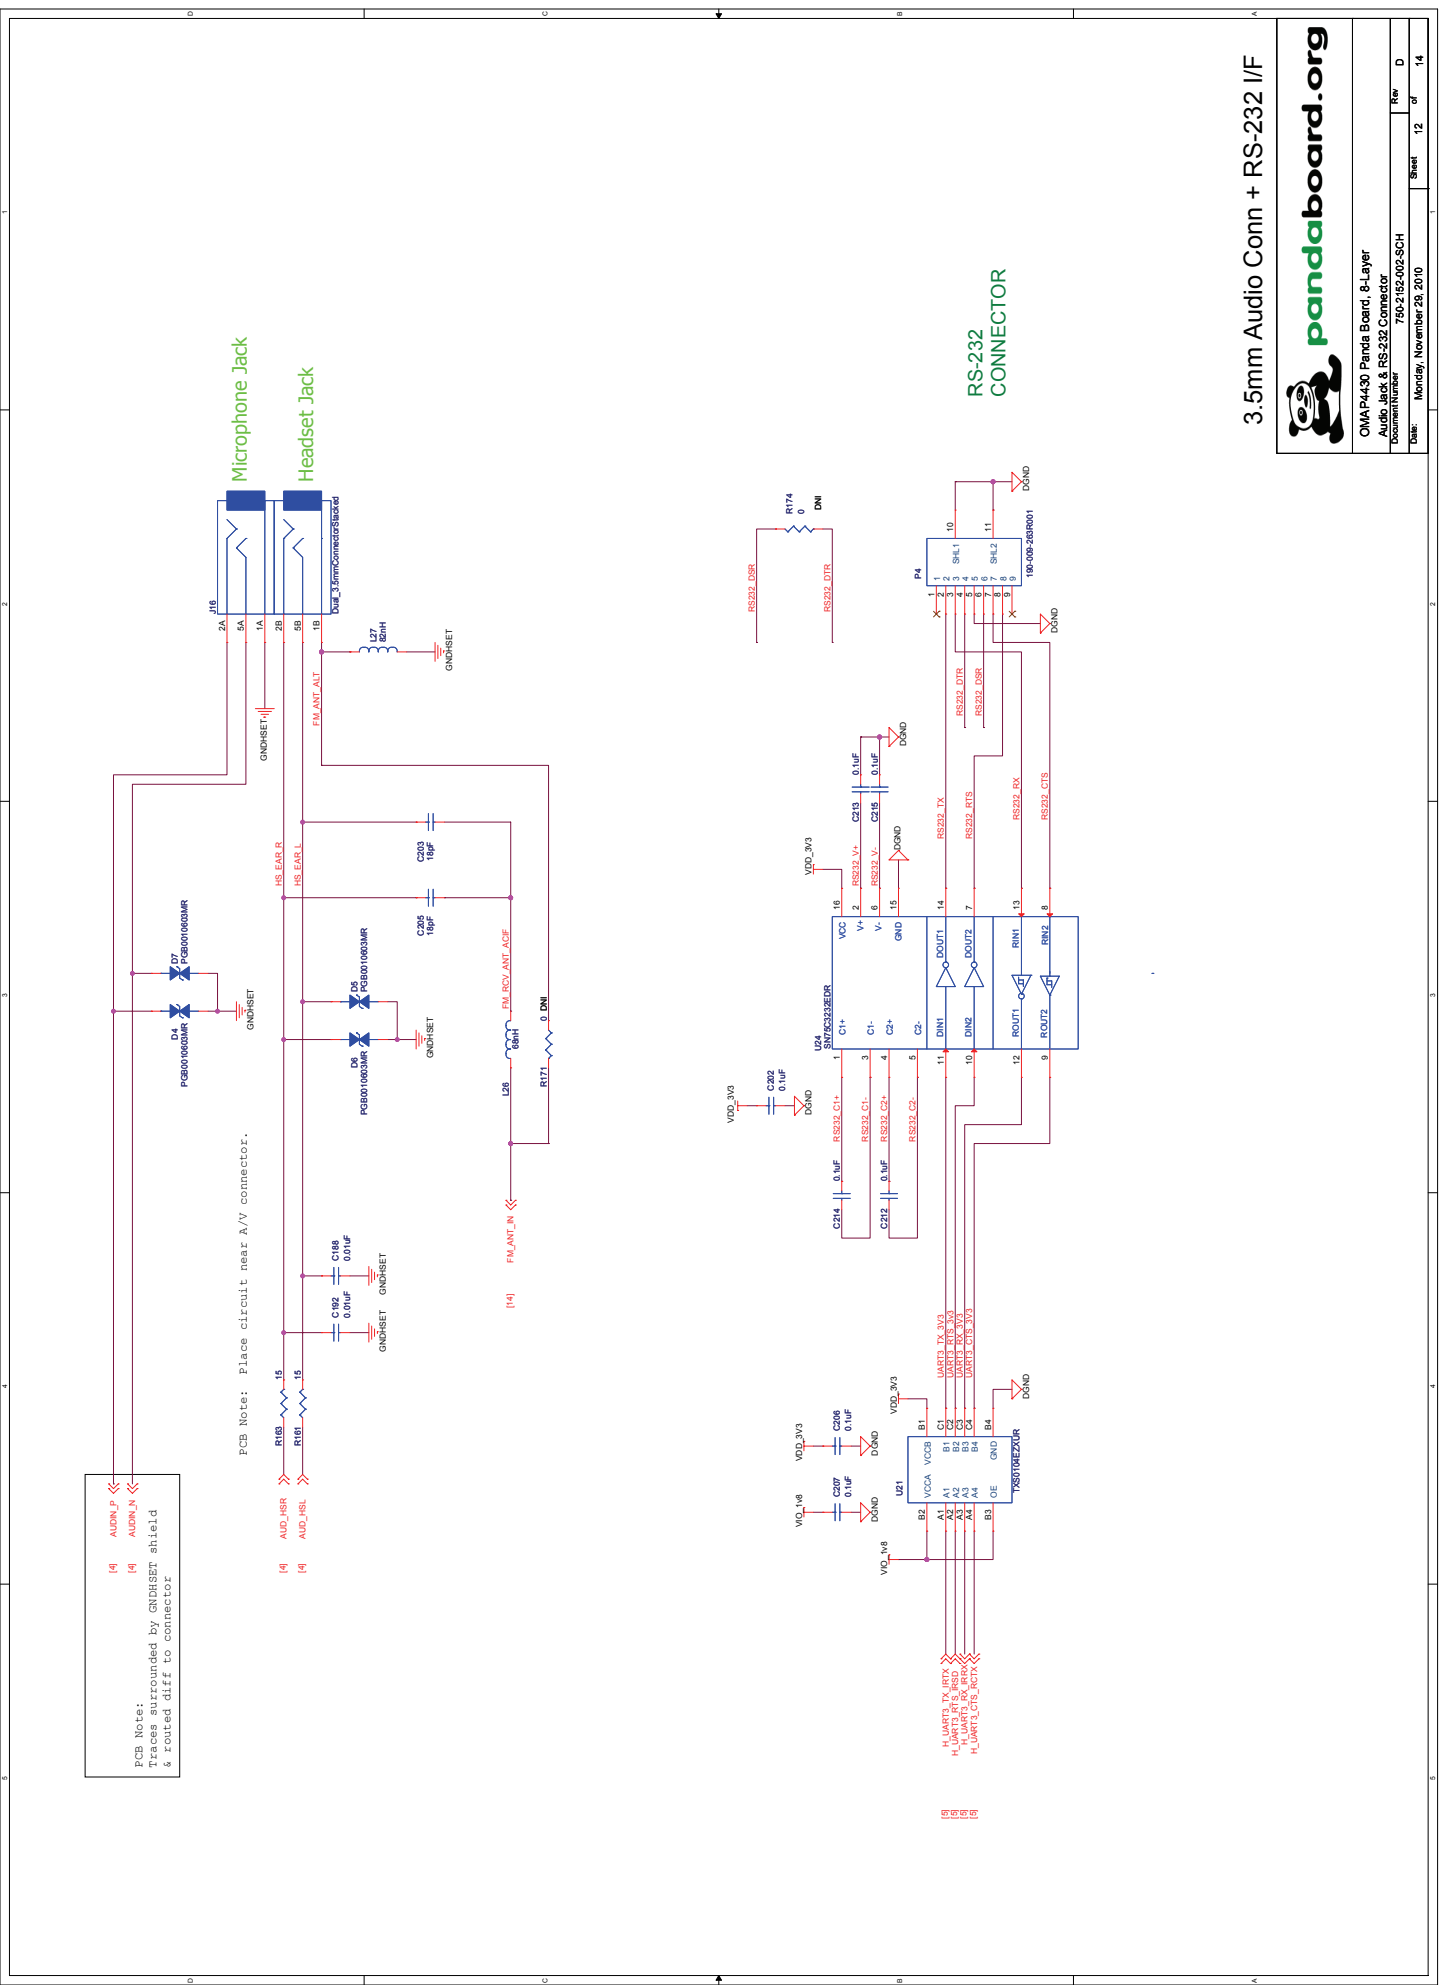
[picture p48: page 12]

Audio Jack & RS-232 Connector

PCB Note: Place circuit near A/V connector.

Traces surrounded by GNDHSET shield

& routed diff to connector

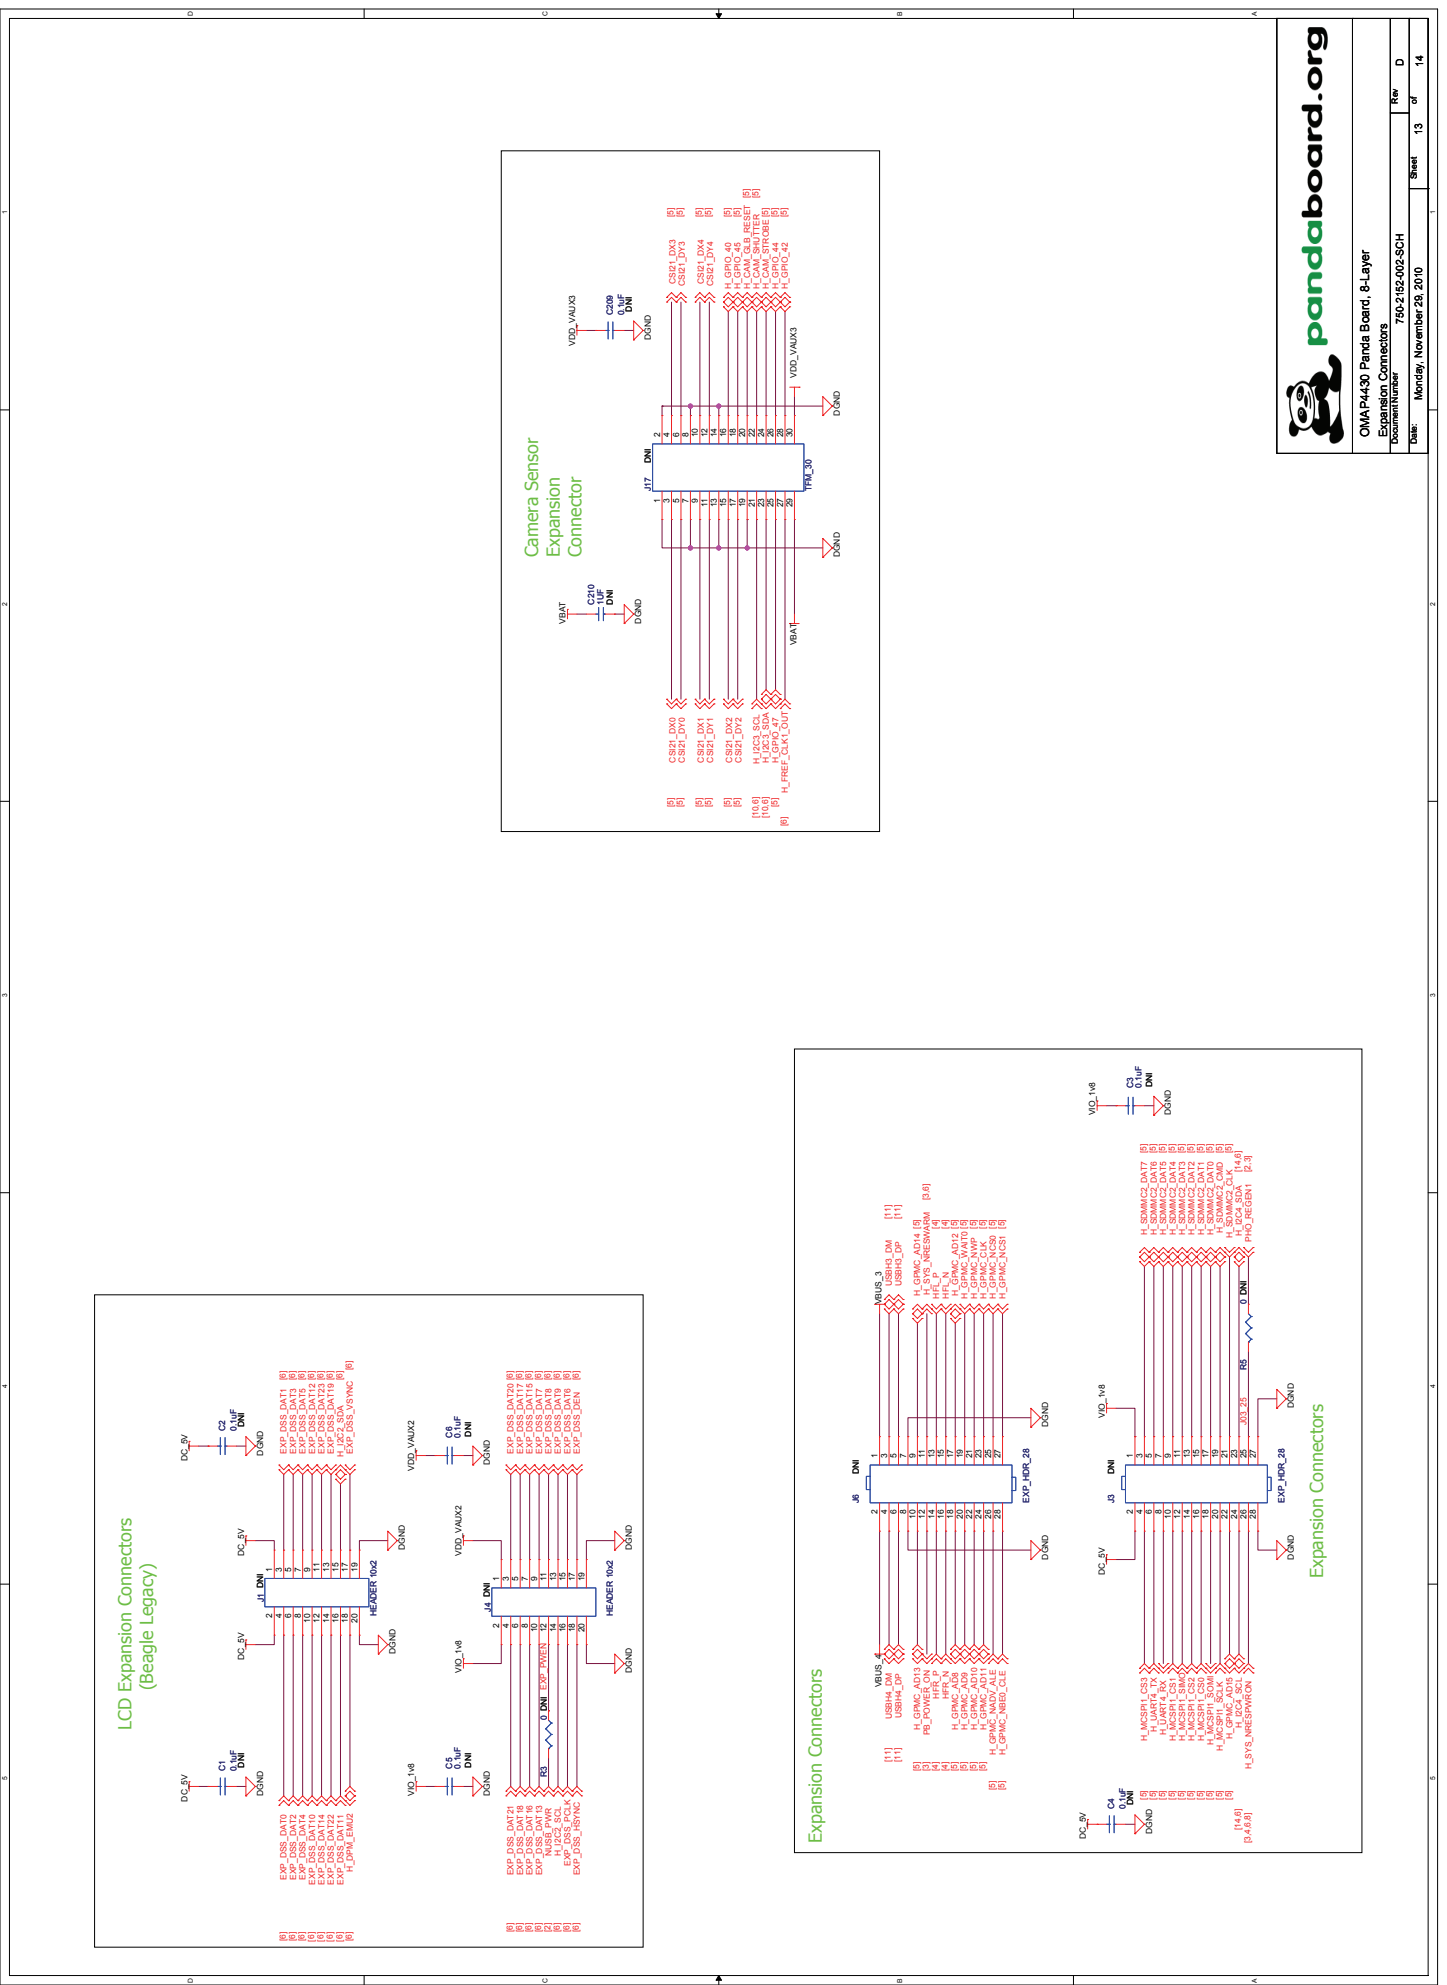
[picture p49: page 13]

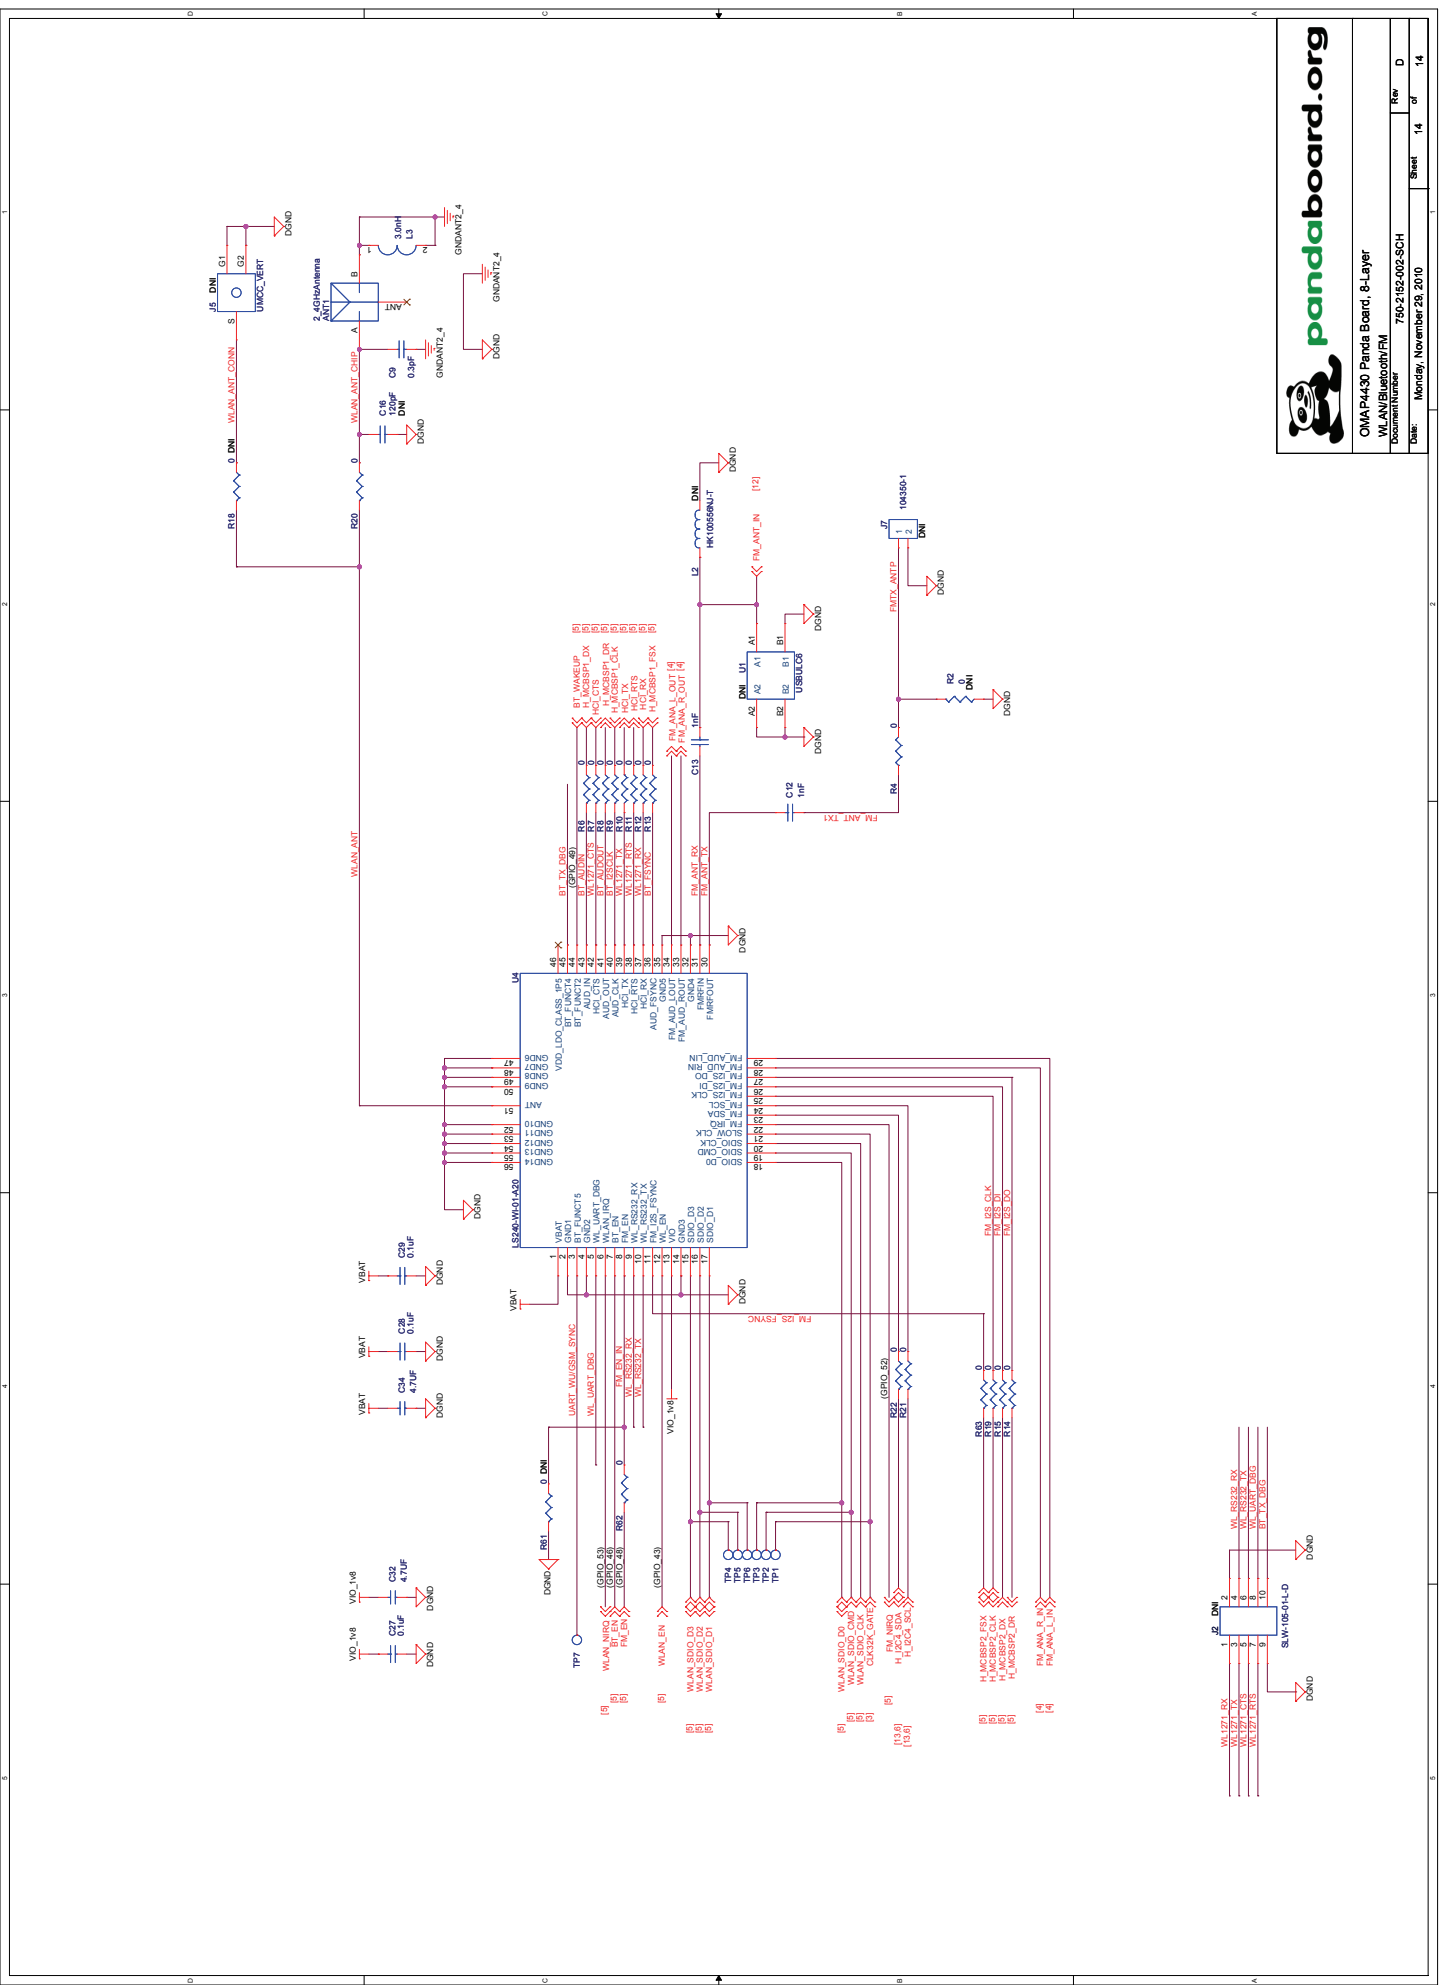
[picture p50: page 14]
