RobertCNelson/pandaboard-docs/PandaboardES-B1/panda-es-b-schematic.pdf

A | Created from 750-2170-001 rev. D schematic (input power and antenna matching component changes). Added resistor on VBAT to allow overall current measurement.
Rev | Date | Notes

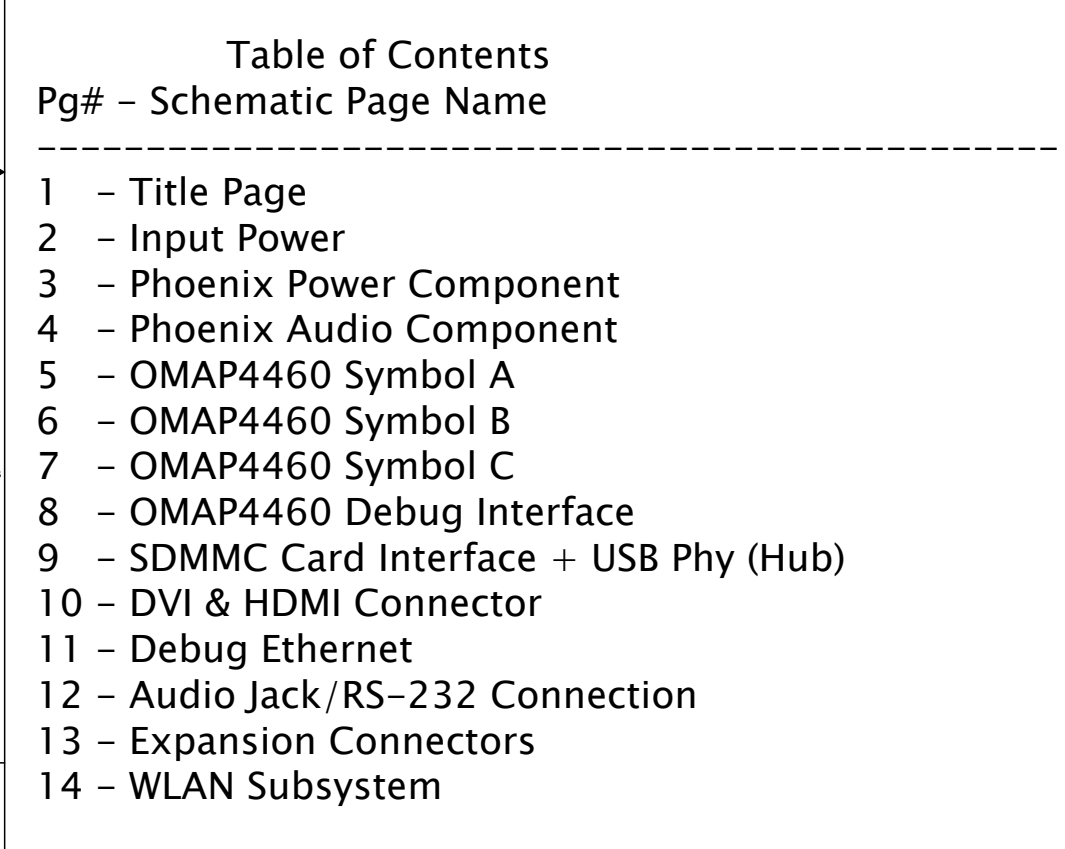
[picture p51: page 1]
Changed antenna matching components per final RF testing. 10/6/2011

Table of Contents

Pg# - Schematic Page Name
1 - Title Page
2 - Input Power
3 - Phoenix Power Component
4 - Phoenix Audio Component
5 - OMAP4460 Symbol A
6 - OMAP4460 Symbol B
7 - OMAP4460 Symbol C
8 - OMAP4460 Debug Interface
9 - SDMMC Card Interface + USB Phy (Hub)
10 - DVI & HDMI Connector
11 - Debug Ethernet
12 - Audio Jack/RS-232 Connection
13 - Expansion Connectors
14 - WLAN Subsystem

OMAP4460 Panda Board, 8-Layer
Title Page

Document Number Document Number Document Number 750-2170-002-SCH 750-2170-002-SCH 750-2170-002-SCH | Rev Rev Rev B B B

Date: Thursday, October 06, 2011 Thursday, October 06, 2011 Thursday, October 06, 2011 | Sheet 1 1 1 of 14 14 14

# Route Sense (B1 and C1) connections as single traces connected close to

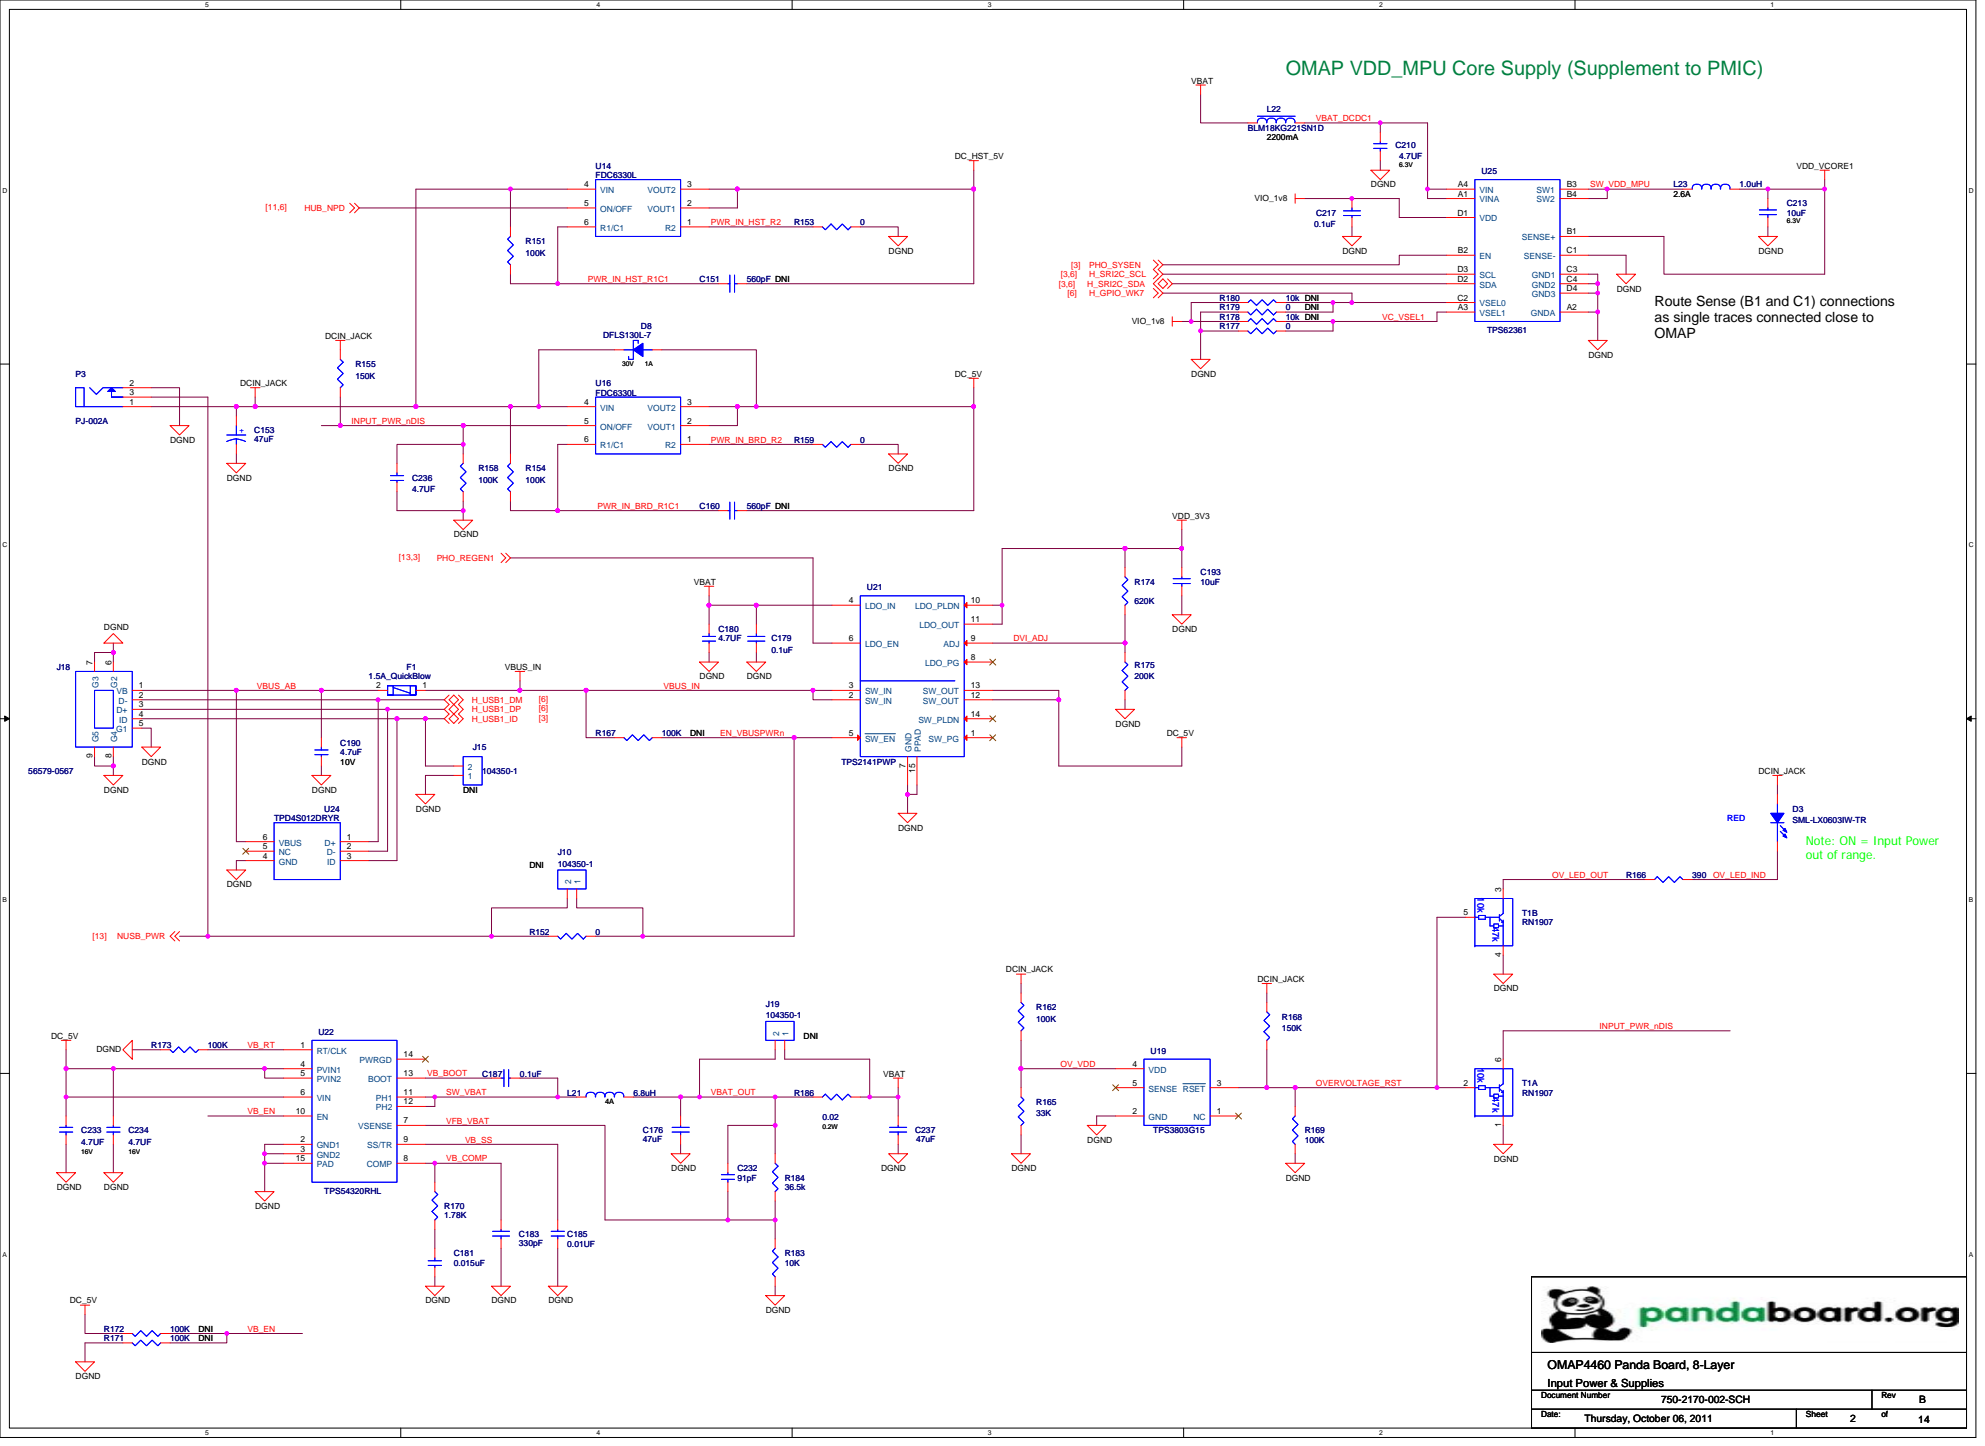
[picture p52: page 2]

OMAP VDD_MPU Core Supply (Supplement to PMIC)

SML-LX0603IW-TR
Note: ON = Input Power
out of range.

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

Thursday, October 06, 2011 Thursday, October 06, 2011 Thursday, October 06, 2011 | 2 2 2 14 14 14

# SMPS Power Inputs & Outputs

## Component ROOM = PMIC

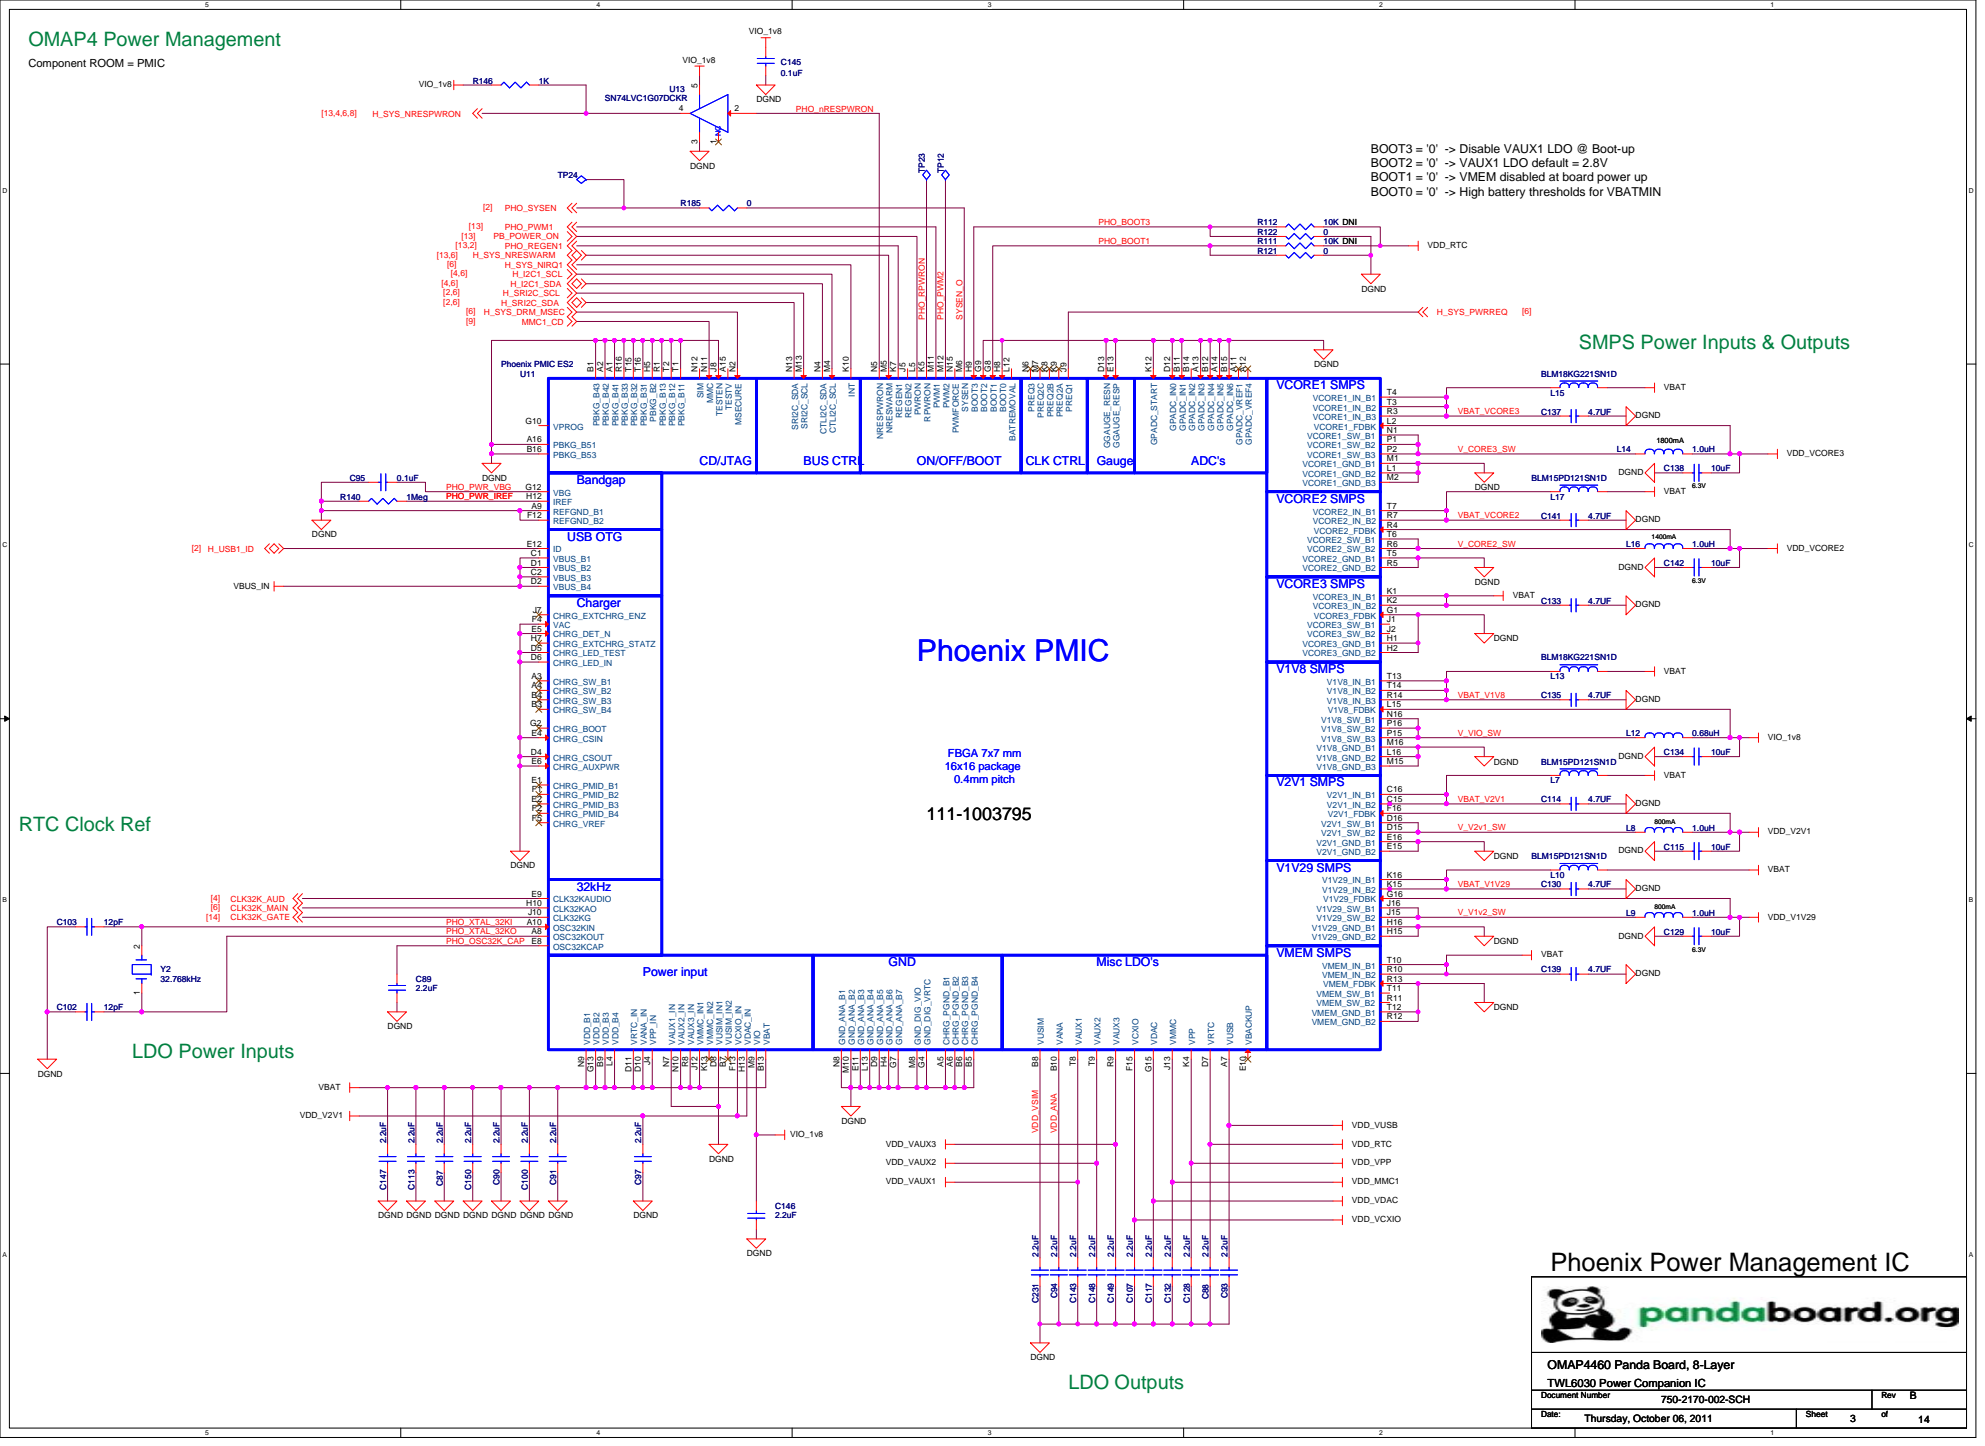
[picture p53: page 3]

BOOT3 = '0' -> Disable VAUX1 LDO @ Boot-up
BOOT2 = '0' -> VAUX1 LDO default = 2.8V
BOOT1 = '0' -> VMEM disabled at board power up
BOOT0 = '0' -> High battery thresholds for VBATMIN

VPROG G10 PBKG_B51 A16 PBKG_B53 B16 CD/JTAG CD/JTAG | BUS CTRL | ON/OFF/BOOT | CLK CTRL | Gauge | ADC's | VCORE1 SMPS

Bandgap Bandgap VBG G12 IREF H12 REFGND_B1 A9 REFGND_B2 F12

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

Thursday, October 06, 2011 Thursday, October 06, 2011 Thursday, October 06, 2011 | 3 3 3 14 14 14

### HS/LS-LDO's

### HS/LS-LDO's

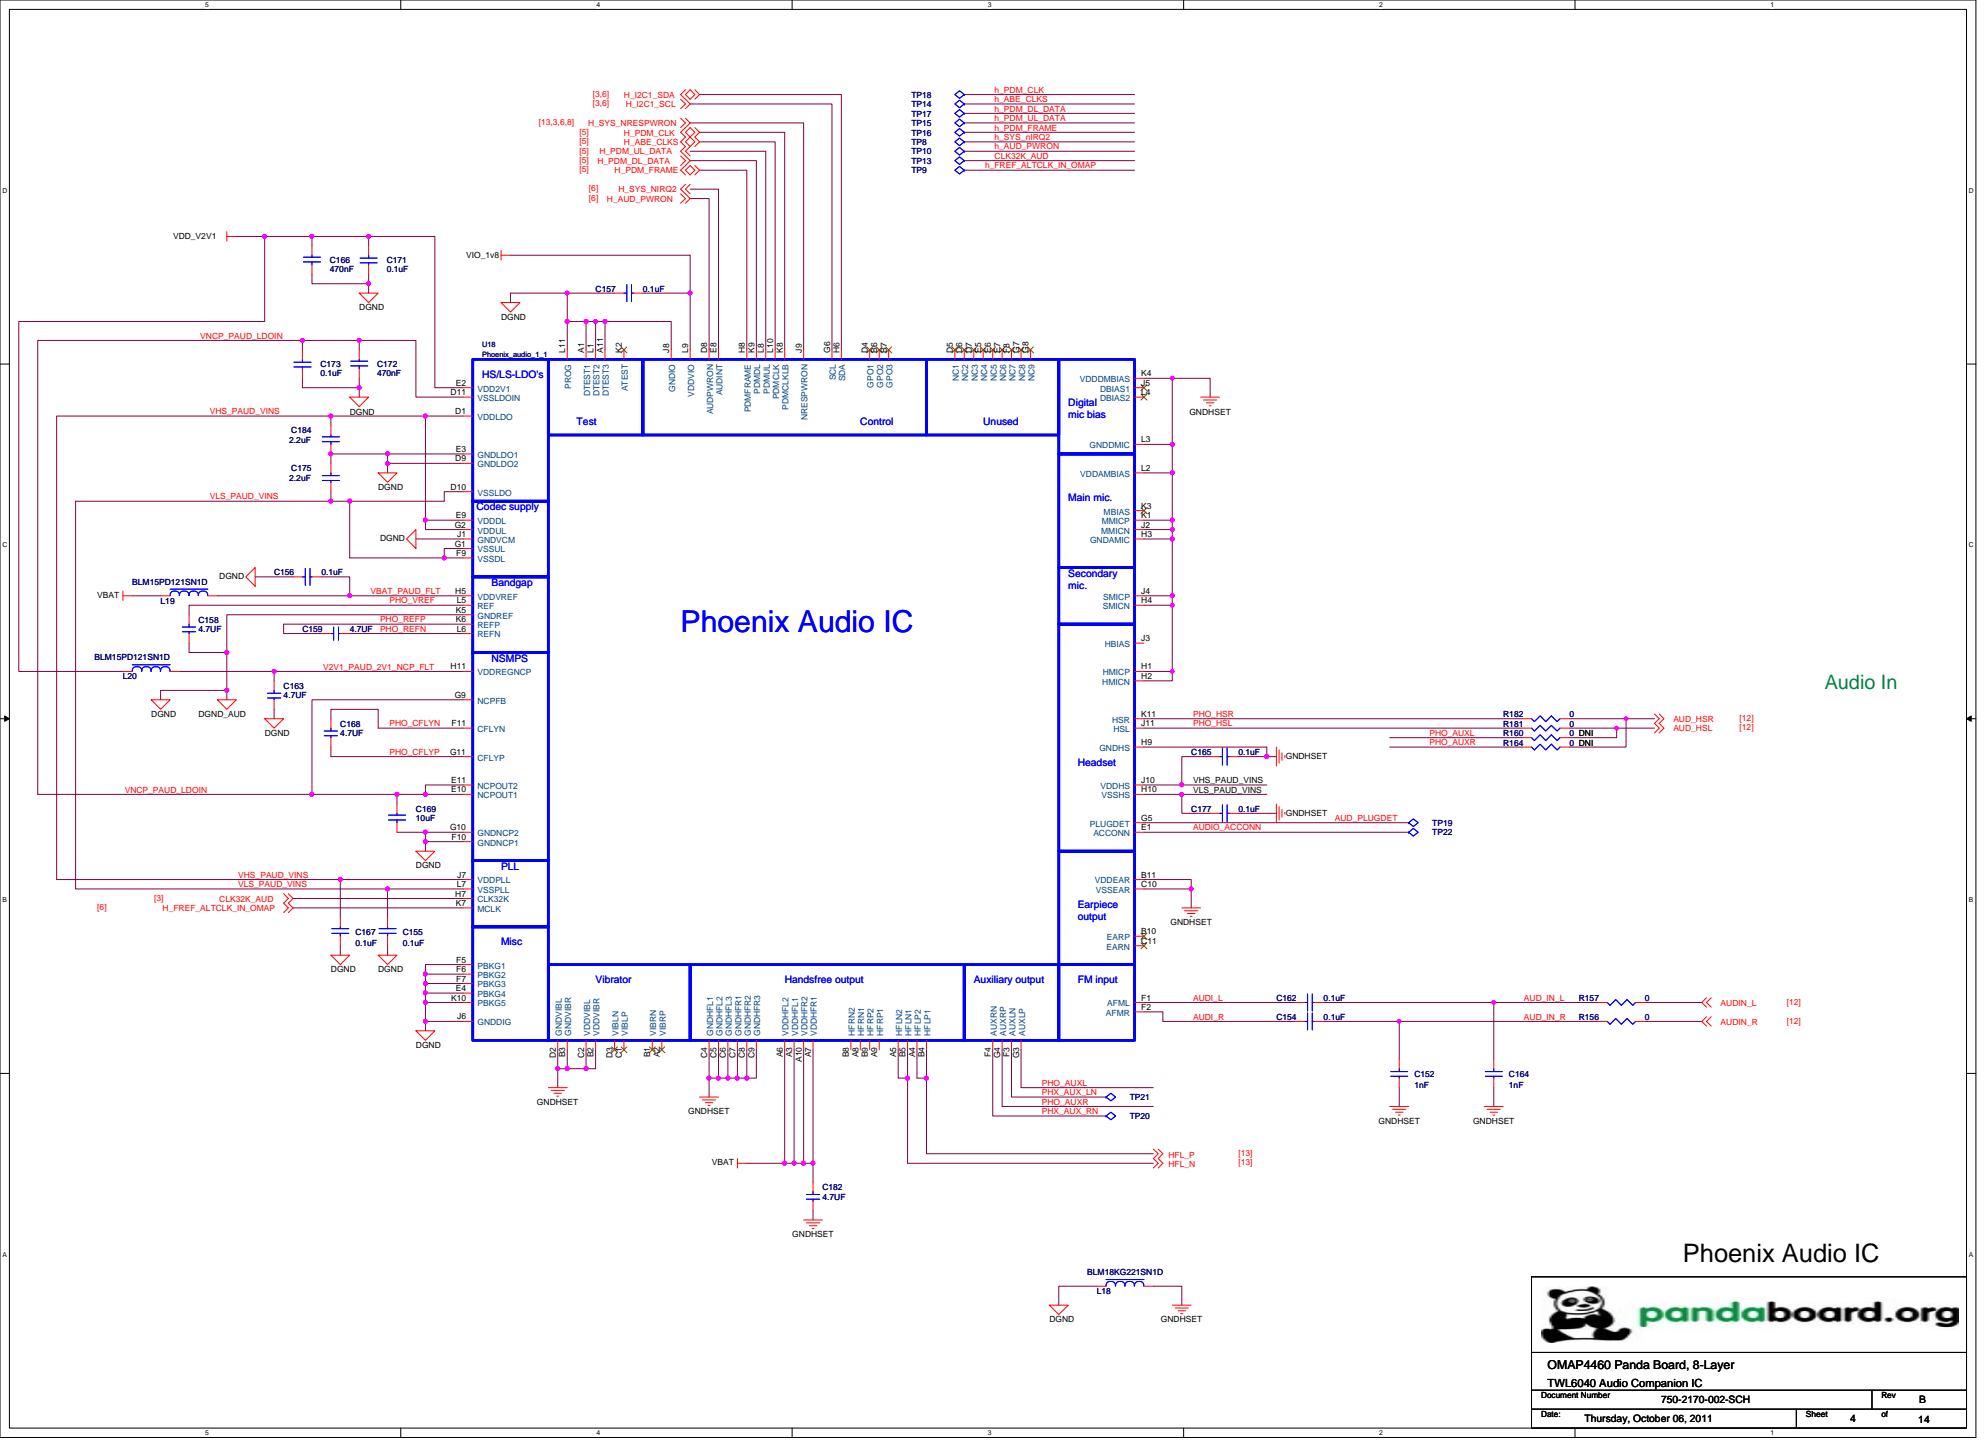
[picture p54: page 4]
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

Thursday, October 06, 2011 Thursday, October 06, 2011 Thursday, October 06, 2011 | 4 4 4 14 14 14

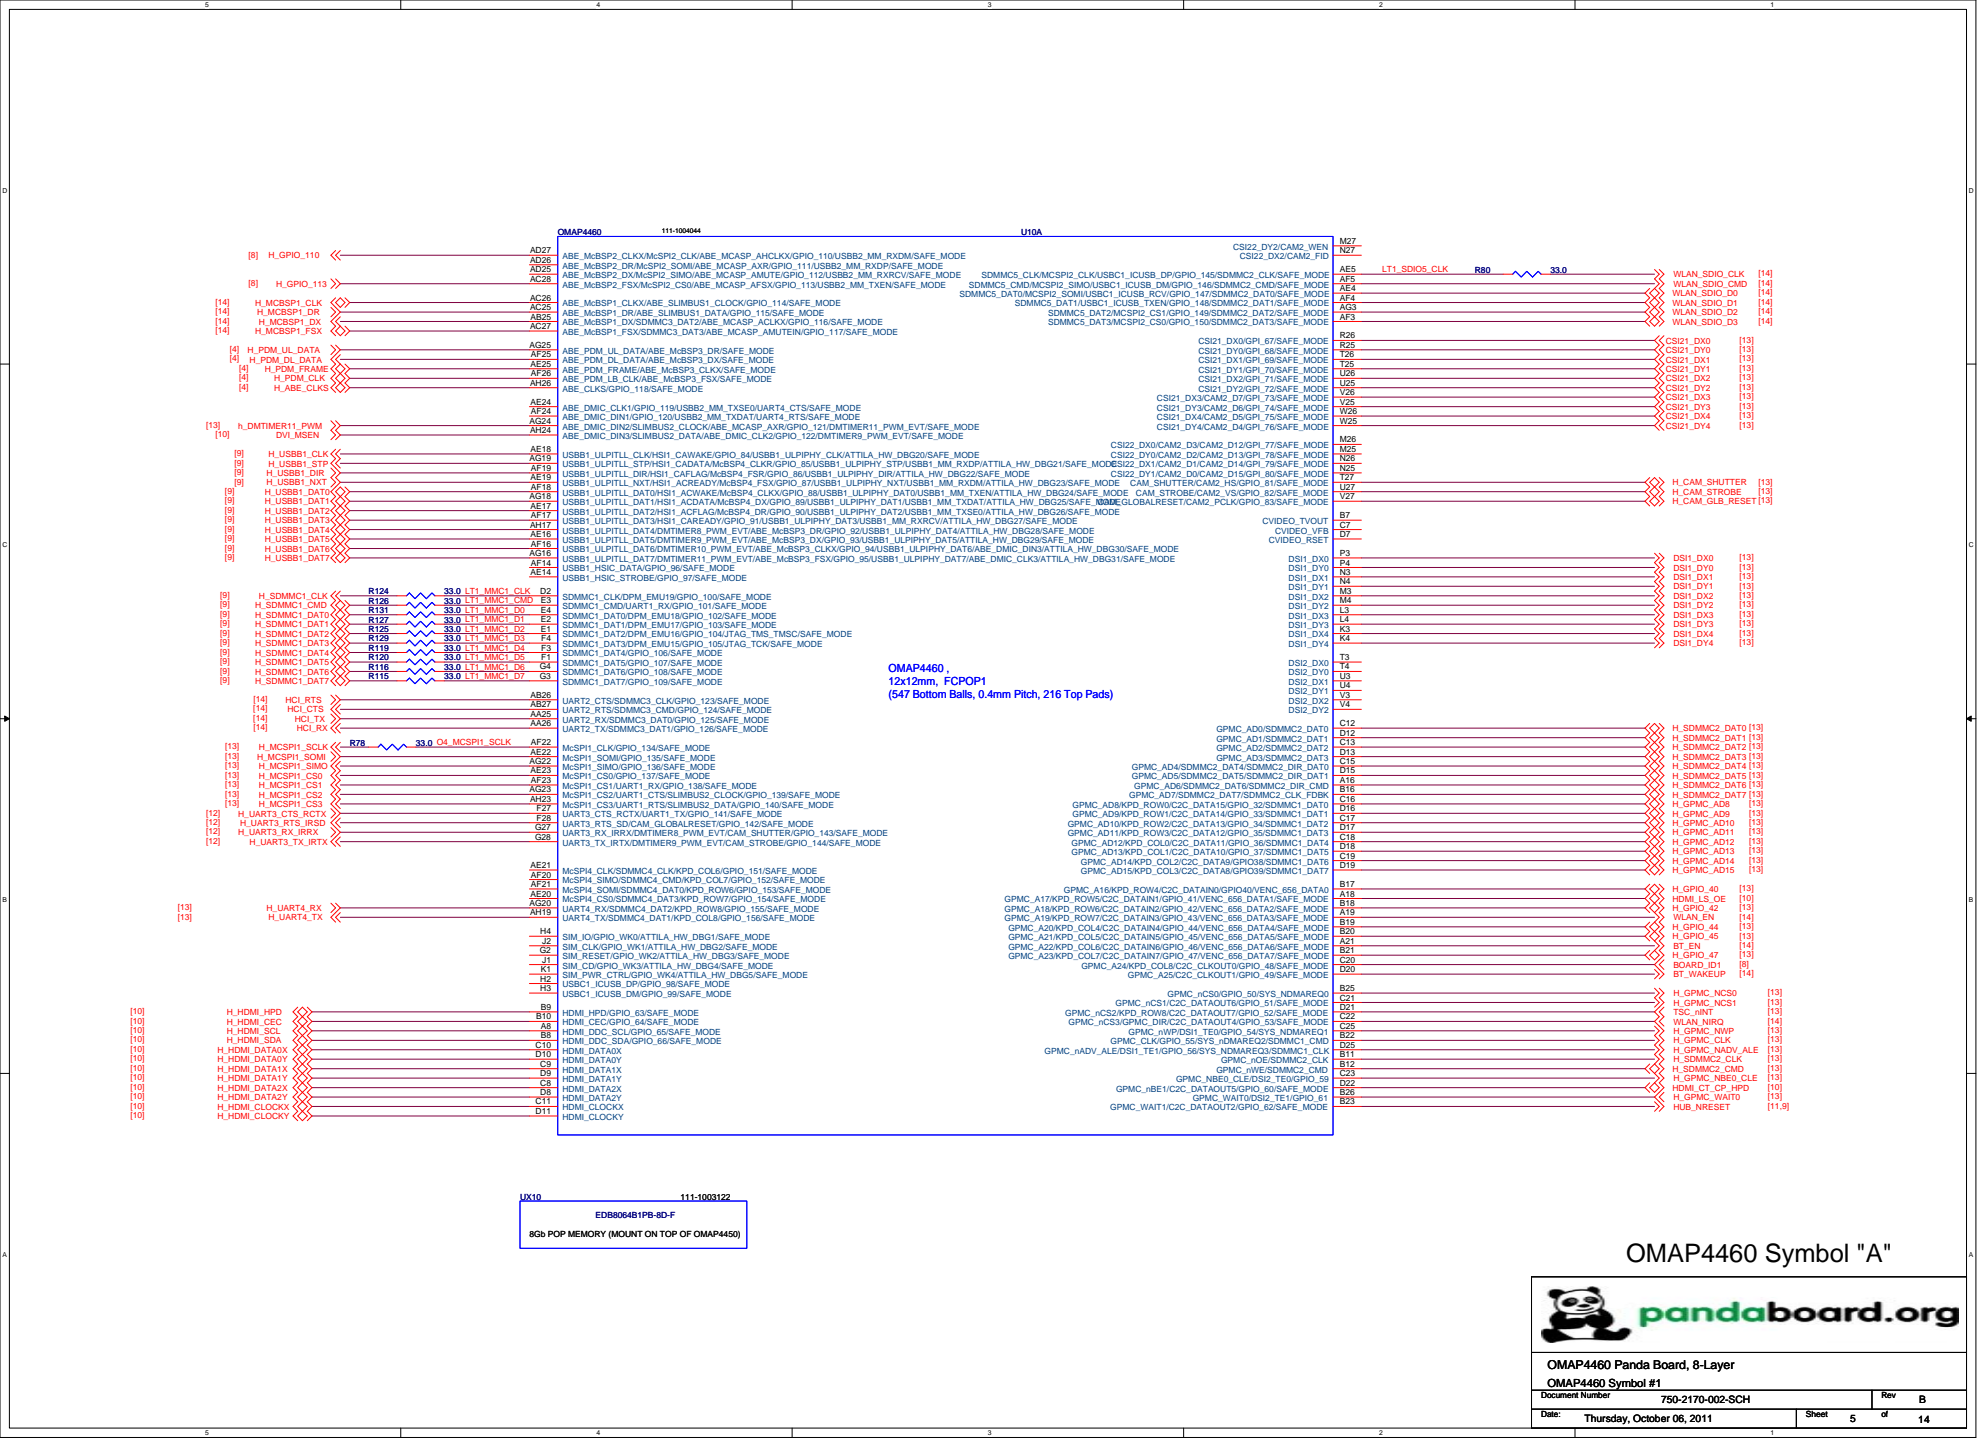
[picture p55: page 5]

8Gb POP MEMORY (MOUNT ON TOP OF OMAP4450)

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

Thursday, October 06, 2011 Thursday, October 06, 2011 Thursday, October 06, 2011 | 5 5 5 14 14 14

I2C

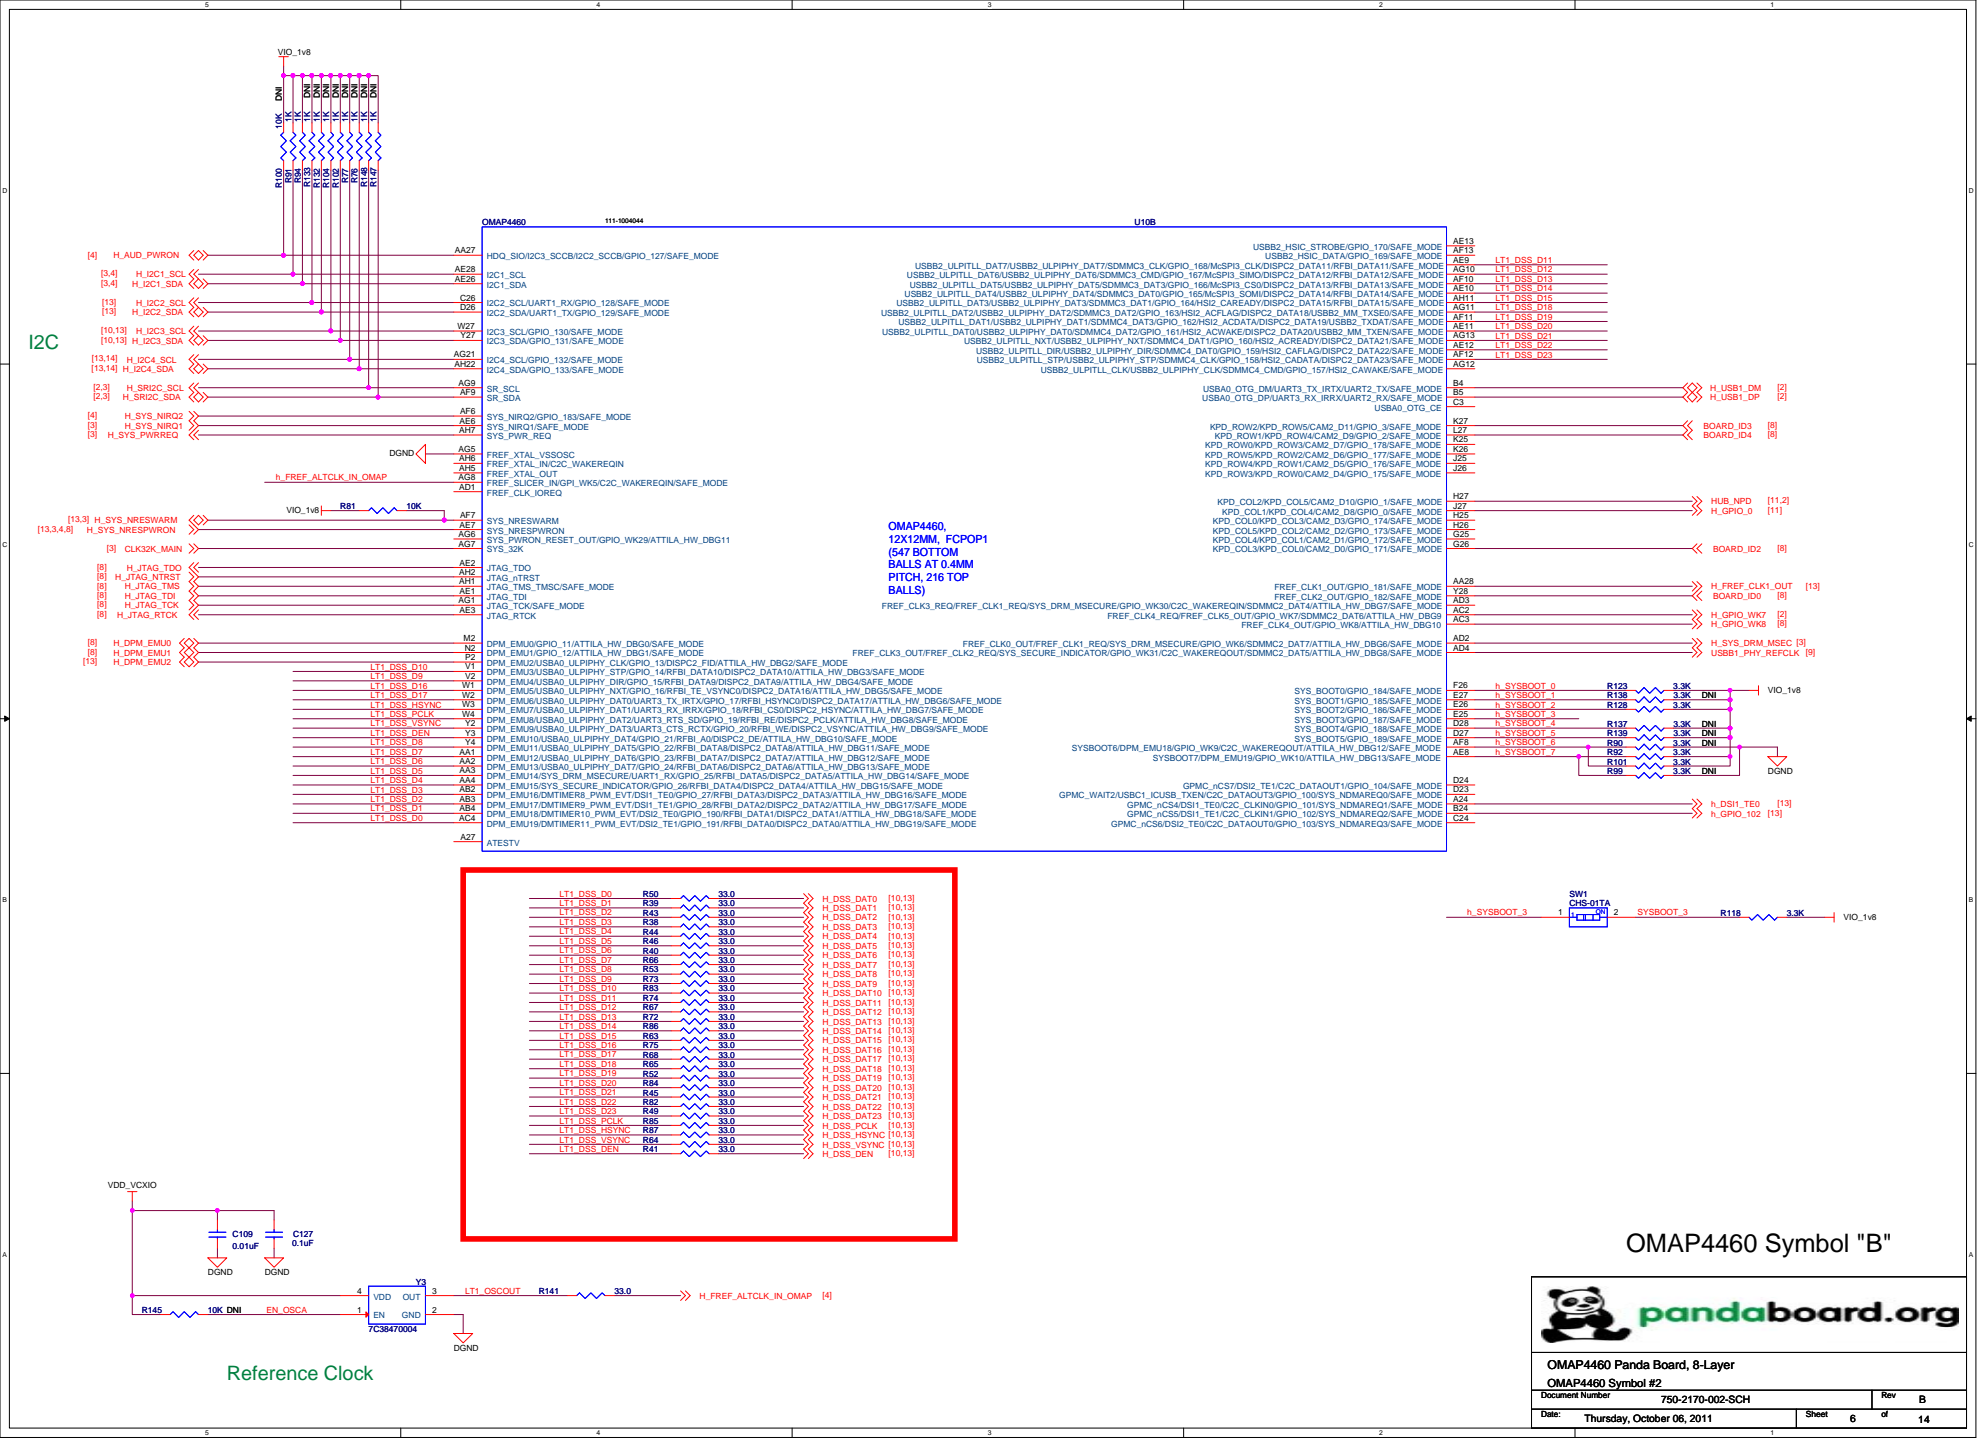
[picture p56: page 6]
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

Thursday, October 06, 2011 Thursday, October 06, 2011 Thursday, October 06, 2011 | 6 6 6 14 14 14

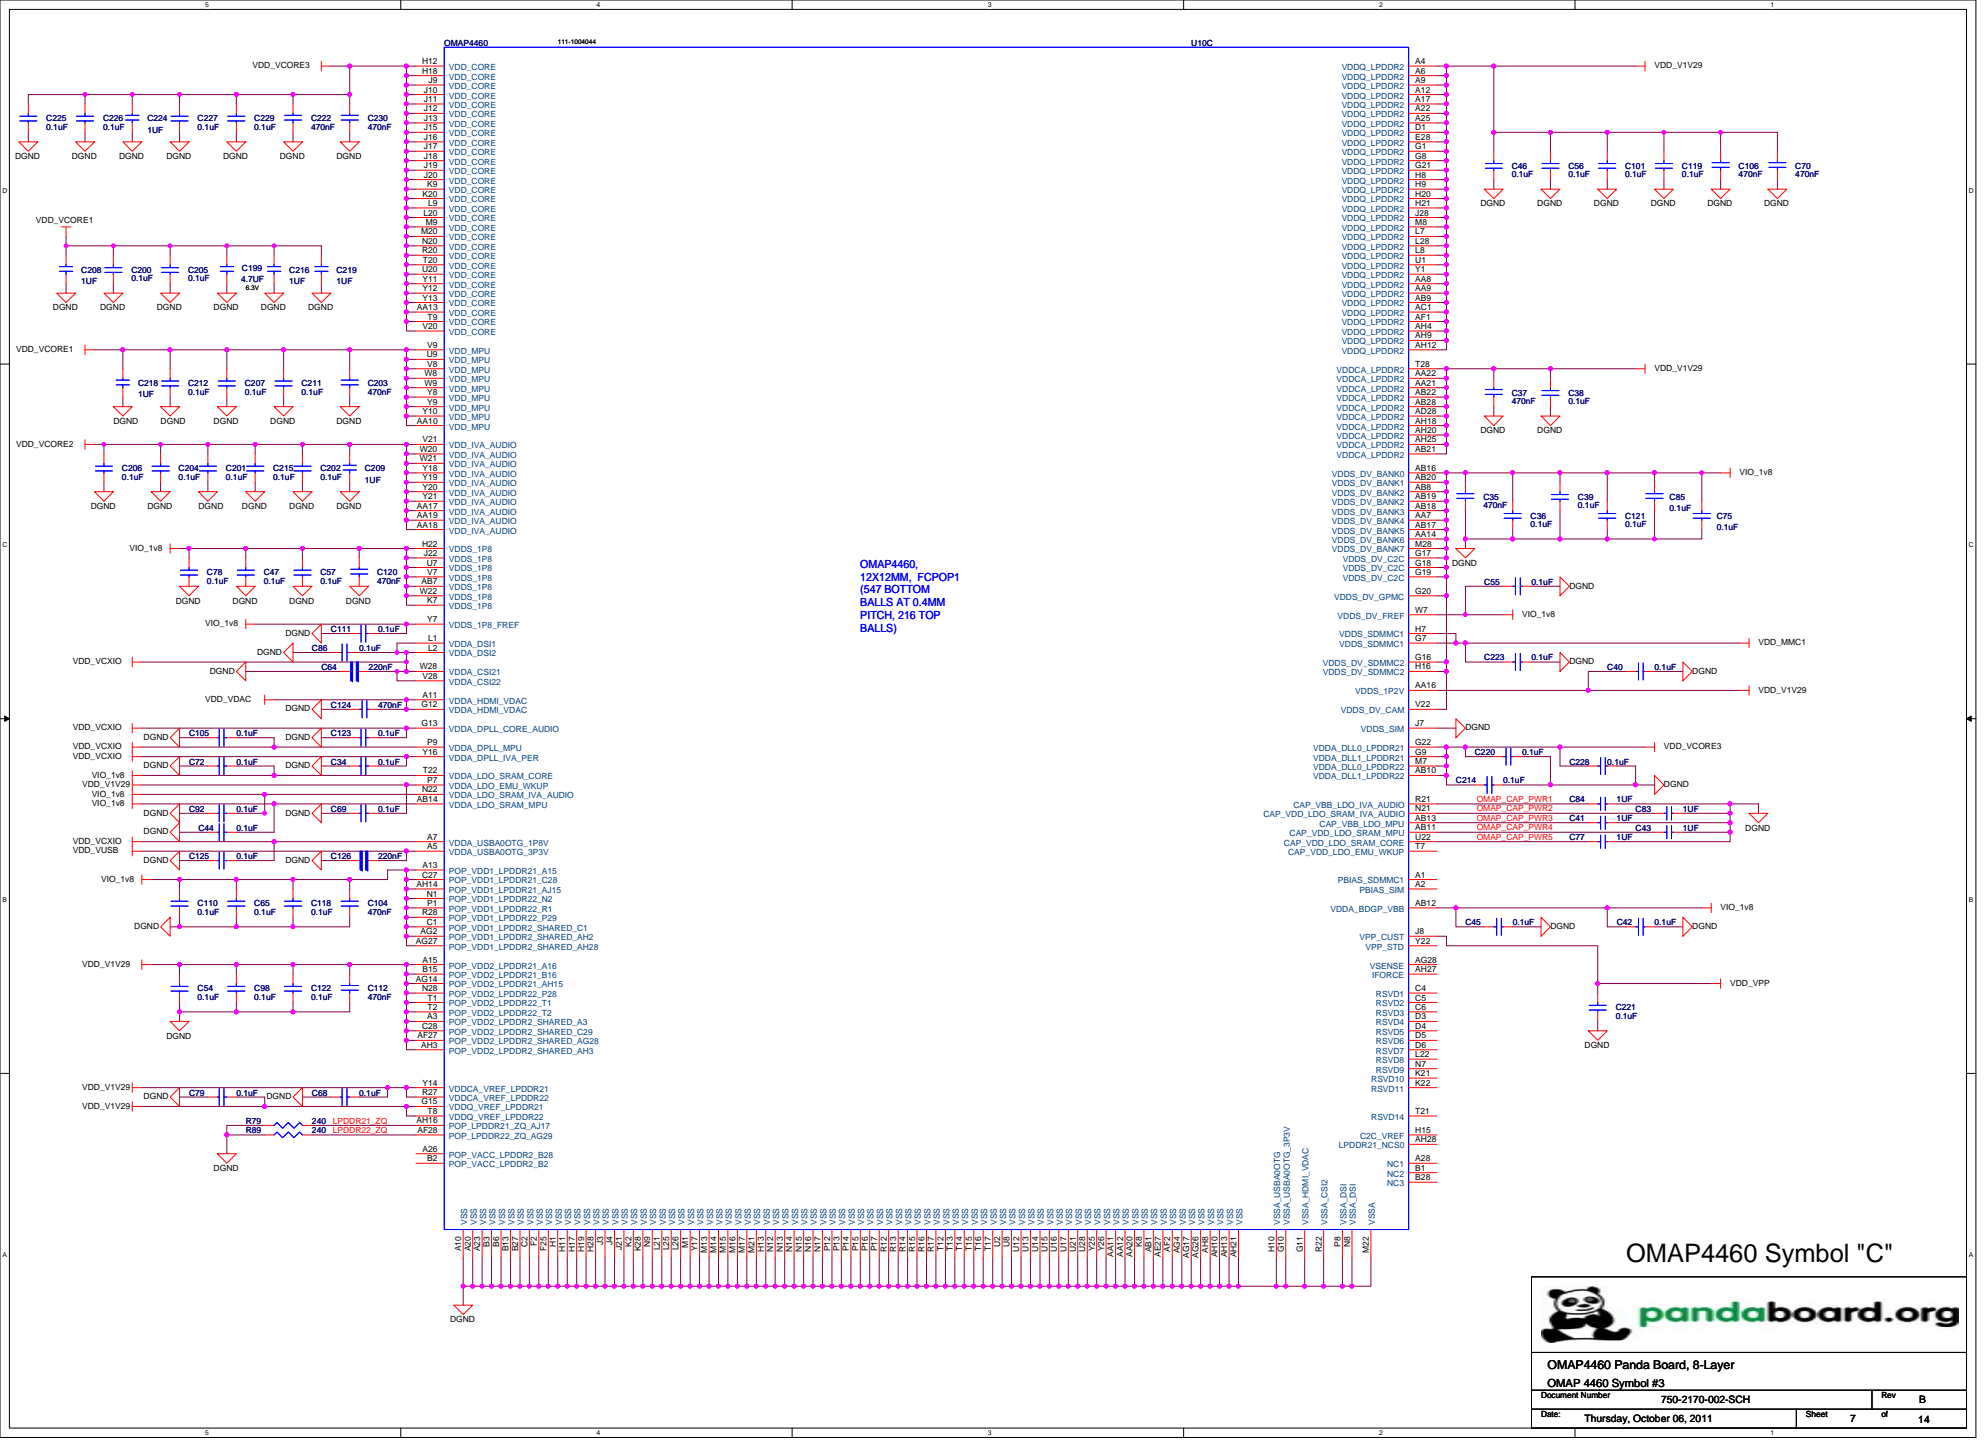
[picture p57: page 7]

VSS M17 VSS M16 VSS M15 VSS M14 VSS M13

VSS P15 VSS P14 VSS P13 VSS P12 VSS N17 VSS N16 VSS N15 VSS N14 VSS N13 VSS N12

VSS T14 VSS T13 VSS T12 VSS R17 VSS R16 VSS R15 VSS R14 VSS R13 VSS R12 VSS P17

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

Thursday, October 06, 2011 Thursday, October 06, 2011 Thursday, October 06, 2011 | 7 7 7 14 14 14

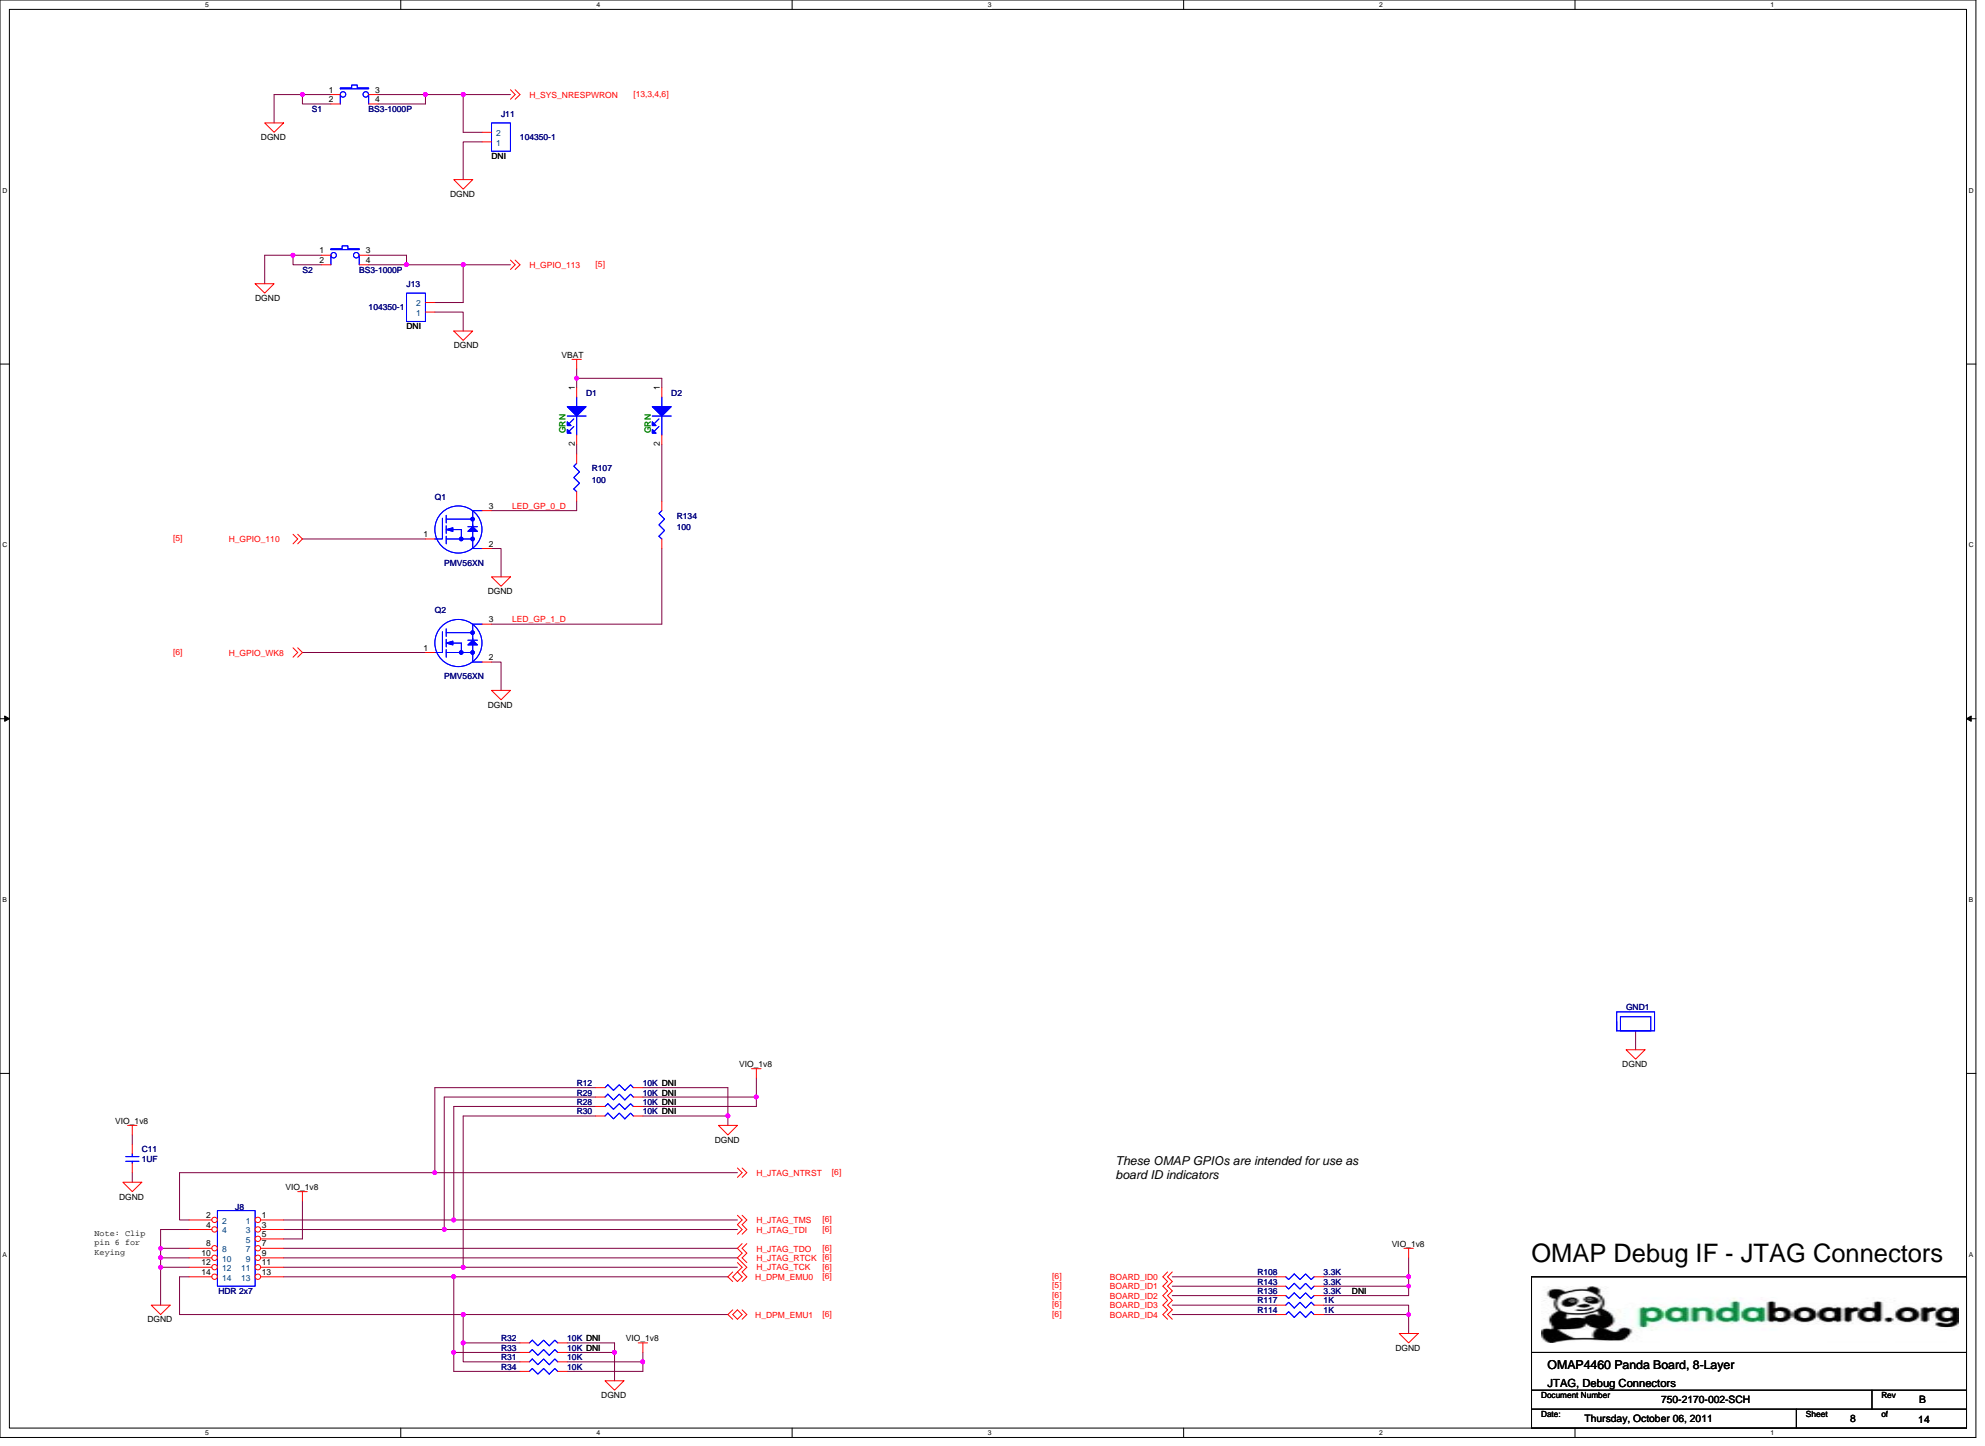
[picture p58: page 8]

These OMAP GPIOs are intended for use as
board ID indicators

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

Thursday, October 06, 2011 Thursday, October 06, 2011 Thursday, October 06, 2011 | 8 8 8 14 14 14

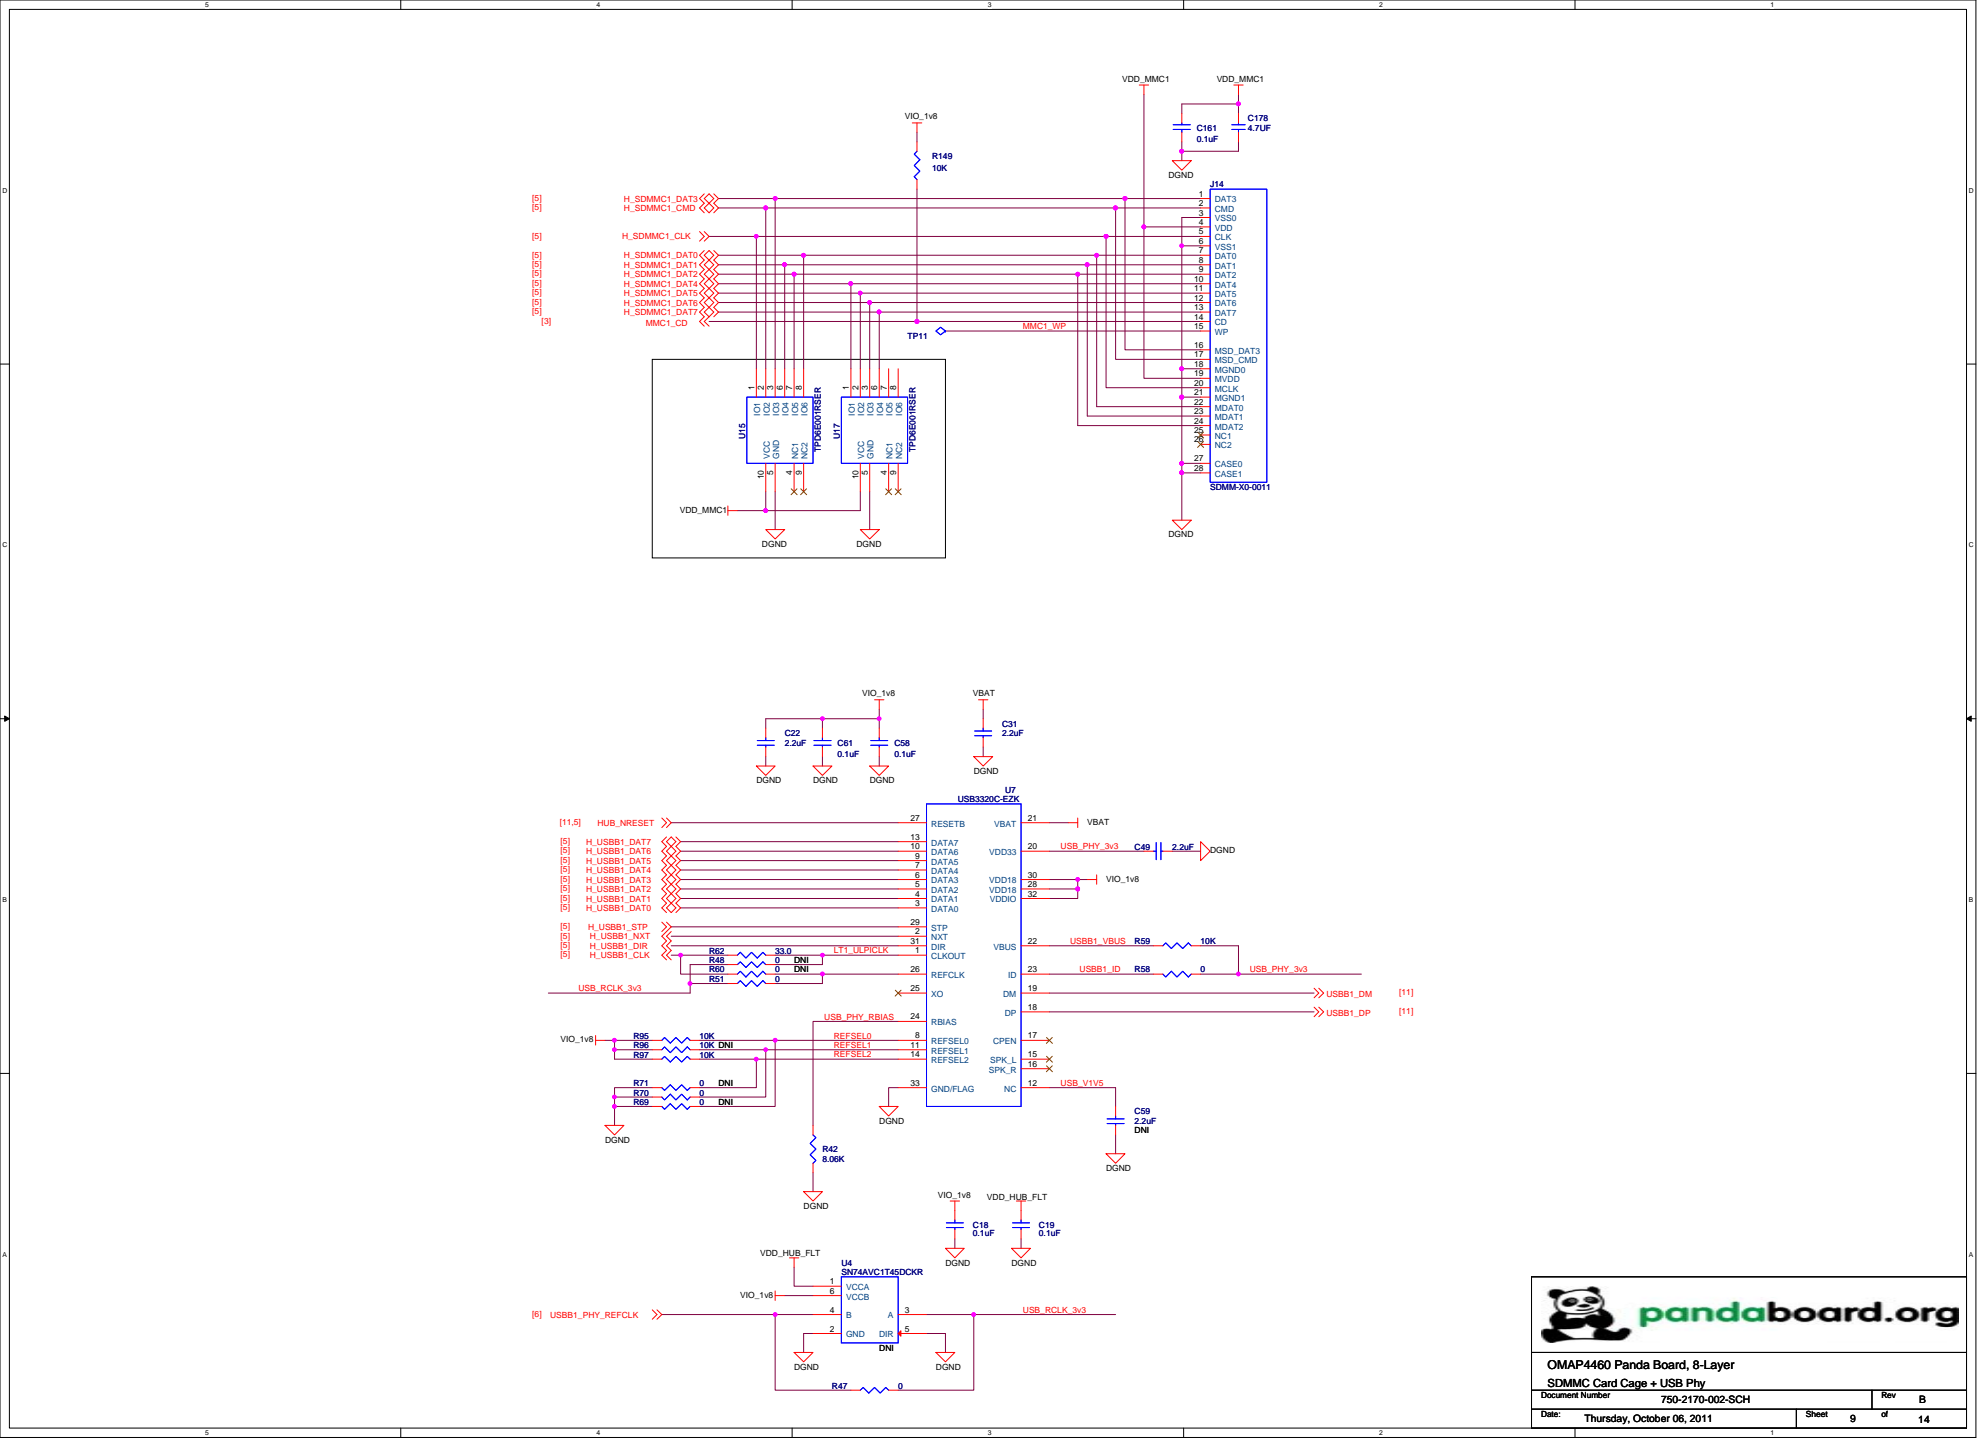
[picture p59: page 9]

OMAP4460 Panda Board, 8-Layer
SDMMC Card Cage + USB Phy

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

Thursday, October 06, 2011 Thursday, October 06, 2011 Thursday, October 06, 2011 | 9 9 9 14 14 14

# HDMI Connector Type A

# HDMI - Charge Pump/

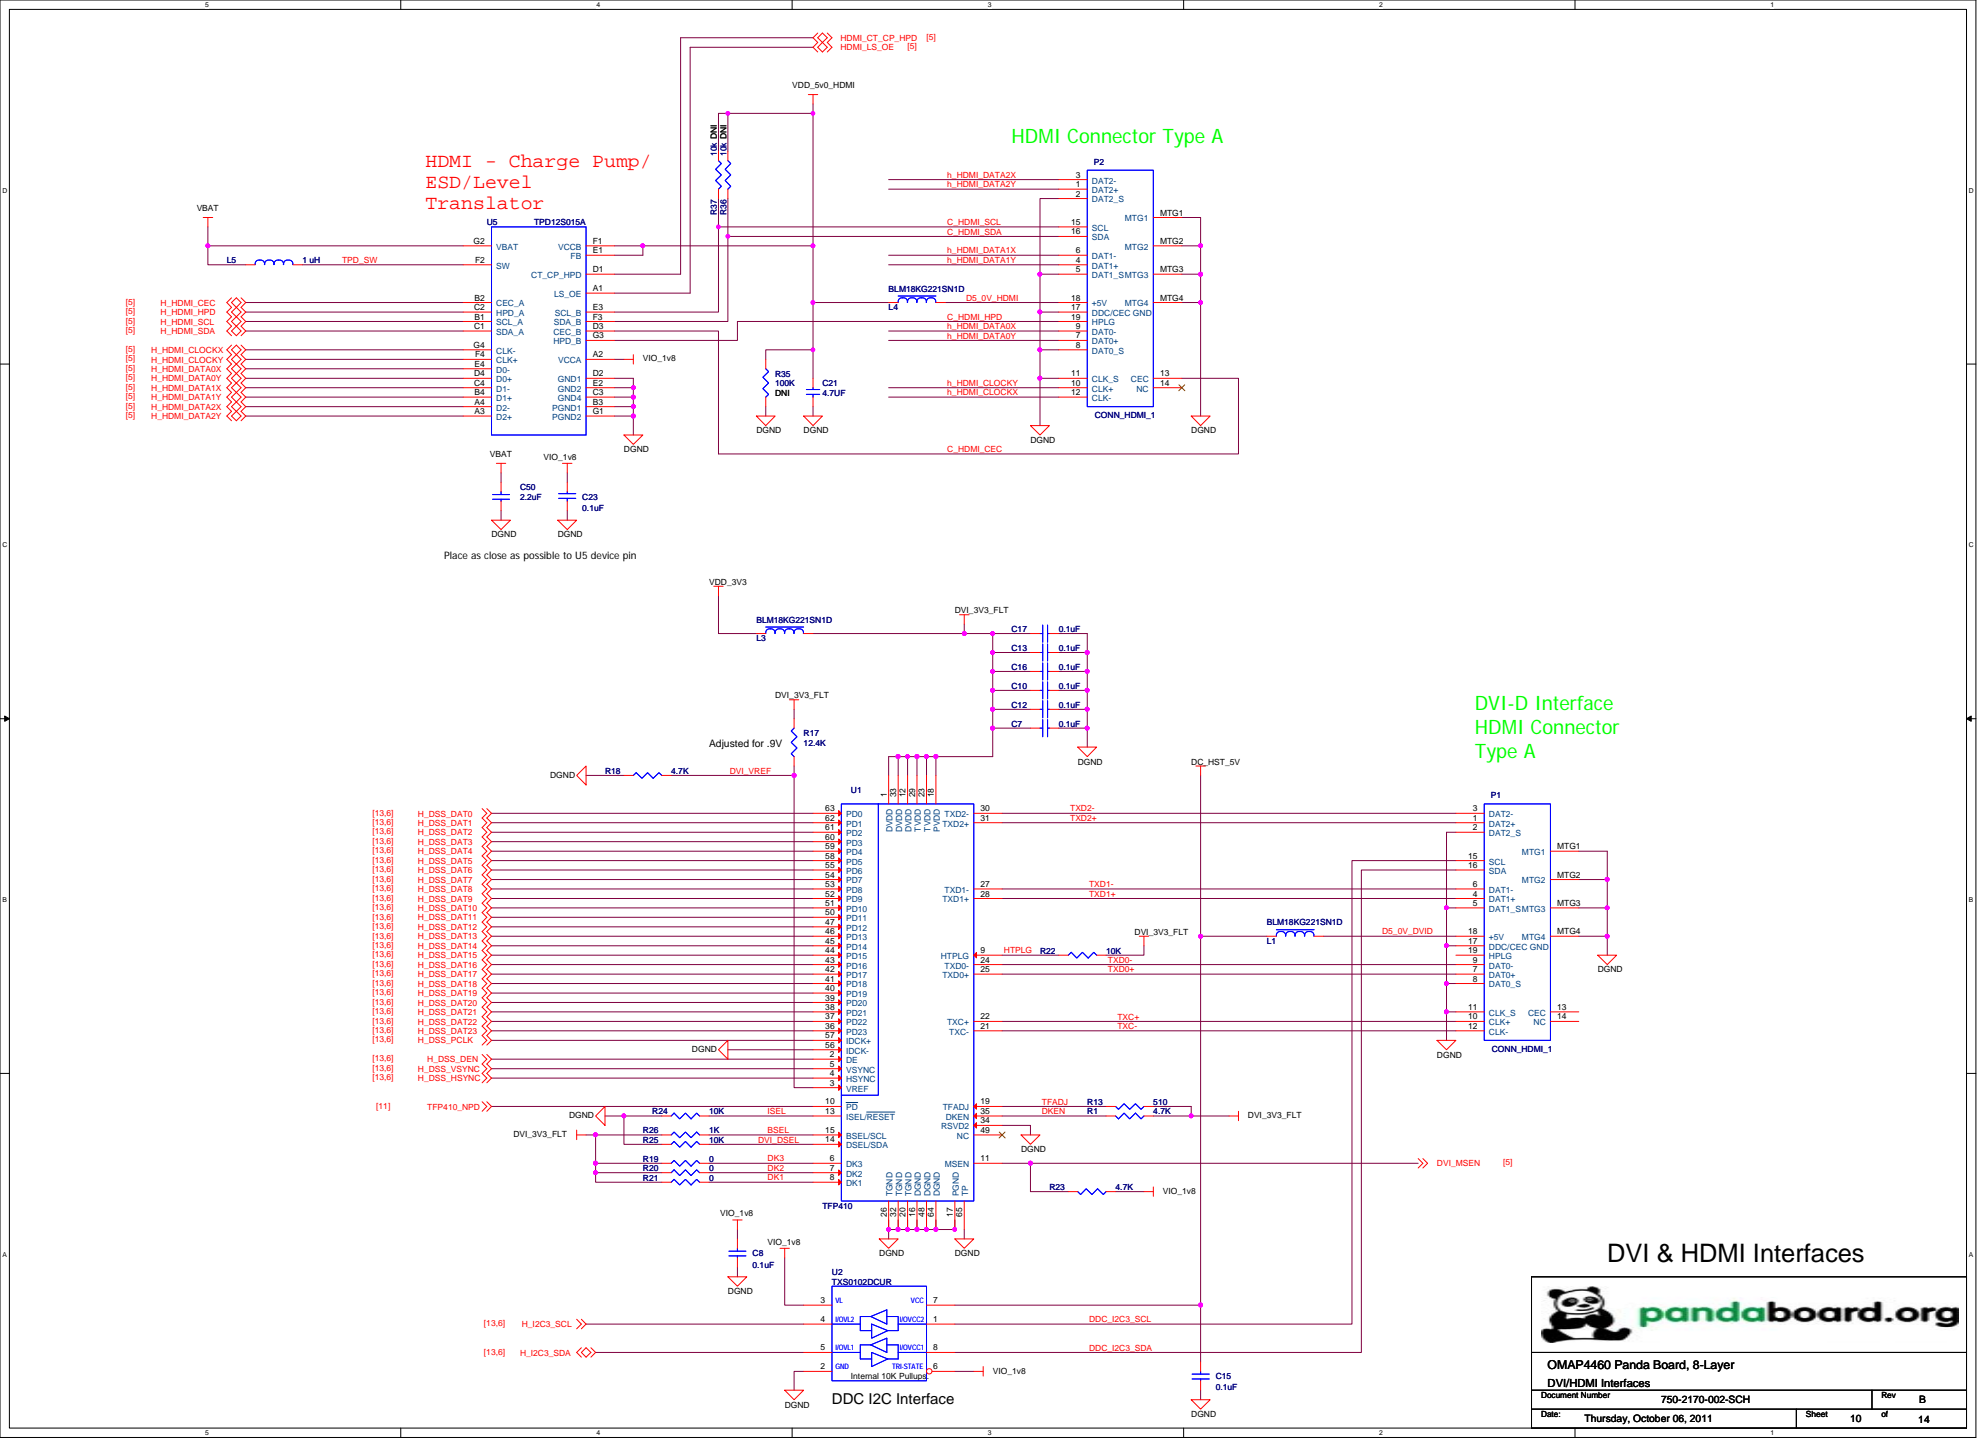
[picture p60: page 10]

Place as close as possible to U5 device pin

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

Thursday, October 06, 2011 Thursday, October 06, 2011 Thursday, October 06, 2011 | 10 10 10 14 14 14

# USB + Ethernet Hub

### Upstream

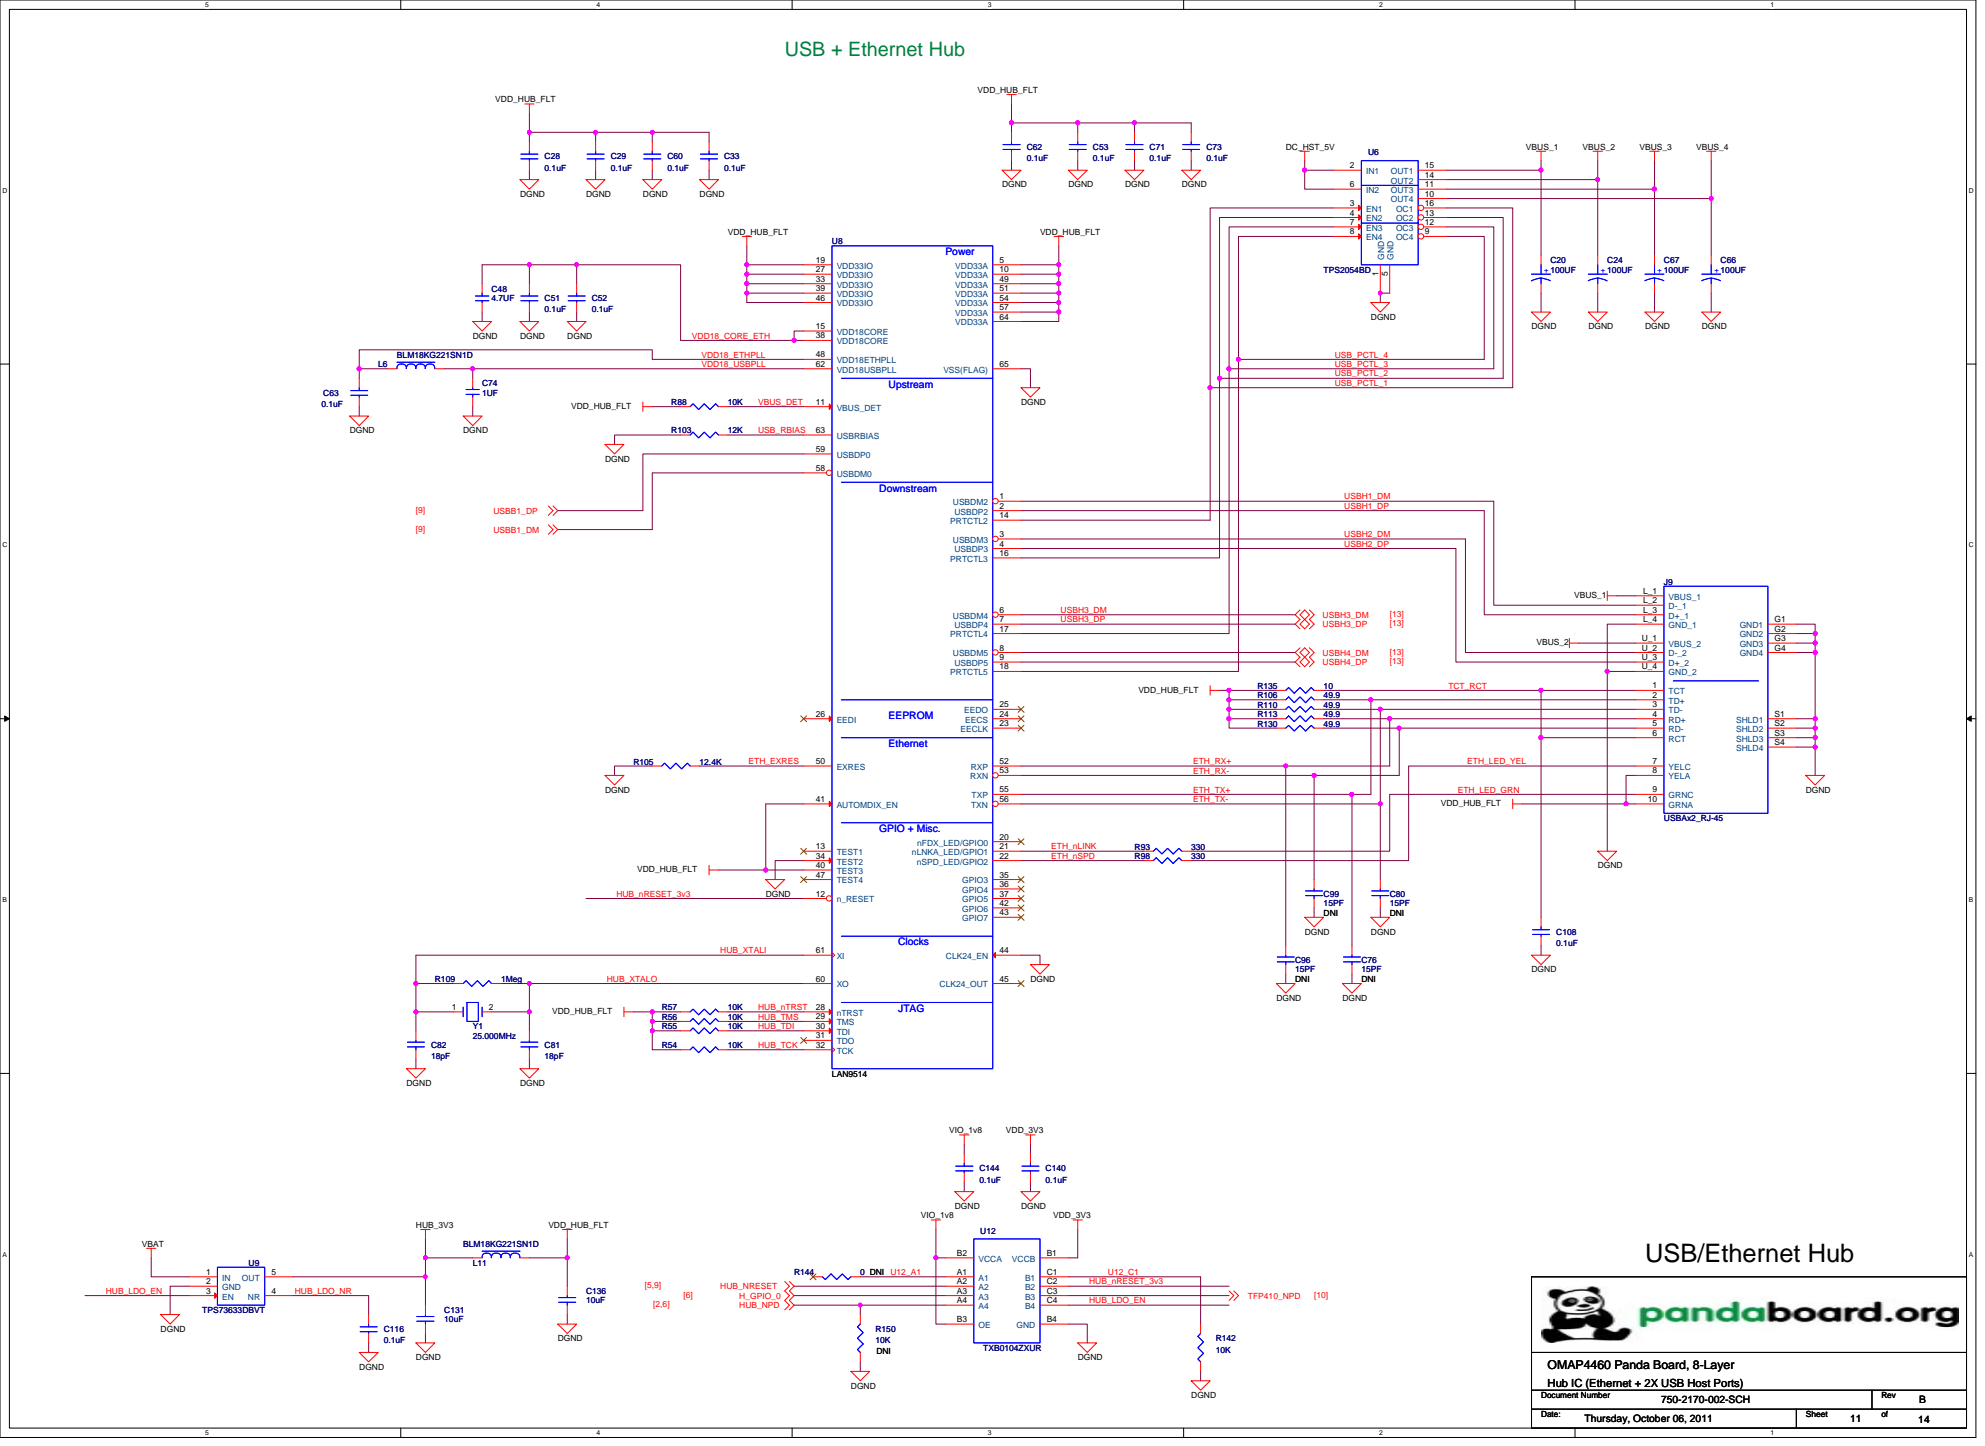
[picture p61: page 11]

YELC 7

ETH_RX- | ETH_LED_GRN | YELA 8 GRNC 9

ETH_TX+
ETH_TX- | | | GRNA 10

OMAP4460 Panda Board, 8-Layer
Hub IC (Ethernet + 2X USB Host Ports)

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

Thursday, October 06, 2011 Thursday, October 06, 2011 Thursday, October 06, 2011 | 11 11 11 14 14 14

## PCB Note: Traces surrounded by GNDHSET shield

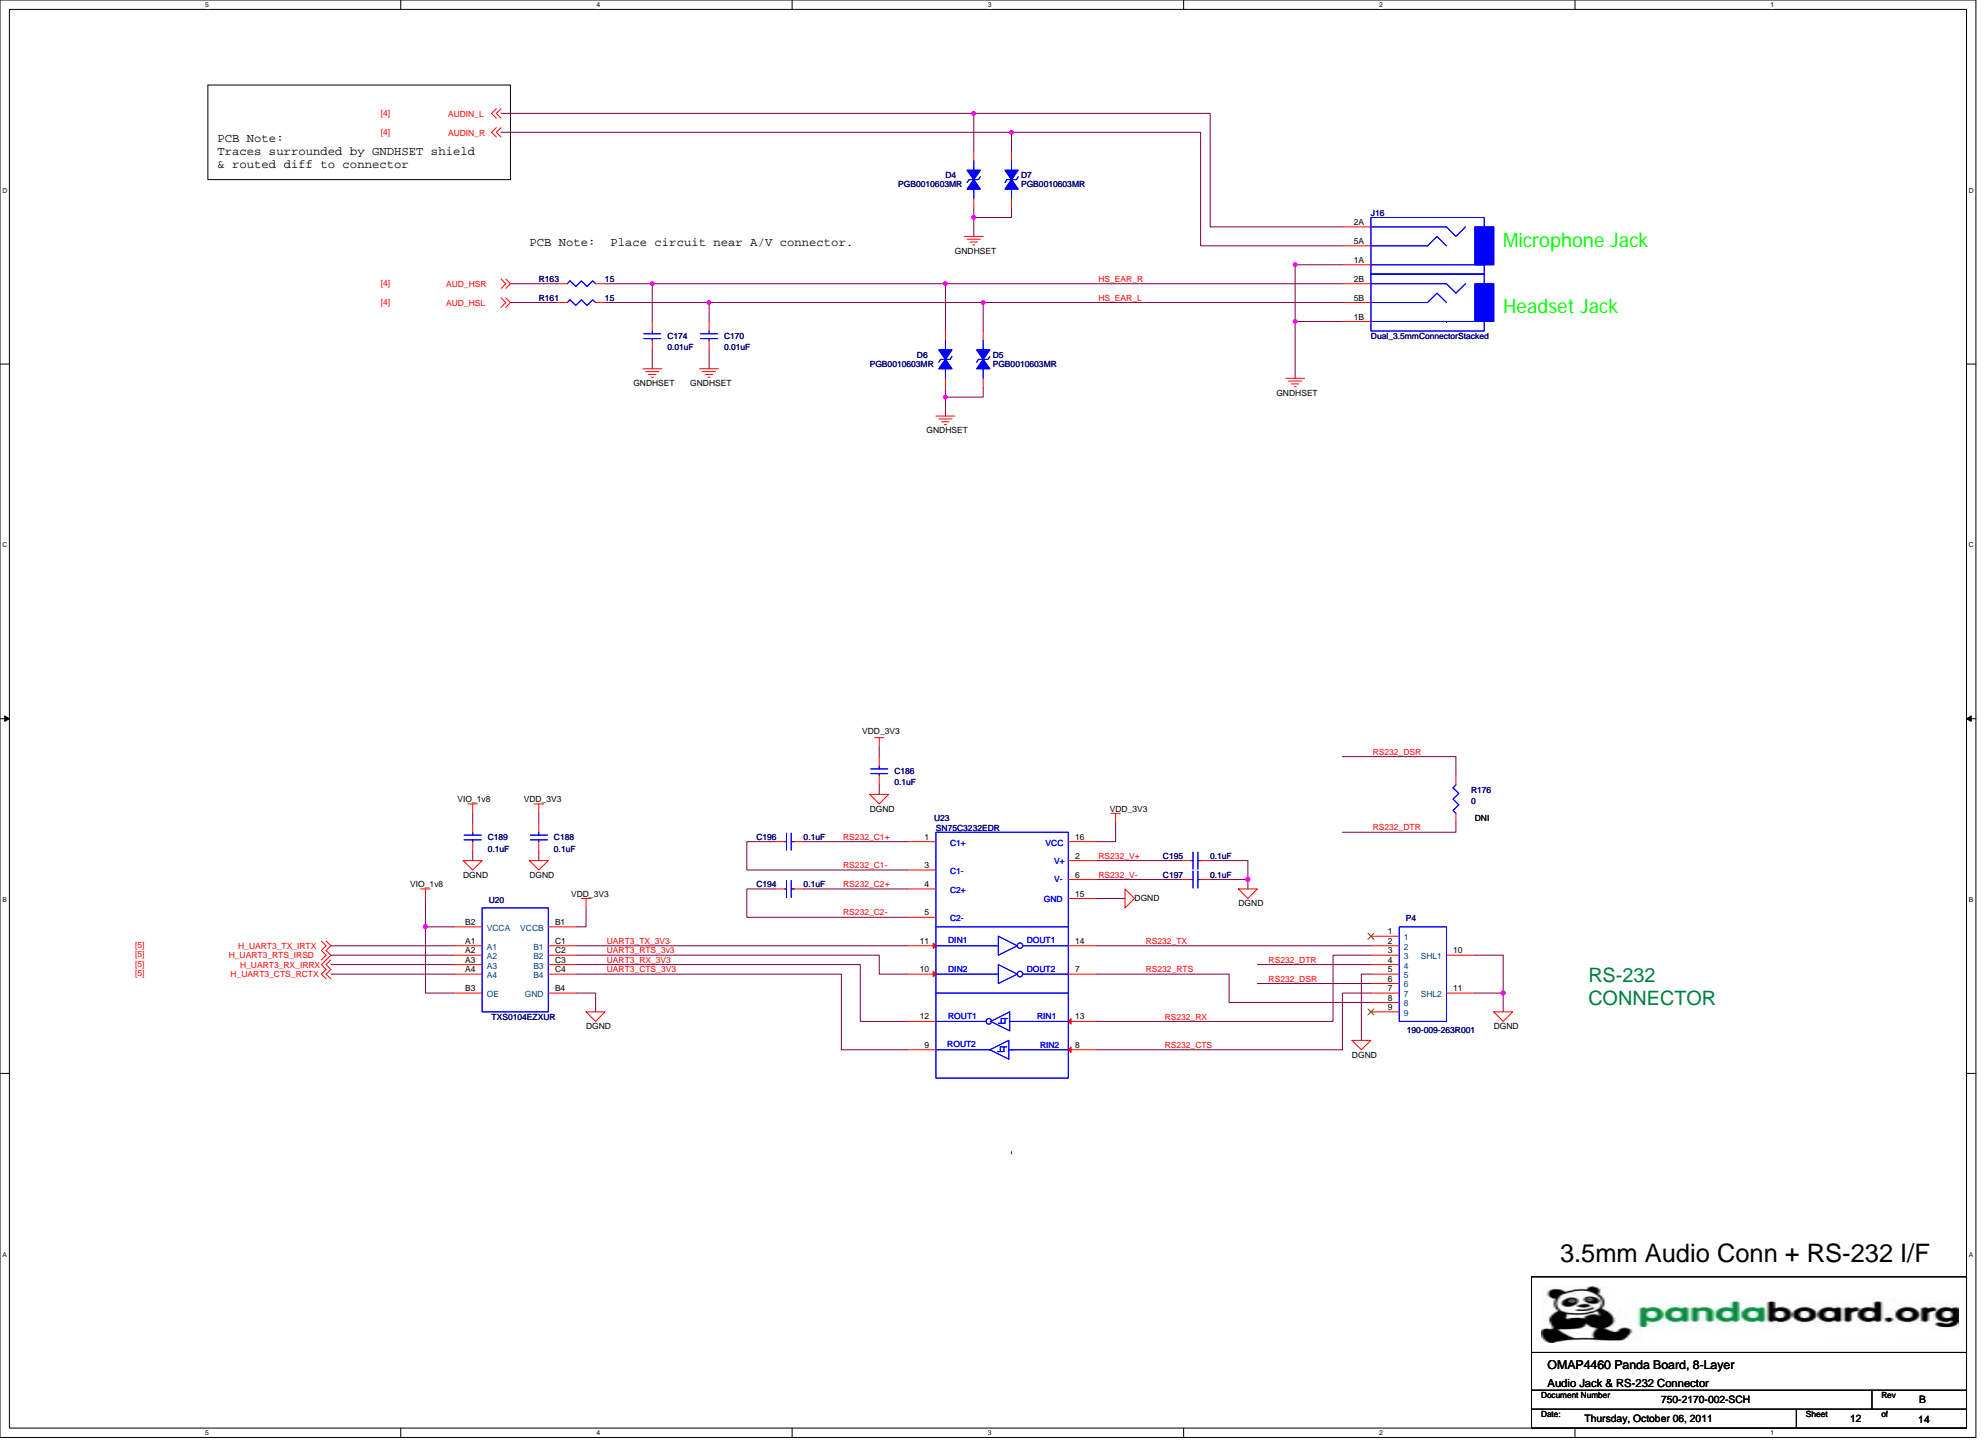
[picture p62: page 12]

& routed diff to connector

PCB Note: Place circuit near A/V connector.

OMAP4460 Panda Board, 8-Layer
Audio Jack & RS-232 Connector

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

Thursday, October 06, 2011 Thursday, October 06, 2011 Thursday, October 06, 2011 | 12 12 12 14 14 14

# LCD Expansion Connectors (Beagle Legacy)

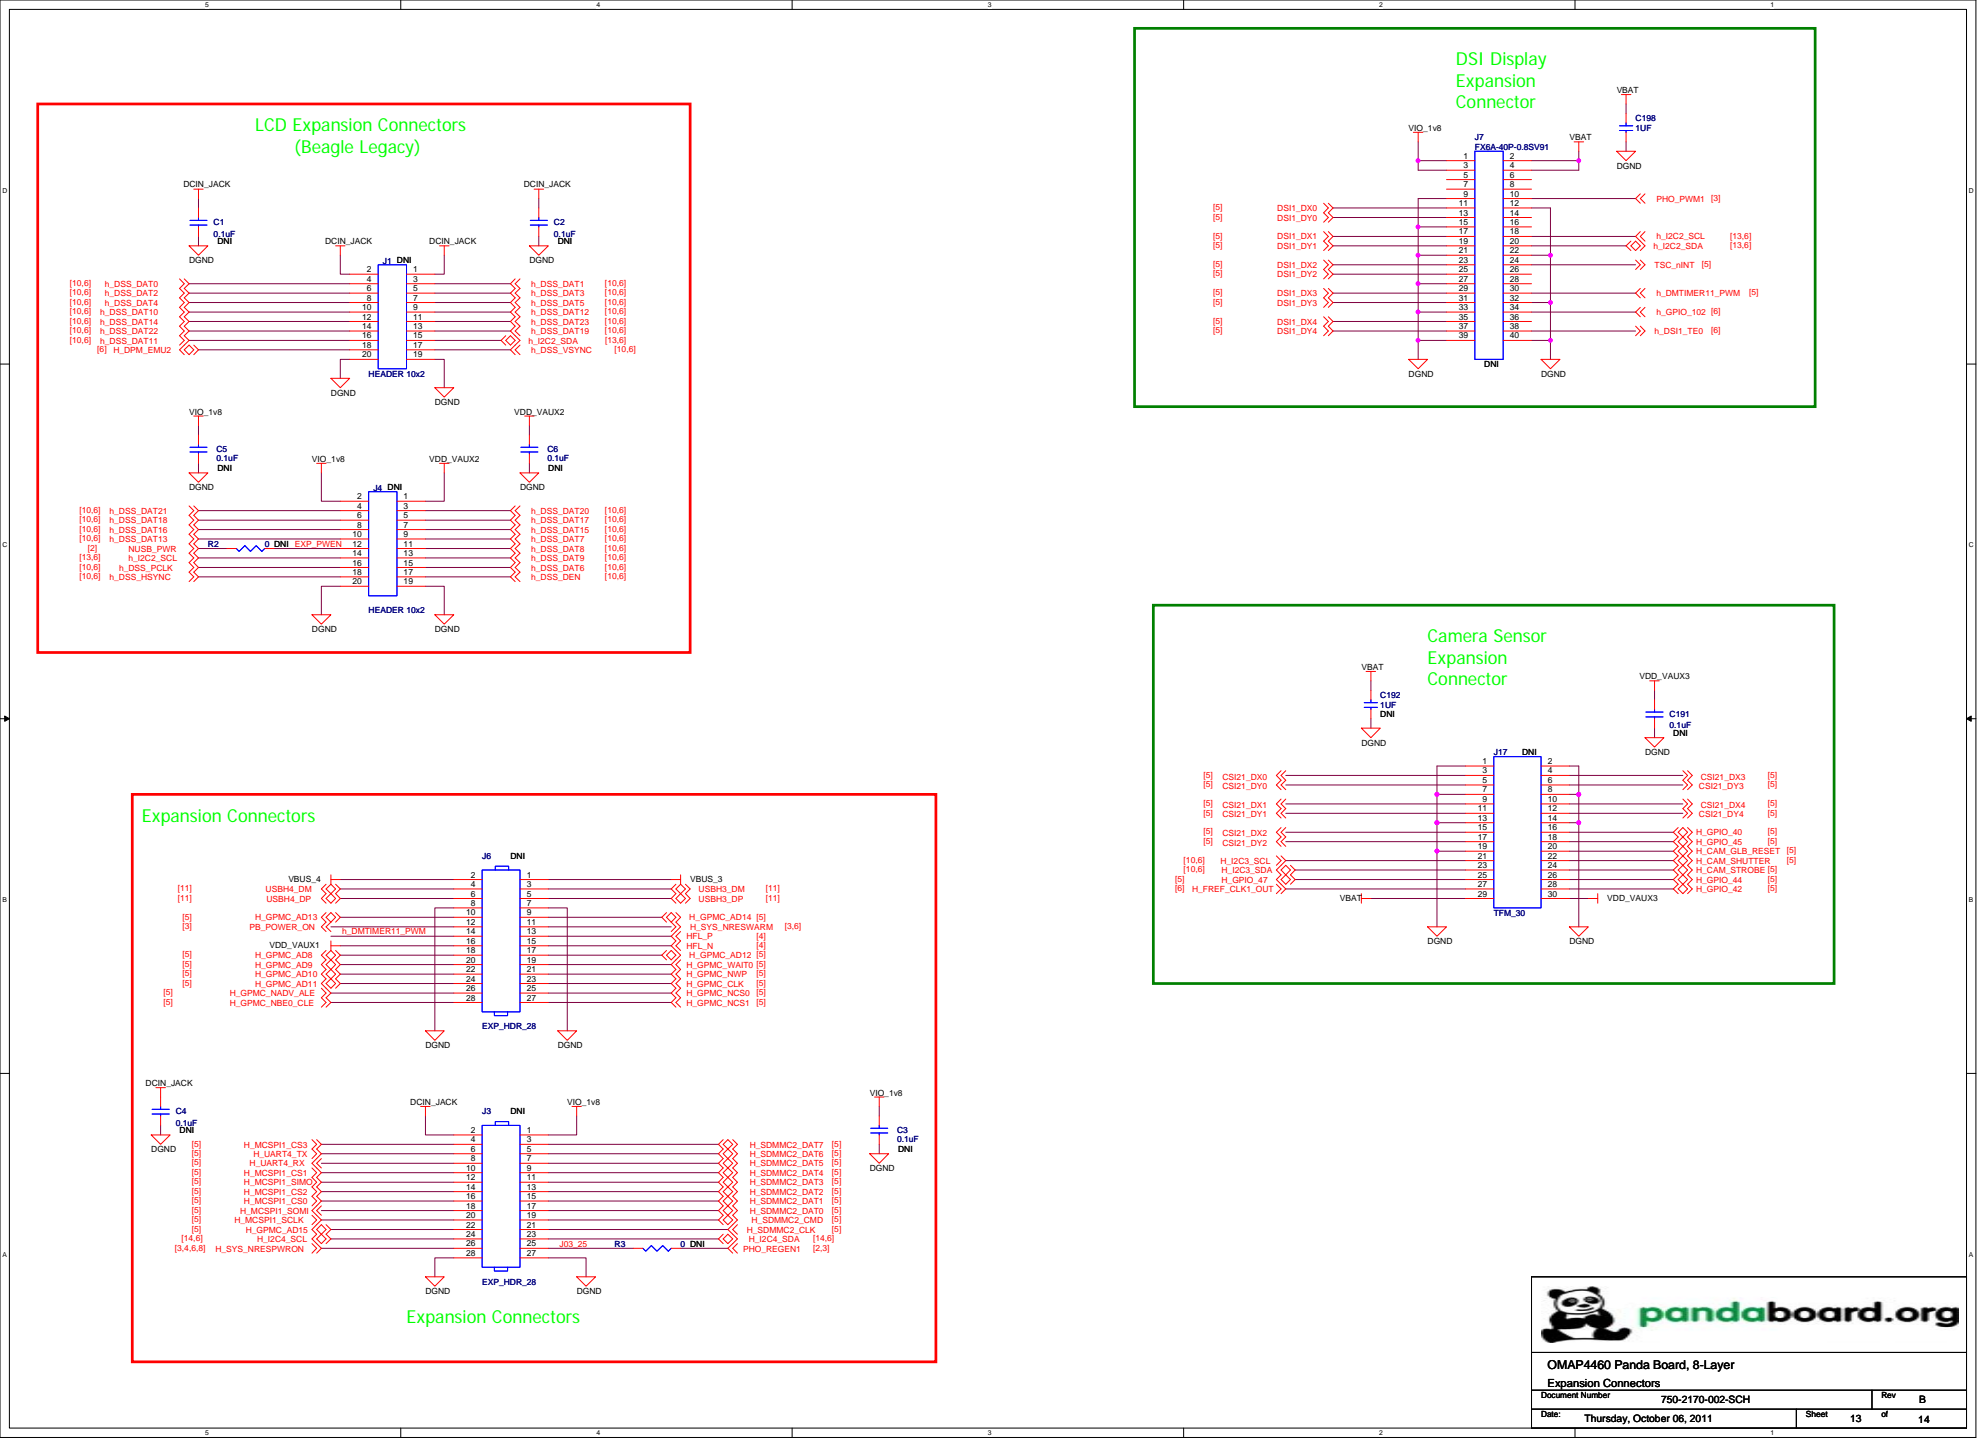
[picture p63: page 13]
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

Thursday, October 06, 2011 Thursday, October 06, 2011 Thursday, October 06, 2011 | 13 13 13 14 14 14

ECN-13455 - Changed C235 from 0.5pF capacitor to zero ohm resistor, and L2 from 5.1nH to 5.6nH inductor per results of RF performance testing.

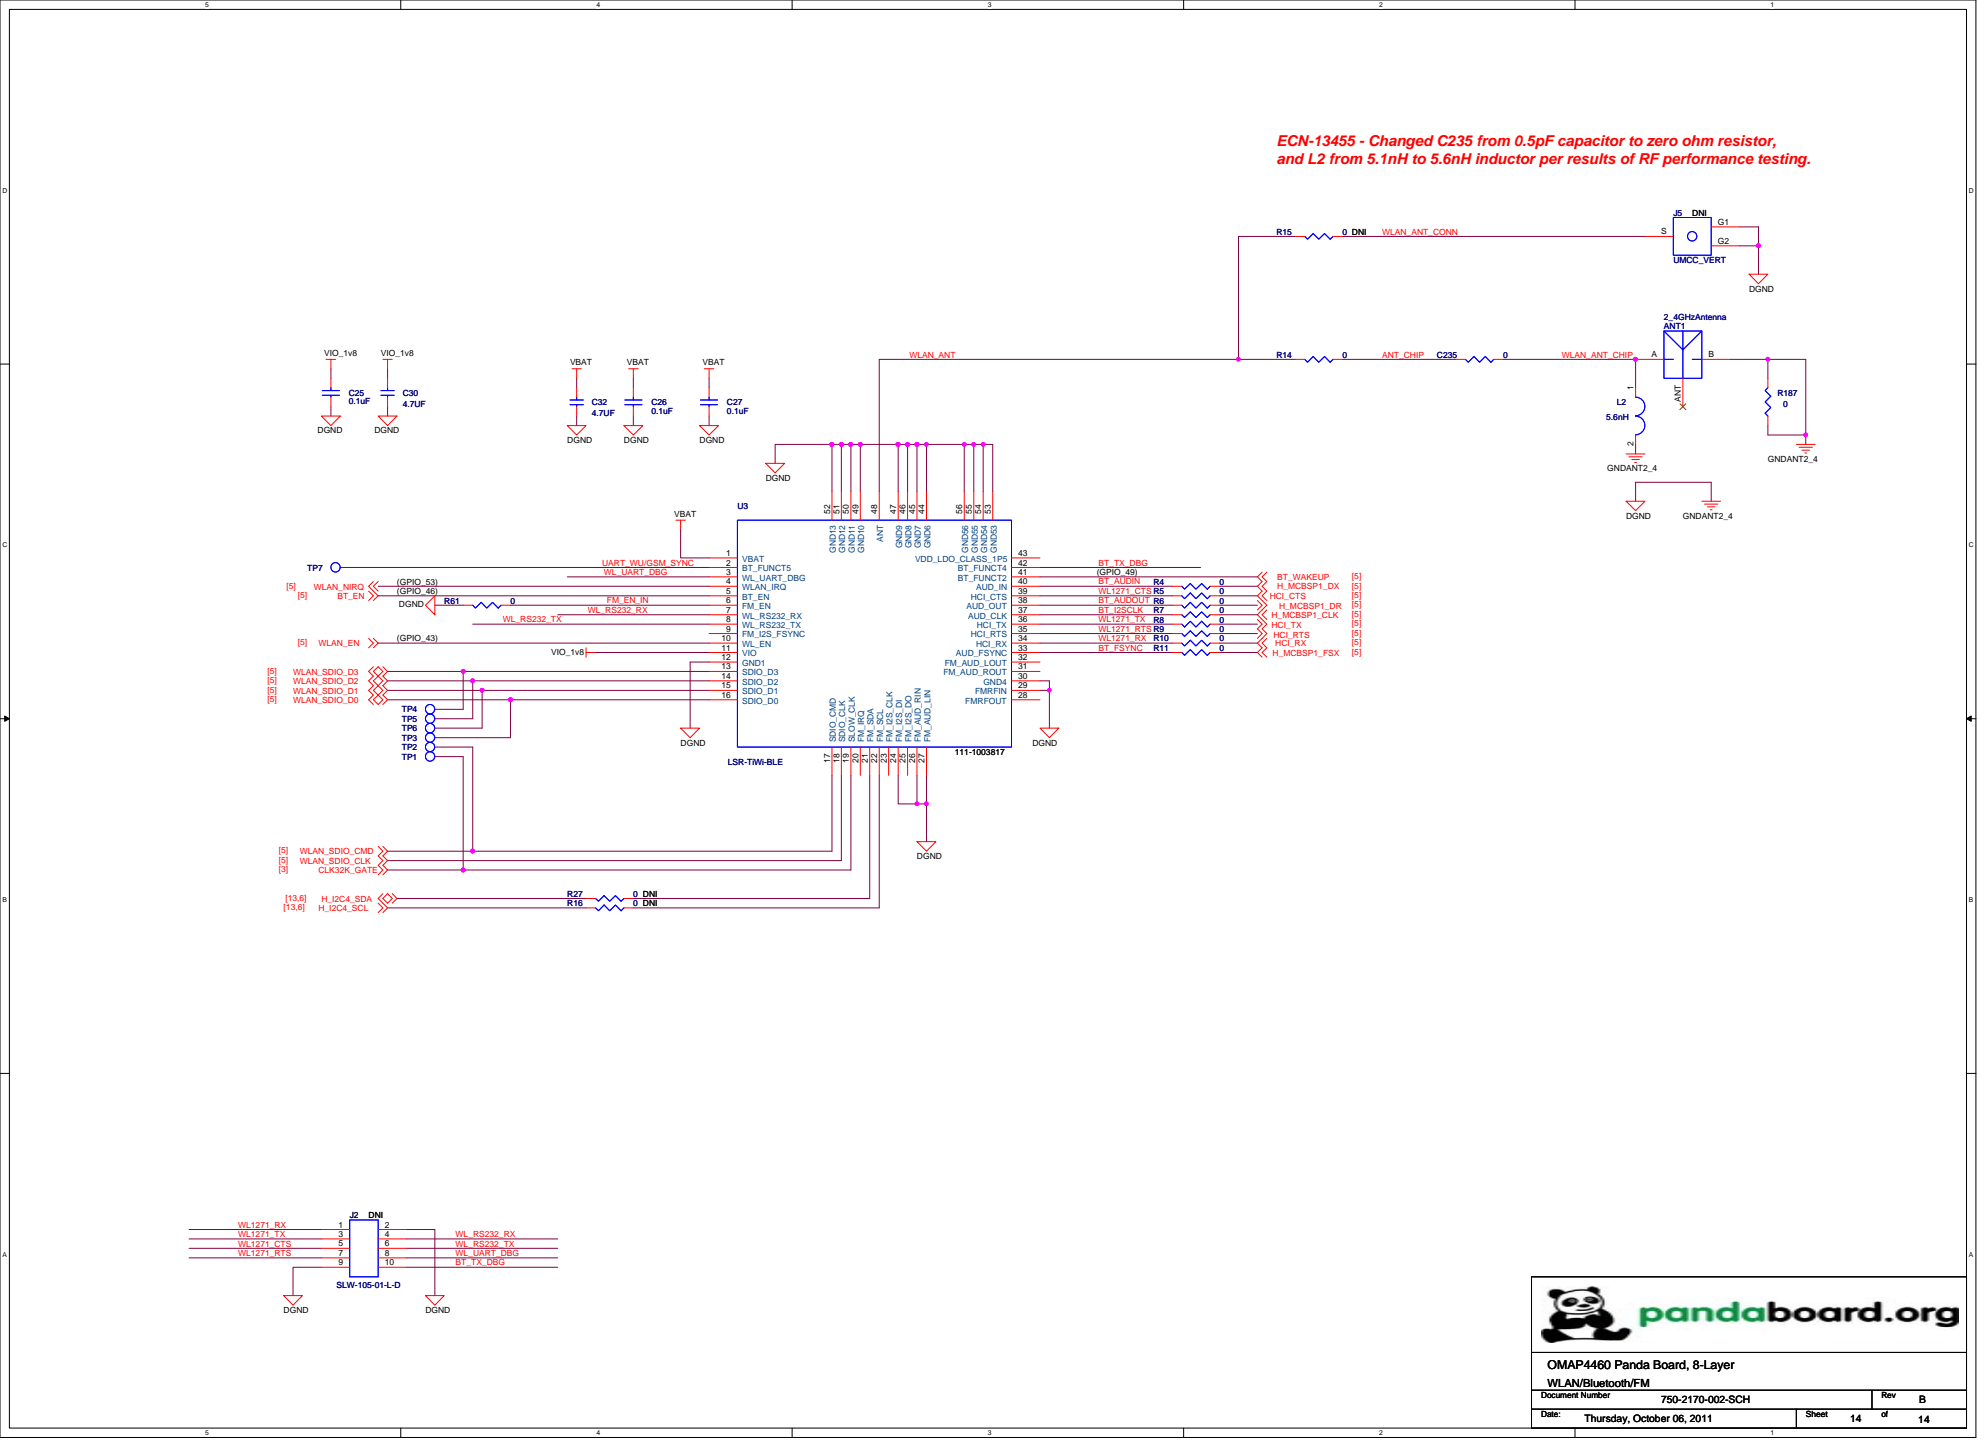
[picture p64: page 14]
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

Thursday, October 06, 2011 Thursday, October 06, 2011 Thursday, October 06, 2011 | 14 14 14
