RobertCNelson/pandaboard-docs/PandaboardA1/panda-a-allegro.pdf

## J2C106 C101 TP10 C27 1 P4⁹ ¹ ² ³ ⁴ ⁵ ⁶ ⁷ ⁸ C112 C34 C35 R4

### C194 C124 C42 TP5 J11 C125 C43 TP6 C4

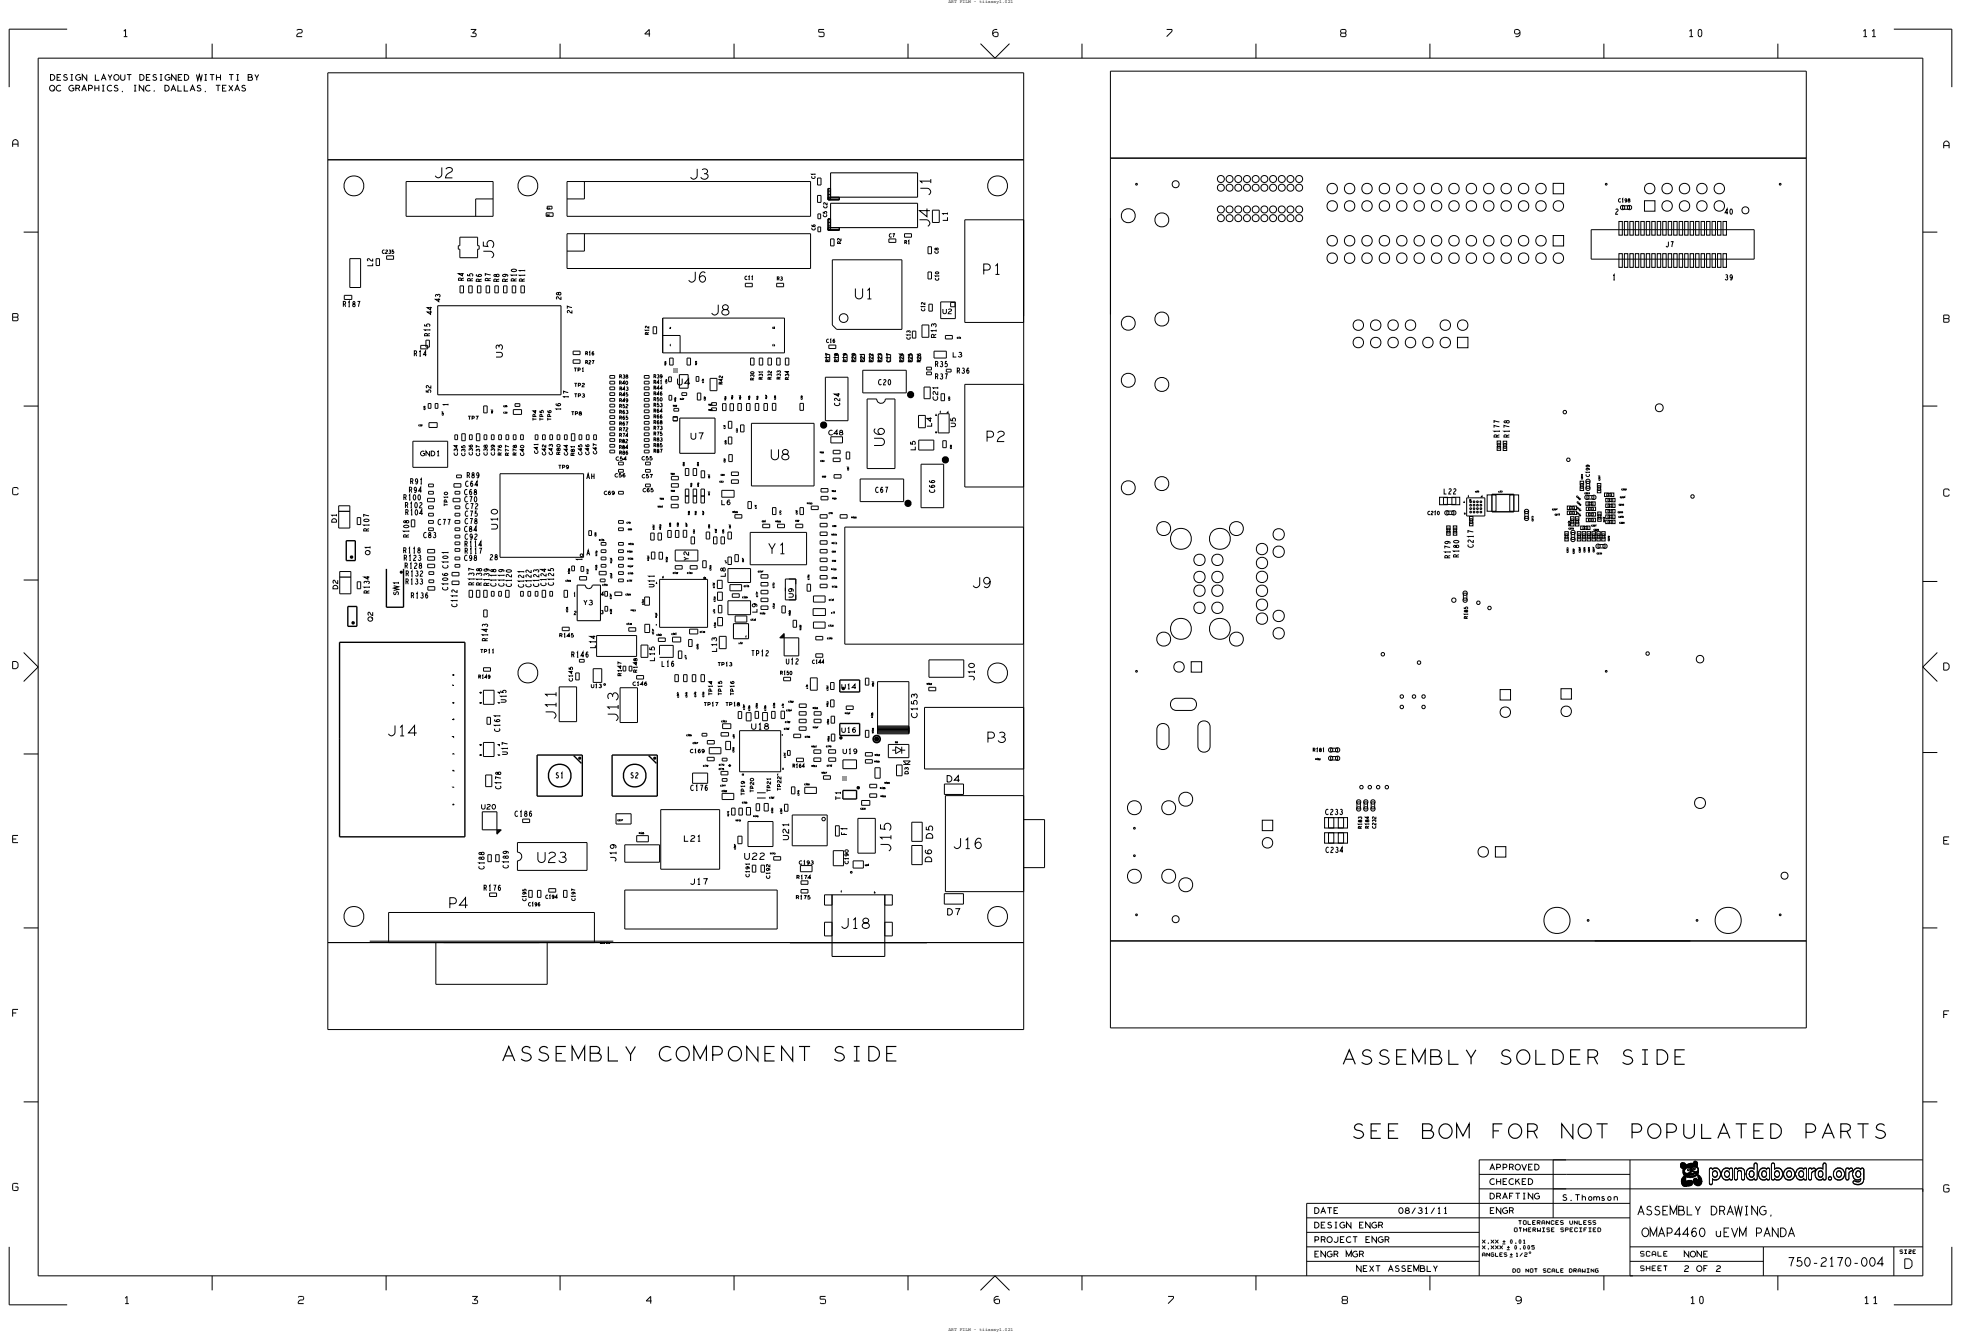
[picture p65: page 1]

QC GRAPHICS, INC. DALLAS, TEXAS

SEE BOM FOR NOT POPULATED PARTS R183 R184 C232

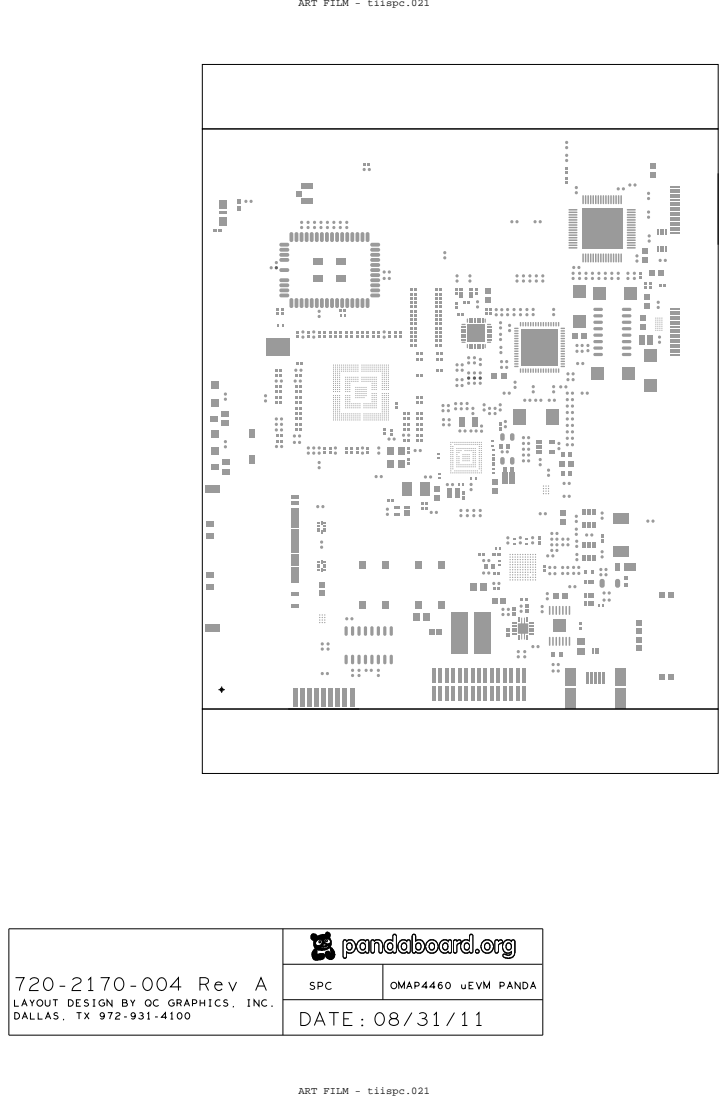
[picture p66: page 2]
DATE:; SPC; OMAP4460 uEVM PANDA

ART FILM - tiispc.021

720-2170-004 Rev A
LAYOUT DESIGN BY QC GRAPHICS, INC.
DALLAS, TX 972-931-4100

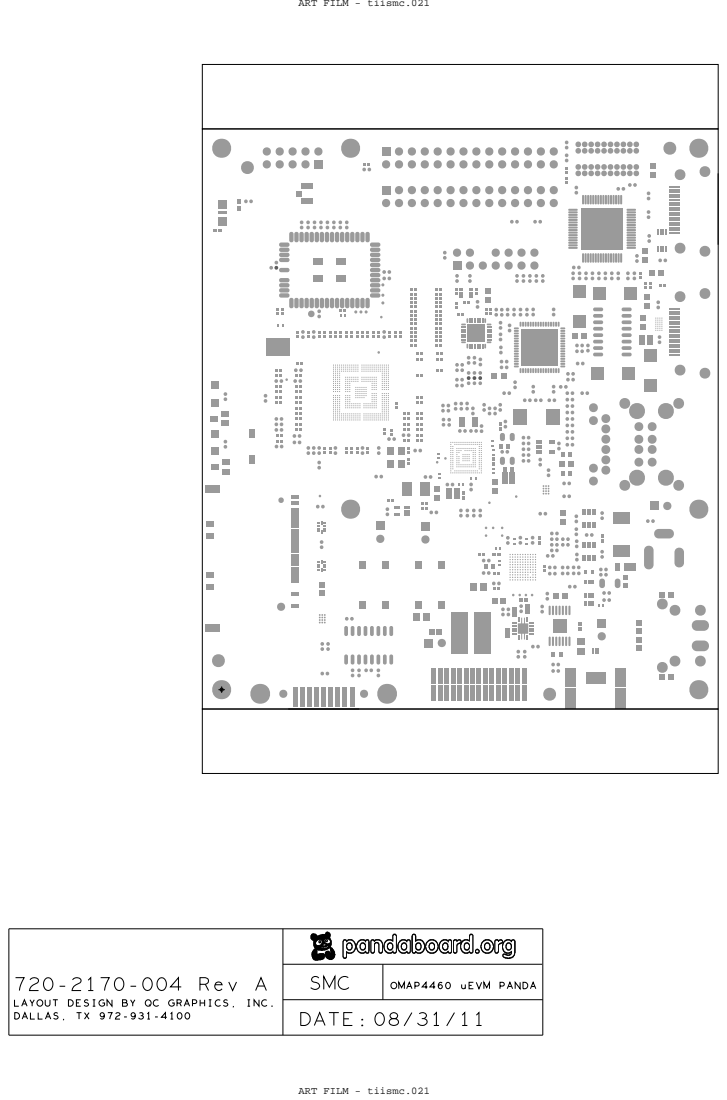
[picture p67: page 3]
SMC; OMAP4460 uEVM PANDA

ART FILM - tiismc.021

720-2170-004 Rev A
LAYOUT DESIGN BY QC GRAPHICS, INC.

## LCD CONNECTOR A J15 R169

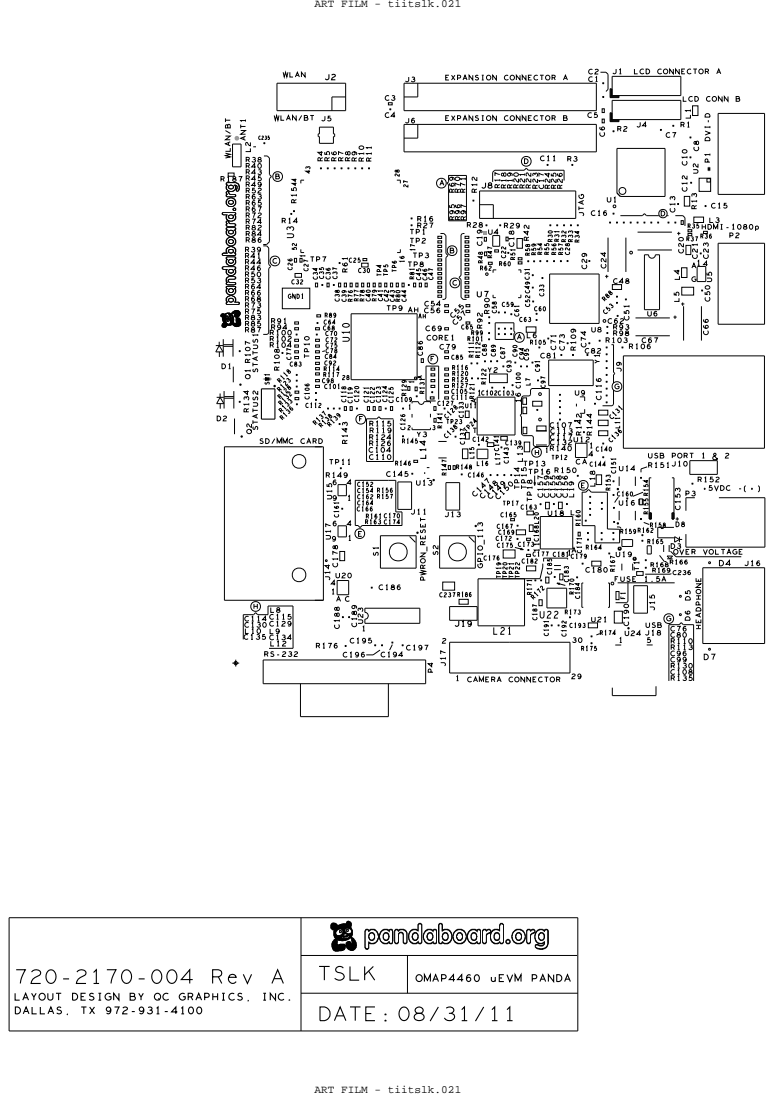
[picture p68: page 4]

720-2170-004 Rev A
LAYOUT DESIGN BY QC GRAPHICS, INC.

# 720-2170-004 Rev A D2 D1 R187 Q2 R134 Q1 R107 L2

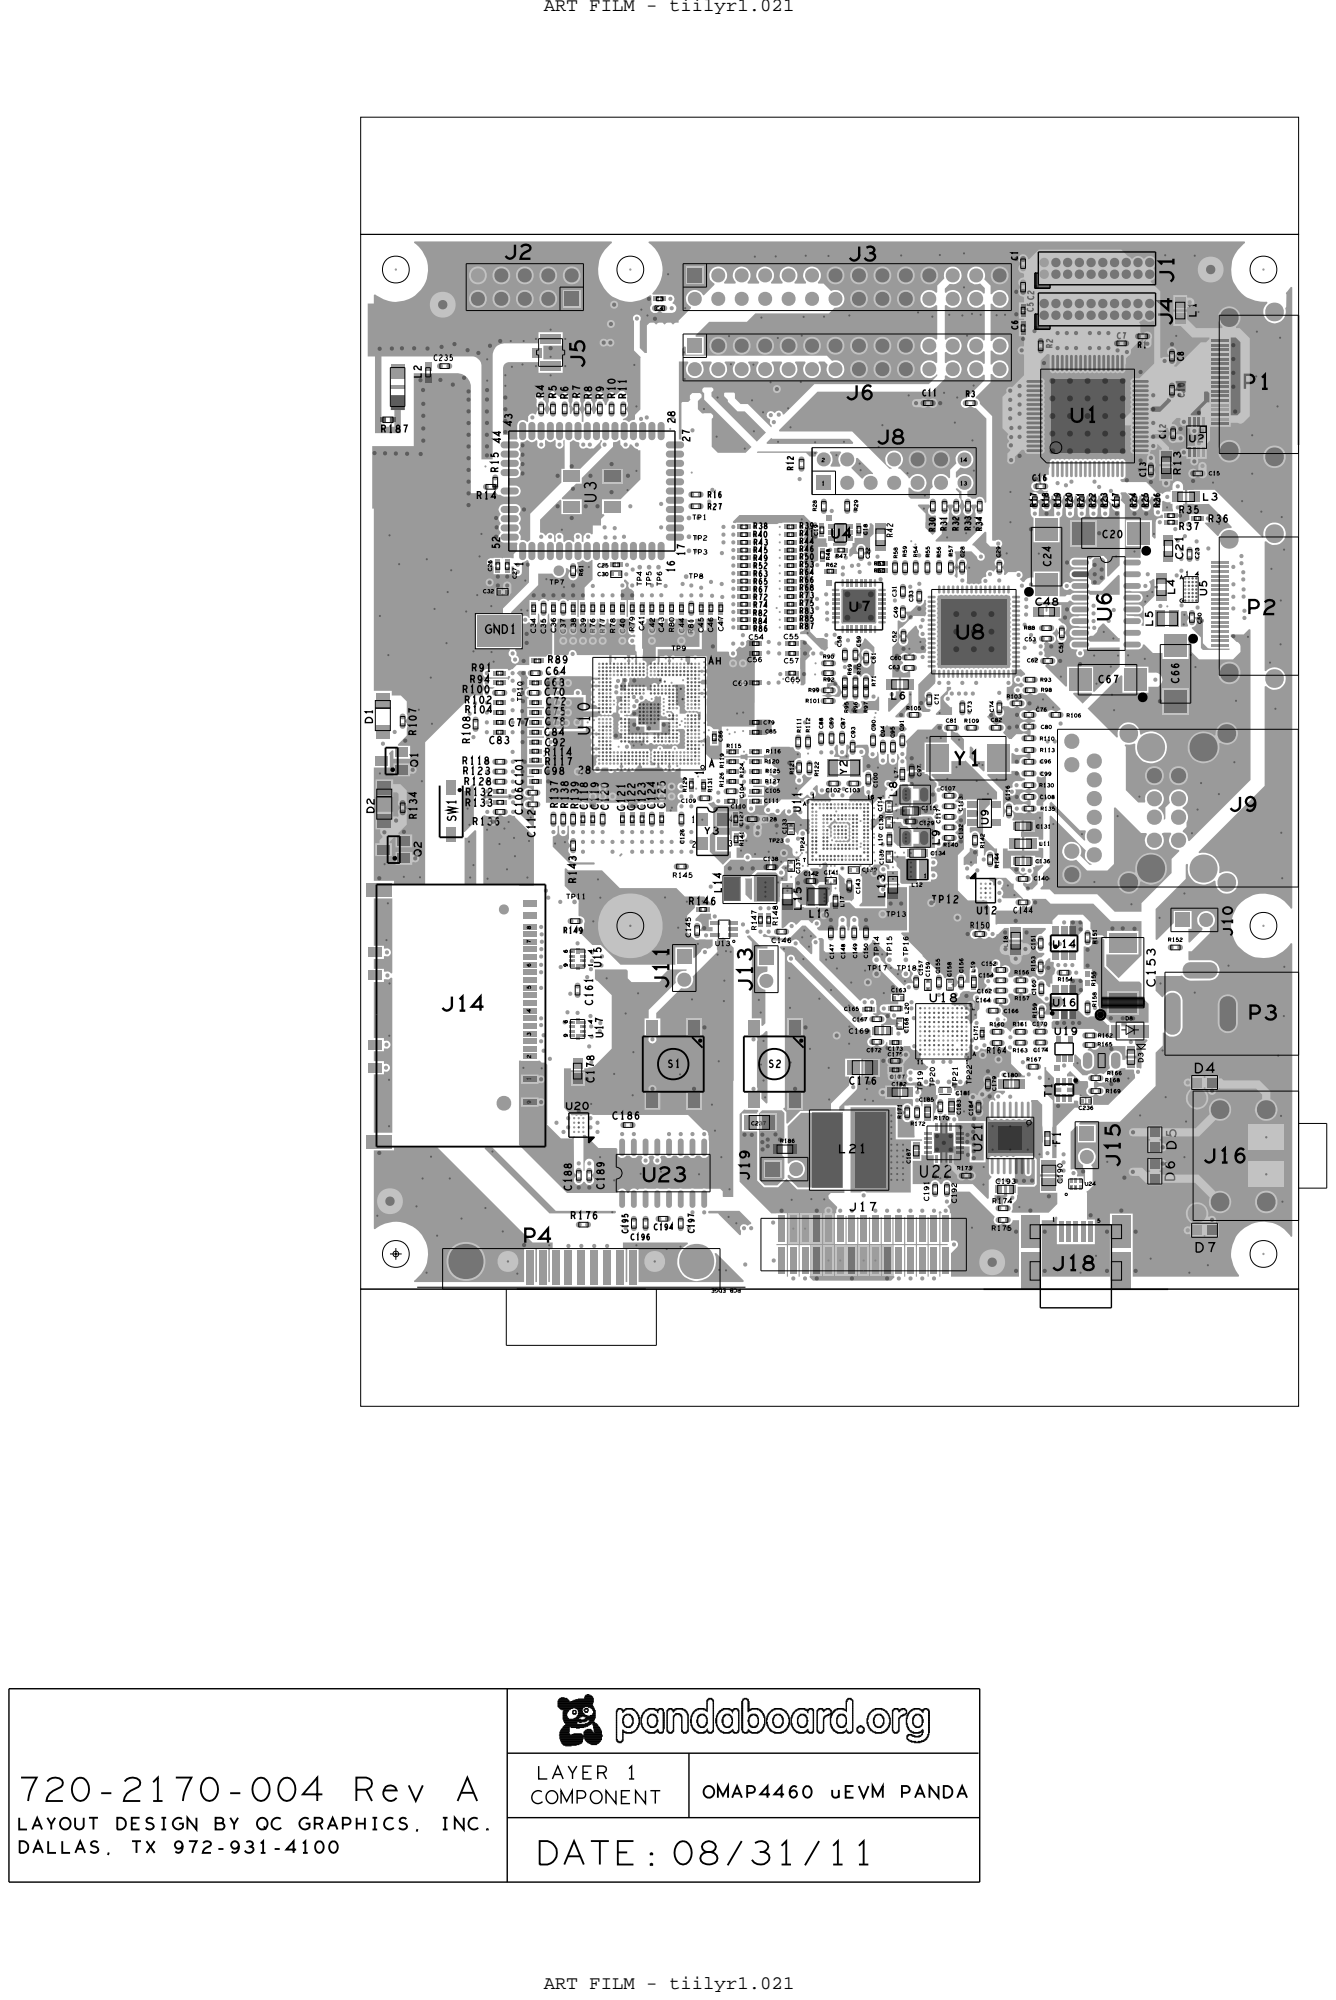
[picture p69: page 5]

LAYOUT DESIGN BY QC GRAPHICS, INC.

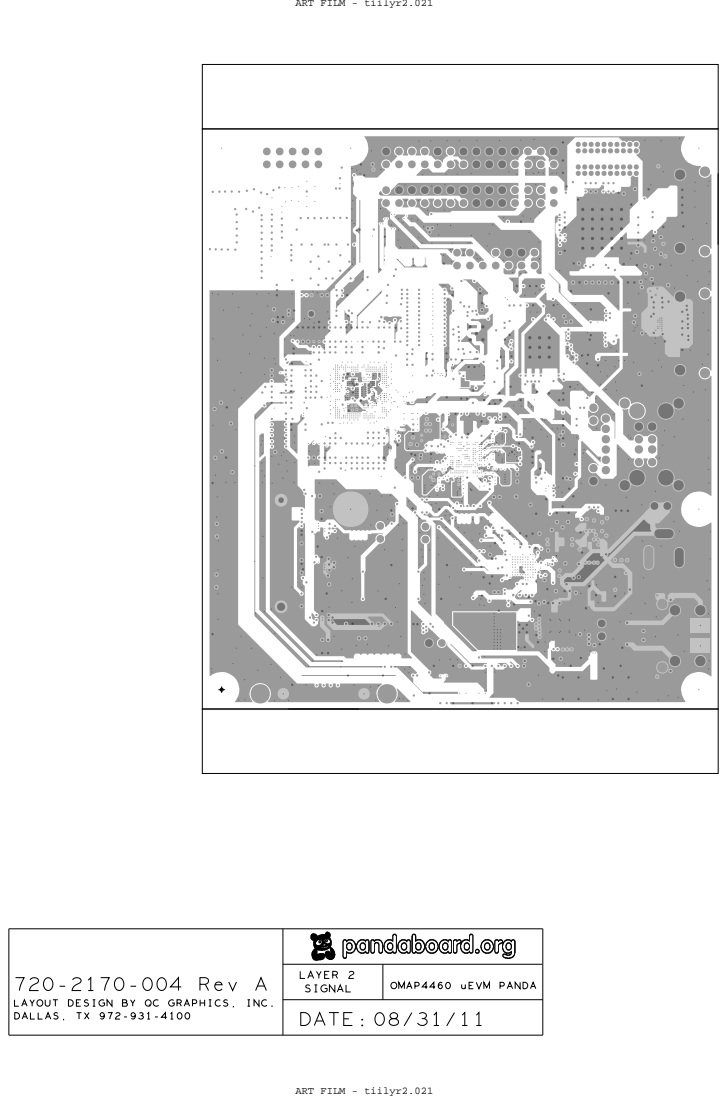
[picture p70: page 6]
LAYER 2 SIGNAL; OMAP4460 uEVM PANDA; ART FILM - tiilyr2.021

720-2170-004 Rev A
LAYOUT DESIGN BY QC GRAPHICS, INC.

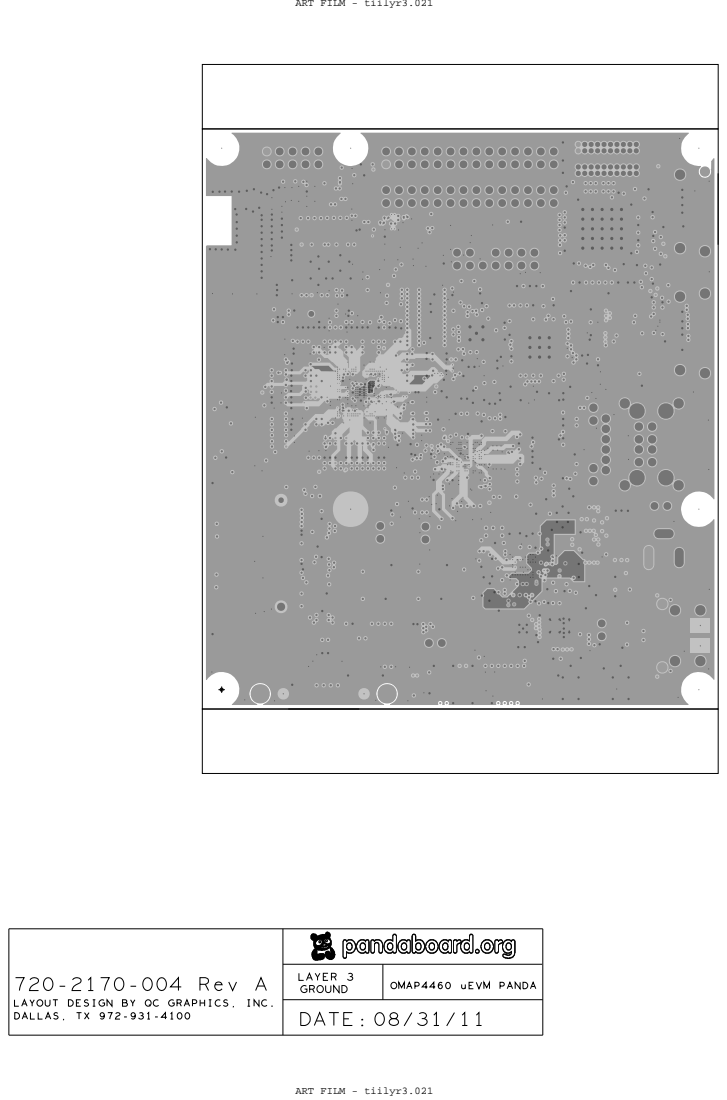
[picture p71: page 7]
GROUND; LAYER 3; OMAP4460 uEVM PANDA; ART FILM - tiilyr3.021

720-2170-004 Rev A
LAYOUT DESIGN BY QC GRAPHICS, INC.

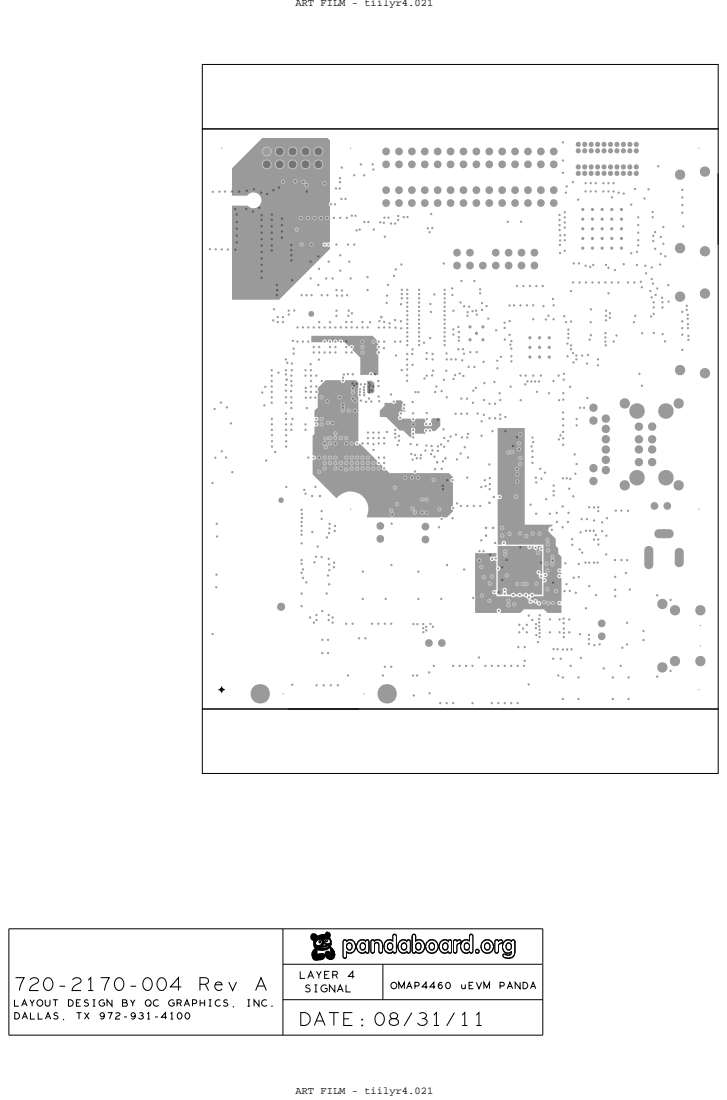
[picture p72: page 8]
LAYER 4 SIGNAL; OMAP4460 uEVM PANDA; ART FILM - tiilyr4.021

720-2170-004 Rev A
LAYOUT DESIGN BY QC GRAPHICS, INC.

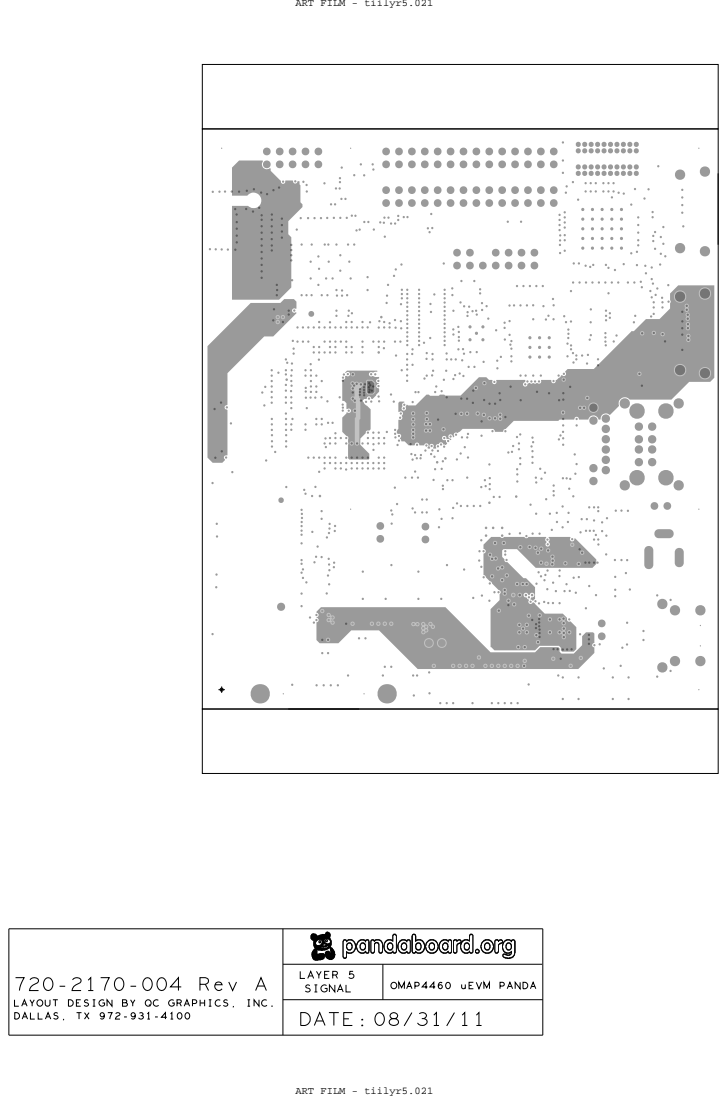
[picture p73: page 9]
LAYER 5 SIGNAL; OMAP4460 uEVM PANDA; ART FILM - tiilyr5.021

720-2170-004 Rev A
LAYOUT DESIGN BY QC GRAPHICS, INC.

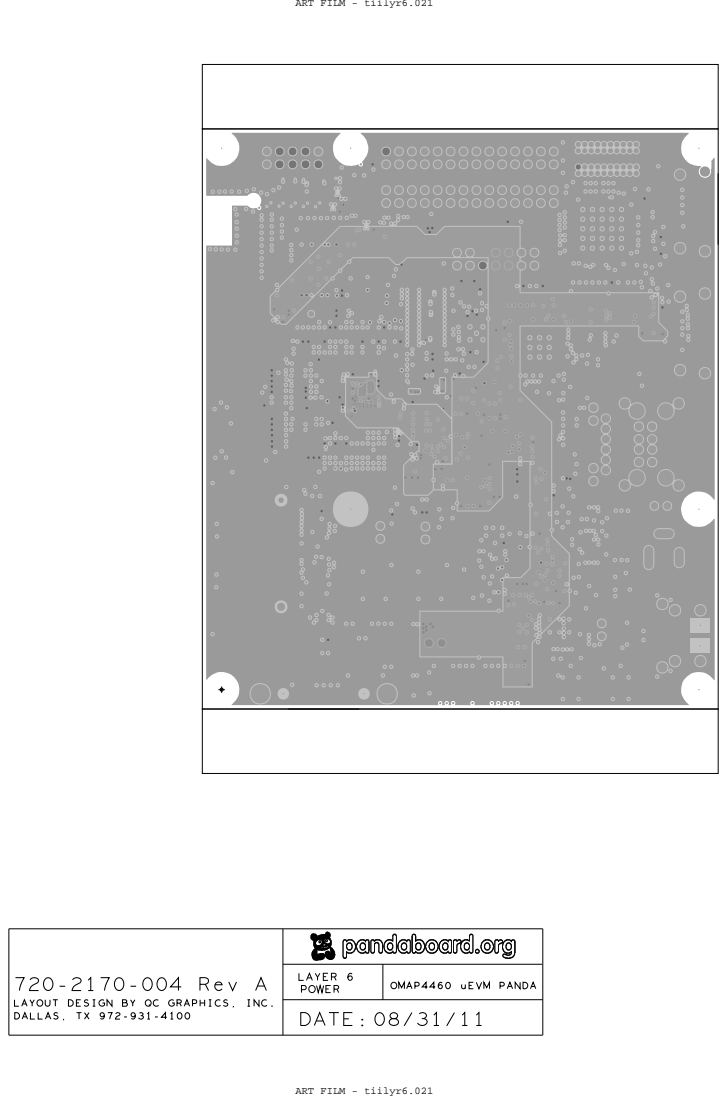
[picture p74: page 10]
POWER; LAYER 6; OMAP4460 uEVM PANDA; ART FILM - tiilyr6.021

720-2170-004 Rev A
LAYOUT DESIGN BY QC GRAPHICS, INC.

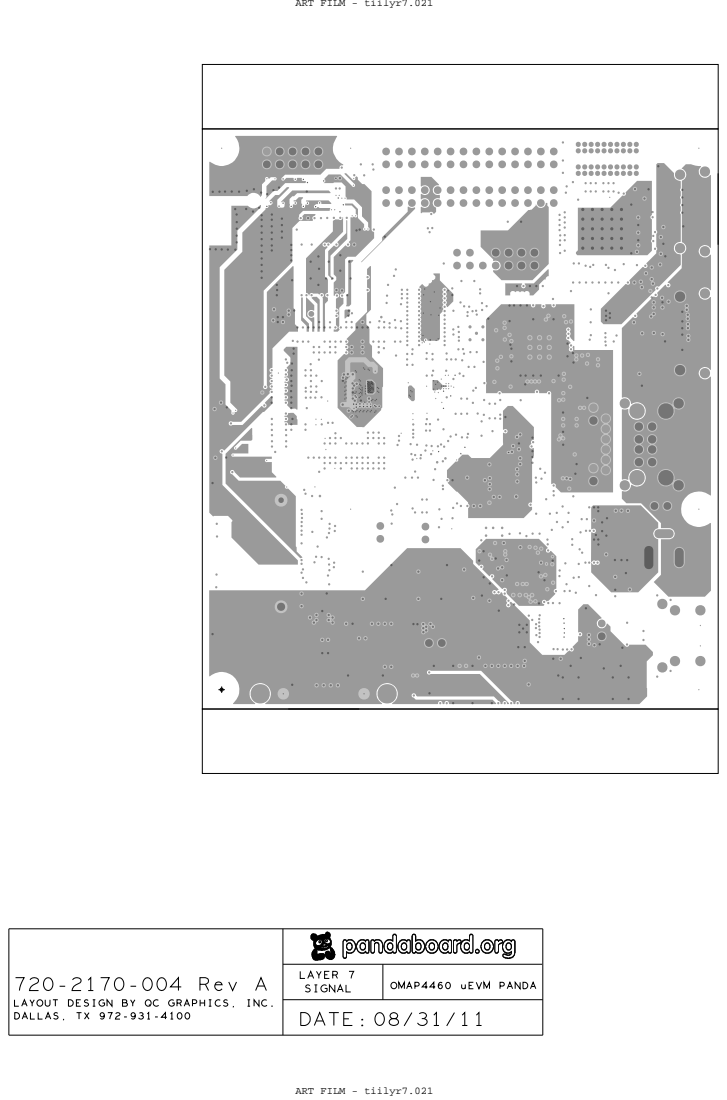
[picture p75: page 11]
LAYER 7 SIGNAL; OMAP4460 uEVM PANDA; ART FILM - tiilyr7.021

720-2170-004 Rev A
LAYOUT DESIGN BY QC GRAPHICS, INC.

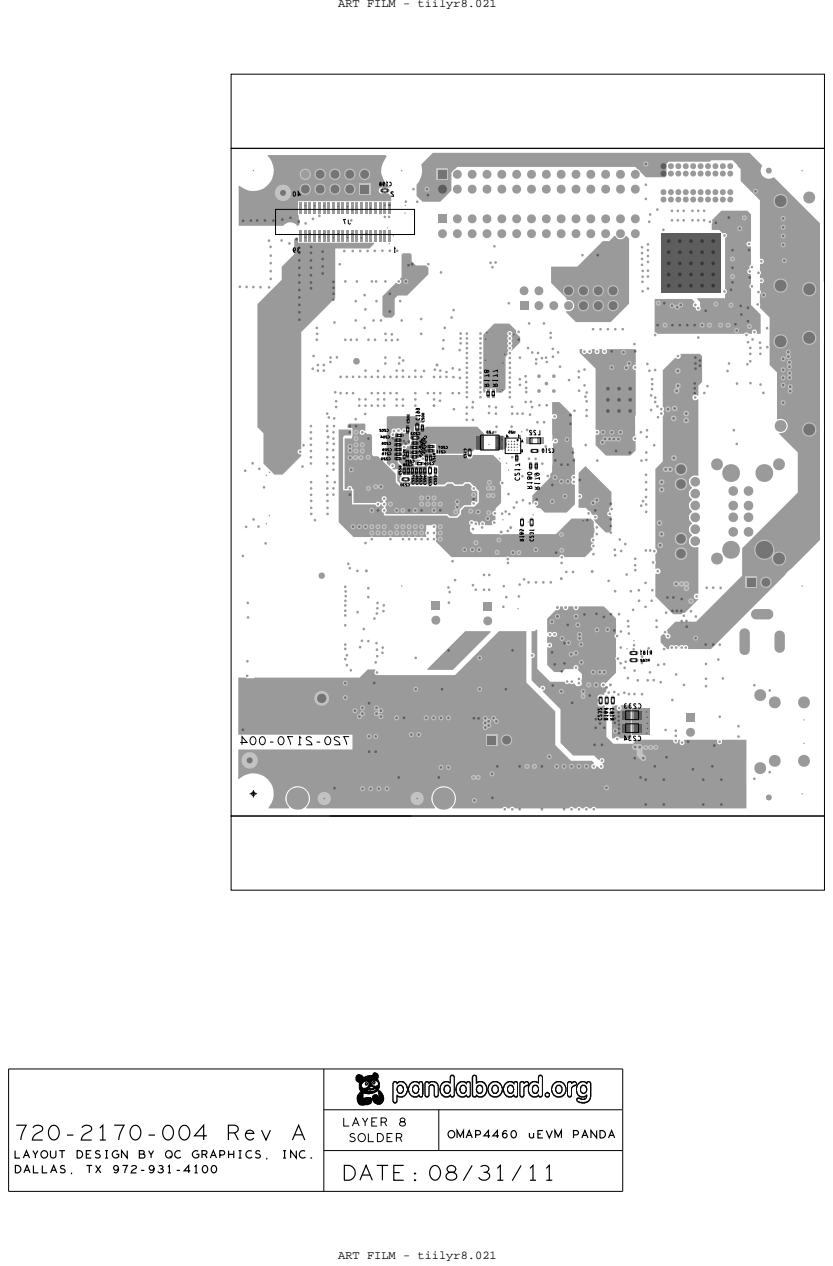
[picture p76: page 12]

720-2170-004 Rev A
LAYOUT DESIGN BY QC GRAPHICS, INC.

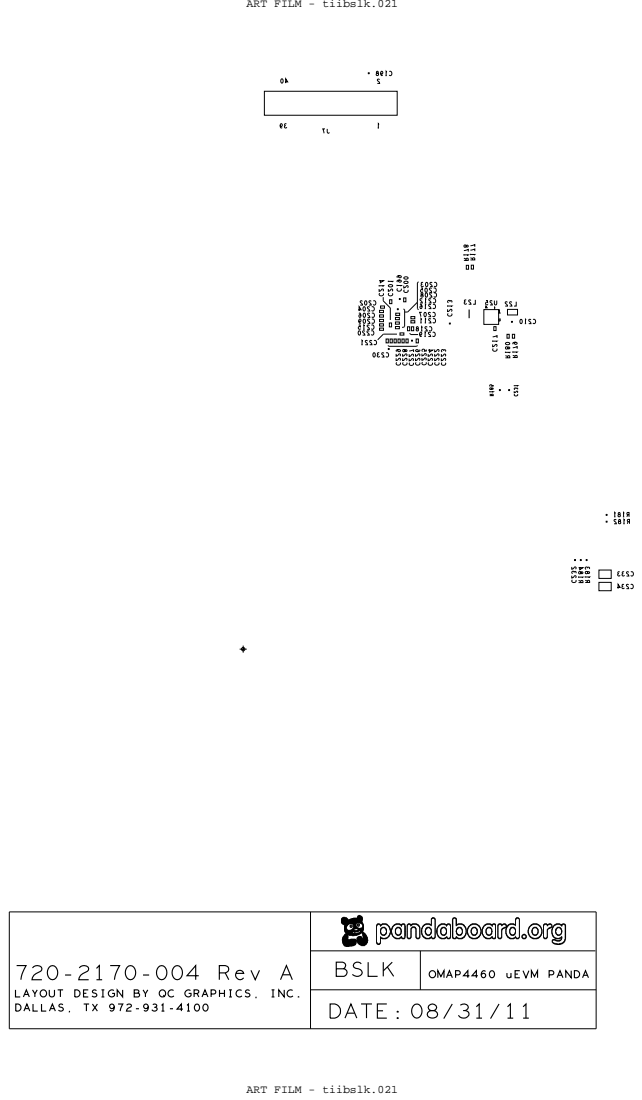
[picture p77: page 13]

BSLK | OMAP4460 uEVM PANDA
DATE:

720-2170-004 Rev A LAYOUT DESIGN BY QC GRAPHICS, INC. DALLAS, TX 972-931-4100

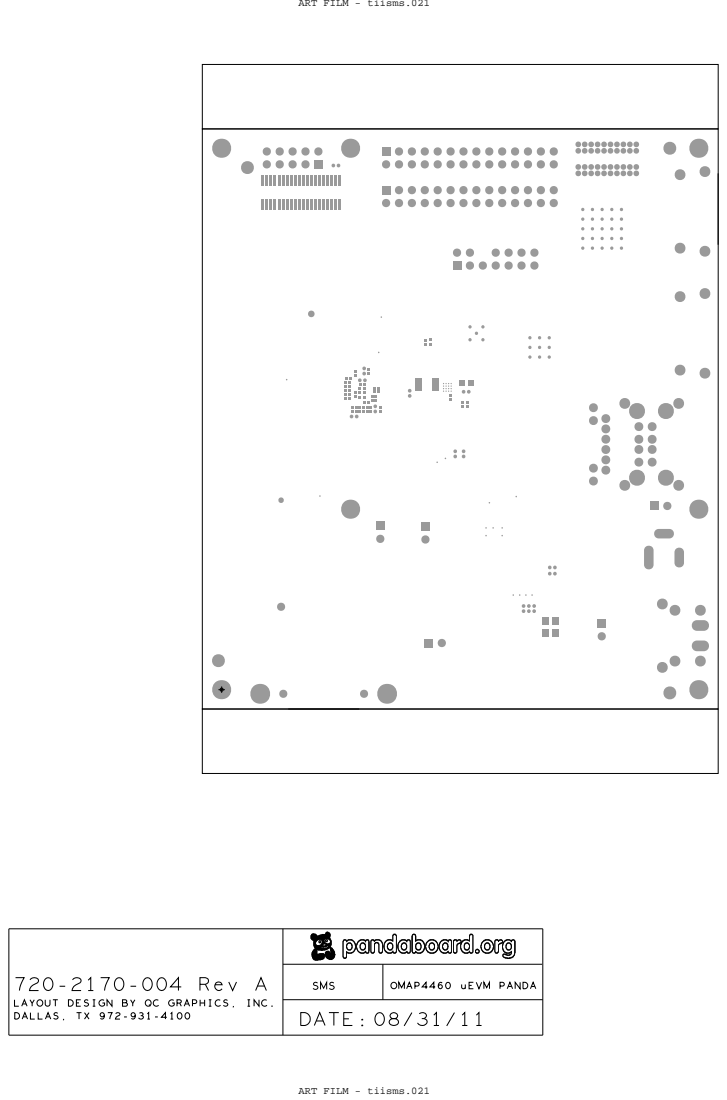
[picture p78: page 14]
SMS; OMAP4460 uEVM PANDA

ART FILM - tiisms.021

720-2170-004 Rev A
LAYOUT DESIGN BY QC GRAPHICS, INC.

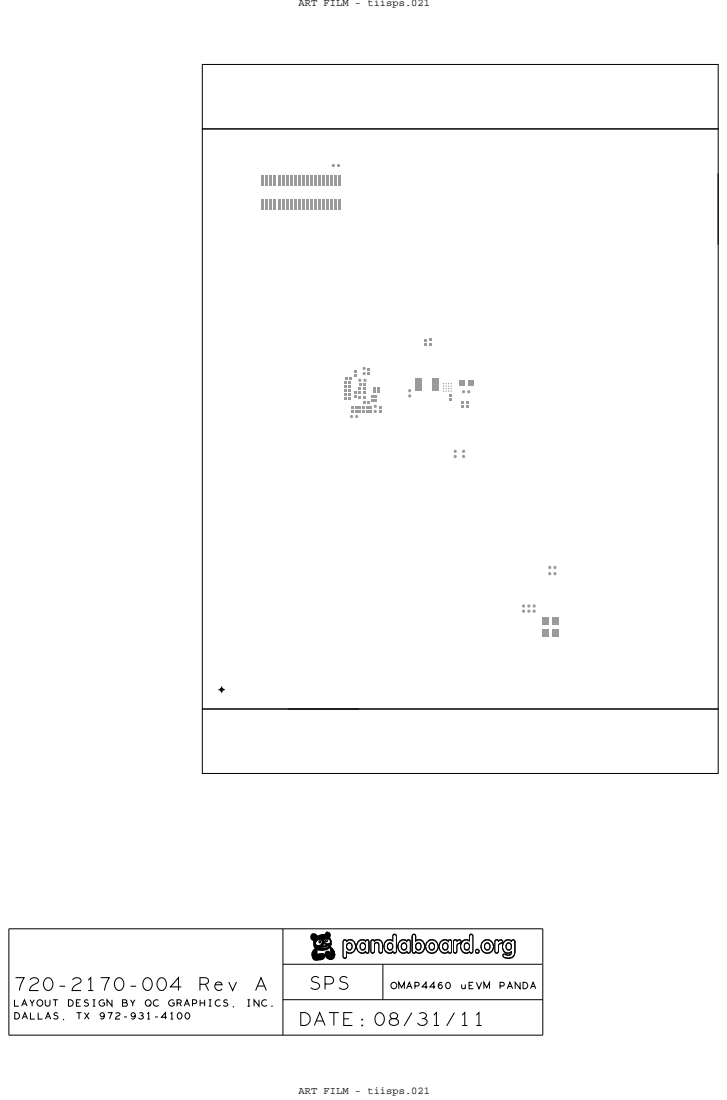
[picture p79: page 15]
SPS; OMAP4460 uEVM PANDA

ART FILM - tiisps.021

720-2170-004 Rev A
LAYOUT DESIGN BY QC GRAPHICS, INC.

### QTY5.500

A-A

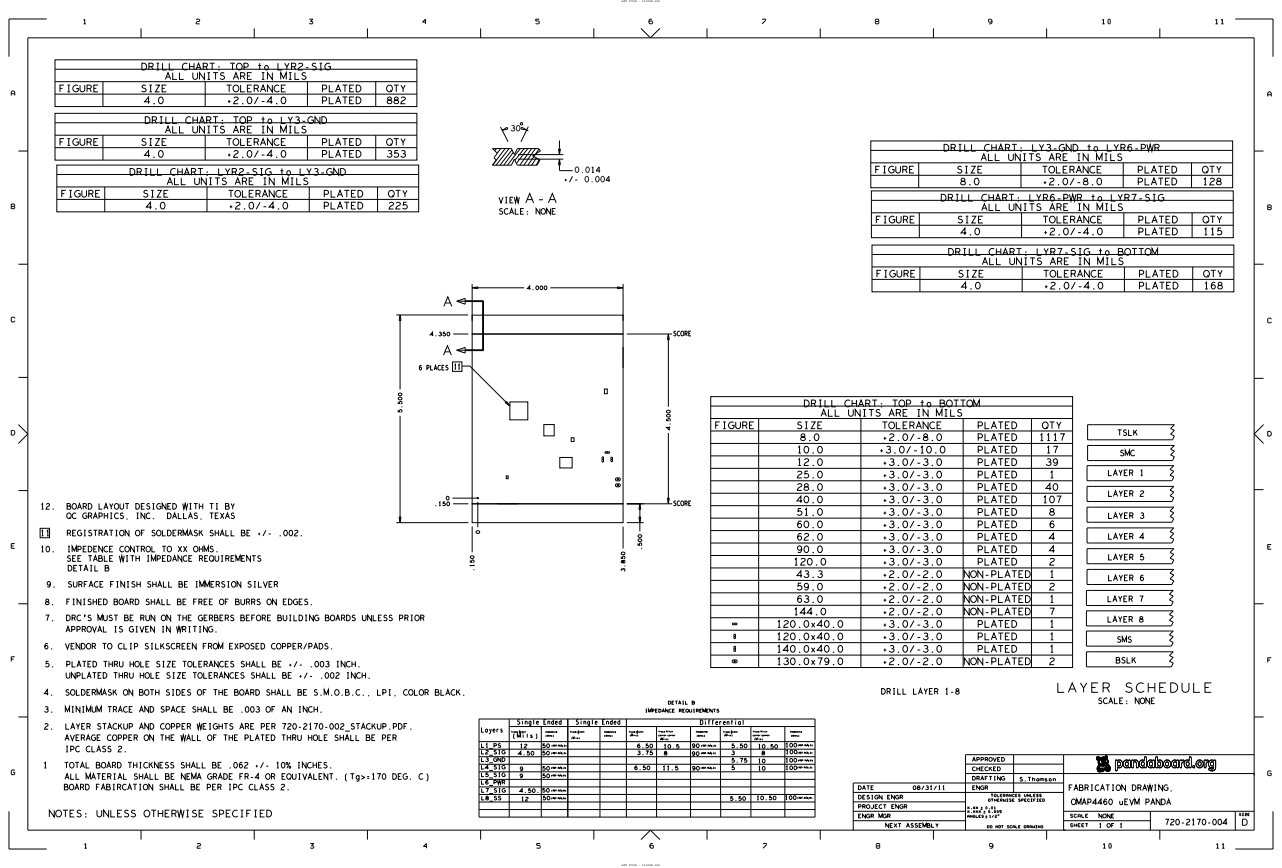
[picture p80: page 16]
1 TOTAL BOARD THICKNESS SHALL BE .062; INCHES.; 3. MINIMUM TRACE AND SPACE SHALL BE .003 OF AN; INCH.; 4. SOLDERMASK ON BOTH SIDES OF; THE BOARD SHALL BE S.M.O.B.C., LPI, COLOR BLACK.; 10. IMPEDENCE CONTROL; TO XX OHMS.; 11 REGISTRATION OF SOLDERMASK SHALL BE; 12. BOARD LAYOUT DESIGNED WITH; 5. PLATED THRU; HOLE SIZE; TOLERANCES SHALL BE; 7. DRC'S MUST BE RUN ON; THE GERBERS BEFORE BUILDING BOARDS UNLESS PRIOR; 9. SURFACE FINISH SHALL BE; IMMERSION SILVER; FIGURE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

ART FILM - tiifab.021

DRILL CHART: TOP to LYR2-SIG
ALL UNITS ARE IN MILS
SIZE
DRILL CHART: TOP to LY3-GND
DRILL CHART: LYR2-SIG to LY3-GND

DRILL CHART: LY3-GND to LYR6-PWR
DRILL CHART: LYR6-PWR to LYR7-SIG
DRILL CHART: LYR7-SIG to BOTTOM

SEE TABLE WITH IMPEDANCE REQUIREMENTS
DETAIL B
8. FINISHED BOARD SHALL BE FREE OF BURRS ON EDGES.
APPROVAL IS GIVEN IN WRITING.
6. VENDOR TO CLIP SILKSCREEN FROM EXPOSED COPPER/PADS.
2. LAYER STACKUP AND COPPER WEIGHTS ARE PER 720-2170-002_STACKUP.PDF.
IPC CLASS 2.

ALL MATERIAL SHALL BE NEMA GRADE FR-4 OR EQUIVALENT. (Tg>=170 DEG. C)
NOTES: UNLESS OTHERWISE SPECIFIED
