RobertCNelson/pandaboard-docs/(list of files, drawings)

Other design files:
PandaboardA1/panda-a-orcad.dsn
PandaboardES-B1/panda-es-b-orcard.dsn
