RobertCNelson/pandaboard-docs/(commit log)

2018-08-28 Added the various A1 docs I have.
    [panda-a-bom.xls, panda-a-orcad.dsn]
2018-08-28 added various pandaboardes-b1 docs
    [panda-es-b-bom.xls, panda-es-b-orcard.dsn]
